kinx-project/kint/(threads)

Thread 1 (2020-07-09):

Teensy LC (kintlc) QMK support

stapelberg, 2020-07-09:

stapelberg, 2021-06-30:
I’ll close this as there hasn’t been any user interest in the `kintlc` variant. Please describe in this issue if/why you’re interested in that model, instead of e.g. the `kint40` or `kint41`.

aleb, 2022-07-11:
I did it

TODO: update the documentation.

stapelberg, 2022-07-12:
Hooray 🎉 I have updated the README to link to the now-merged PR until QMK does another release.

Closed 2021-06-30.

Thread 3 (2020-07-09):

Teensy 3.5 (kint35) QMK support

stapelberg, 2020-07-09:

stapelberg, 2021-06-30:
I’ll close this as there hasn’t been any user interest in the `kintlc` variant. Please describe in this issue if/why you’re interested in that model, instead of e.g. the `kint40` or `kint41`.

Closed 2021-06-30.

Thread 5 (2020-07-09):

Teensy 4.1 (kint41) QMK support

stapelberg, 2020-07-09:
## Status

* [x] milestone: light up LED
* [x] milestone: print debug messages on the serial port
* [x] milestone: light up a LED from ChibiOS
* [x] milestone: print debug messages on the serial port from ChibiOS
* [x] ChibiOS tests are passing successfully!
* [x] milestone: USB stack used successfully from ChibiOS

## USB

* the Teensy 4.1 has two USB 2.0 OTG controllers
* I’m trying to make controller `USB1` (base address `0x402E0000`) work (eval board: the USB port right next to the ethernet port, called “USB OTG” in the documentation, teensy 4.1: the main and only USB port)
* There are 5 different USB implementations I know of:
  1. [NXP SDK (usb_device_dci.c)](https://github.com/Masmiseim36/nxpSDK/blob/391fa6796a57efe0c95b506be6644021b6364f75/middleware/usb/device/usb_device_dci.c)
      * supports KHCI (USB Full Speed)
      * supports EHCI (USB High speed, what the Teensy 4.1 uses)
      * supports LPC USB IP3511 FS
      * supports LPC USB IP3511 HS
  1. [Paul Stoffregen’s official Arduino Teensy 4 core (usb.c)](https://github.com/PaulStoffregen/cores/blob/master/teensy4/usb.c)
      * Uses the EHCI interface, but also uses the teensy register macros, not NXP’s CMSIS.
  1. [ChibiOS-Contrib Kinetis (hal_usb_lld.c)](https://github.com/ChibiOS/ChibiOS-Contrib/blob/chibios-20.3.x/os/hal/ports/KINETIS/LLD/USBHSv1/hal_usb_lld.c)
      * The KINETIS hal_usb_lld.c uses the KHCI interface, which is not available on the Teensy 4.1 anymore.
      * Maybe we need to create a hal_usb_lld.c that uses the EHCI interface.
  1. The [stack in libgreat](https://github.com/greatscottgadgets/libgreat/blob/master/firmware/platform/lpc43xx/drivers/usb/usb_queue.c) is more readable/descriptive, but not 100% sure about correctness—might be better to prefer the NXP stack for now.
  1. Tamago’s USB stack: https://github.com/f-secure-foundry/tamago/tree/master/soc/imx6/usb

## Building

* You need https://github.com/ChibiOS/ChibiOS/commit/3249070d416831189da73676219723c24de04934 or newer ([fixes the interrupt vector table alignment for teensy 4.1](http://www.chibios.com/forum/viewtopic.php?f=35&t=5554))
* My ChibiOS-Contrib WIP branch can be found at https://github.com/stapelberg/ChibiOS-Contrib/commits/teensy41

## Wiring/testing

1. Connect a USB-to-serial adapter to teensy 4.1 pins G (GND), 16 (RX) and 17 (TX).
1. Build and flash the ChibiOS-Contrib teensy 4.1 demo:
    ```
    cd ChibiOS-Contrib/demos/MIMXRT1062/RT-TEENSY4_1
    make
    teensy-loader-cli -w -v --mcu=TEENSY40 build/ch.hex
    ```
1. After turning on the teensy 4.1, you should see debug messages on the serial console, followed by the ChibiOS test suites.

stapelberg, 2020-09-19:
Status update: as of commit https://github.com/stapelberg/ChibiOS-Contrib/commit/c6d4537b6afbdb407f88526c0d5bdc72e7449c3a, the ChibiOS serial usb device enumerates in my tests, and can be opened, but no data is sent/received over any endpoint but 0.

This line is where the device hangs: https://github.com/stapelberg/ChibiOS-Contrib/blob/c6d4537b6afbdb407f88526c0d5bdc72e7449c3a/os/hal/ports/MIMXRT1062/LLD/USBHSv1/hal_usb_lld.c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

Full log:
```
ISR
  setup ep=0
clear_out_queue
clear_out_queue, endpoint = 20002000, t = 00000000
_usb_ep0setup()
usb_lld_read_setup
bmRequestType = 00000000, bRequest = 00000009, wValue = 00000001, wIndex = 00000000, wLength = 00000000
usbcfg.c:usb_event(event=2)
usb_lld_init_endpoint(ep=1)
  OUT endpoint (RX enable), mode=2, maxsize=64
  IN endpoint (TX enable), mode=2, maxsize=64
usb_lld_init_endpoint(ep=2)
  IN endpoint (TX enable), mode=3, maxsize=16
usb_lld_start_out(ep=1)
usb_packet_receive(n=256)
usb_transfer_schedule(endpoint=20002080, transfer=2000327C, n=256, primebit=2, notify=1)

  ERROR: too many prime attempts, aborting
[…]
```

stapelberg, 2020-12-29:
Status update: I managed to build a working firmware!

I pushed the various changes to GitHub for now, and will clean them up and send them upstream later as time permits.

You can try the current state using:

```
qmk clone -b kint41 kinx-project/qmk_firmware
qmk compile -kb kinesis/kint41 -km default
teensy-loader-cli -w -v --mcu=TEENSY40 .build/kinesis_kint41_default.hex
```

stapelberg, 2021-03-27:
Status update: https://github.com/ChibiOS/ChibiOS-Contrib/pull/246 is now ready for review, and all repositories have been updated based on the current QMK develop branch.

The instructions in https://github.com/kinx-project/kint/issues/5#issuecomment-751999435 remain valid for trying out the firmware.

mdempsky, 2021-05-02:
With ChibiOS/ChibiOS-Contrib#246 merged, what's the status of this issue? Is there still more to do for the 4.1 to be fully supported? Thanks.

stapelberg, 2021-05-03:
> With [ChibiOS/ChibiOS-Contrib#246](https://github.com/ChibiOS/ChibiOS-Contrib/pull/246) merged, what's the status of this issue? Is there still more to do for the 4.1 to be fully supported? Thanks.

If you’re okay with building from my repository instead of QMK’s, then I consider the kint41 fully supported. I have been using a kint41 as my daily driver for weeks now, and have not noticed any issues. I know there is at least one other user without any issues.

QMK itself tracks their own branch of ChibiOS-Contrib which lags behind upstream, so for proper upstream support, my changes first need to make it into that branch. I want to ask QMK to cherry-pick, but wanted to finish some related work on keyboard latency to make sure I don’t ask prematurely (in case my work identifies other changes needed). Will probably ask next week or so.

mdempsky, 2021-05-03:
SGTM, Teensy 4.1 ordered. Thanks!

tsharky, 2021-05-30:
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

Hey,
I can't compile kinesis boards from your fork on my windows machine.
Both 'kint41' and 'kint2pp' give me an unicode error.

````
Ψ Compiling keymap with make -j 1 kinesis/kint41:default

QMK Firmware 0.9.32
Making kinesis/kint41 with keymap default

ERROR 'charmap' codec can't decode byte 0x90 in position 1558: character maps to <undefined>
Traceback (most recent call last):
  File "C:/tools/qmk_msys/mingw64/lib/python3.8/site-packages/milc/milc.py", line 476, in __call__
    return self.__call__()
  File "C:/tools/qmk_msys/mingw64/lib/python3.8/site-packages/milc/milc.py", line 479, in __call__
    return self._subcommand(self)
  File "C:/Projects/qmk_firmware_kinx-project/lib/python/qmk/decorators.py", line 42, in wrapper
    return func(*args, **kwargs)
  File "C:/Projects/qmk_firmware_kinx-project/lib/python/qmk/decorators.py", line 85, in wrapper
    return func(*args, **kwargs)
  File "C:/Projects/qmk_firmware_kinx-project/lib/python/qmk/cli/generate/rules_mk.py", line 58, in generate_rules_mk
    kb_info_json = dotty(info_json(cli.config.generate_rules_mk.keyboard))
  File "C:/Projects/qmk_firmware_kinx-project/lib/python/qmk/info.py", line 57, in info_json
    info_data = merge_info_jsons(keyboard, info_data)
  File "C:/Projects/qmk_firmware_kinx-project/lib/python/qmk/info.py", line 476, in merge_info_jsons
    new_info_data = json_load(info_file)
  File "C:/Projects/qmk_firmware_kinx-project/lib/python/qmk/json_schema.py", line 18, in json_load
    return hjson.load(json_file.open())
  File "C:/tools/qmk_msys/mingw64/lib/python3.8/site-packages/hjson/__init__.py", line 117, in load
    return loads(fp.read(),
  File "c:/tools/qmk_msys/mingw64/lib/python3.8/encodings/cp1252.py", line 23, in decode
    return codecs.charmap_decode(input,self.errors,decoding_table)[0]
UnicodeDecodeError: 'charmap' codec can't decode byte 0x90 in position 1558: character maps to <undefined>
build_keyboard.mk:104: 'UnicodeDecodeError'>: No such file or directory
make[1]: *** No rule to make target ''UnicodeDecodeError'>'.  Stop.
Make finished with errors
make: *** [Makefile:530: kinesis/kint41:default] Error 1
````

I can compile 'kint2pp' from the official qmk project without issues.
Any chance you know how to fix it?

I'm new to Kinesis and QMK, so I have no clue where to look for differences between your fork and qmk.

Greetings!

stapelberg, 2021-05-30:
> I can compile 'kint2pp' from the official qmk project without issues.
> Any chance you know how to fix it?

I rebased the kint41 branch on top of the current QMK development branch.

Possibly that fixes your problem (given that you say compiling QMK itself works).

Can you try cloning again and see if compilation now works?

If no, does compilation of kint36 work from the QMK upstream `develop` branch for you?

cadusk, 2021-05-31:
My issue is related to pin names.
Before fetching latest, builds were working.

Now looks like pin names that don't match this criteria will fail:
`pin[0] in 'ABCDEFGHIJK' and pin[1].isdigit()`

Here's the output of the error message
```
Ψ Compiling keymap with make -j 1 kinesis/kint41:default

QMK Firmware 0.9.32
Making kinesis/kint41 with keymap default

⚠ Nonstandard pin format: LINE_PIN20
⚠ Nonstandard pin format: LINE_PIN21
☒ Invalid API data: kinesis/kint41: matrix_pins.cols.0: 'LINE_PIN20' is not valid under any of the given schemas
arm-none-eabi-gcc (Arch Repository) 11.1.0
Copyright (C) 2021 Free Software Foundation, Inc.
This is free software; see the source for copying conditions.  There is NO
warranty; not even for MERCHANTABILITY or FITNESS FOR A PARTICULAR PURPOSE.

⚠ Nonstandard pin format: LINE_PIN20
⚠ Nonstandard pin format: LINE_PIN21
☒ Invalid API data: kinesis/kint41: matrix_pins.cols.0: 'LINE_PIN20' is not valid under any of the given schemas
⚠ Nonstandard pin format: LINE_PIN20
⚠ Nonstandard pin format: LINE_PIN21
☒ Invalid API data: kinesis/kint41: matrix_pins.cols.0: 'LINE_PIN20' is not valid under any of the given schemas
⚠ Nonstandard pin format: LINE_PIN20
⚠ Nonstandard pin format: LINE_PIN21
☒ Invalid API data: kinesis/kint41: matrix_pins.cols.0: 'LINE_PIN20' is not valid under any of the given schemas
Compiling: keyboards/kinesis/kinesis.c                                                             <command-line>: fatal error: .build/obj_kinesis_kint41/src/info_config.h: No such file or directory
compilation terminated.
 [ERRORS]
 |
 |
 |
make[1]: *** [tmk_core/rules.mk:436: .build/obj_kinesis_kint41_default/keyboards/kinesis/kinesis.o] Error 1
Make finished with errors
make: *** [Makefile:530: kinesis/kint41:default] Error 1

```

Also, builds of `kint2pp` and `kint36` build just fine.

stapelberg, 2021-05-31:
Sorry about that. Turns out clean builds were broken, but my working copy still had the required files lying around so I didn’t notice.

I pushed the old version for now, until I can properly fix the pin issue.

stapelberg, 2021-05-31:
Posted https://github.com/qmk/qmk_firmware/issues/13052 upstream to ask about how to approach the pin naming issue.

cadusk, 2021-05-31:
Thanks, Michael. It builds fine now.

stapelberg, 2021-06-02:
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

You can now find these changes in the `kint41-upstream` branch: https://github.com/kinx-project/qmk_firmware/commits/kint41-upstream

stapelberg, 2021-06-02:
Upstreaming status: the required core QMK pull requests have been sent:

* https://github.com/qmk/qmk_firmware/pull/13076
* https://github.com/qmk/qmk_firmware/pull/13077
* https://github.com/qmk/qmk_firmware/pull/13078

Once we figure out in https://github.com/qmk/qmk_firmware/issues/13052 what the pin defines should be called for the Teensy 4.x, I can update and send the kint41 keyboard addition itself upstream :)

tsharky, 2021-06-25:
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

For me it still did not build on a windows machine (upstream branch as well). In the meanwhile I worked with kint41 branch on a fedora vm and arch linux. That worked fine.

stapelberg, 2021-06-25:
> For me it still did not build on a windows machine (upstream branch as well)

You might want to file an issue at https://github.com/qmk/qmk_firmware/issues about that, then

stapelberg, 2021-06-30:
Support for the Teensy 4.0 and Teensy 4.1 (both via the `kint41` target) has been added to QMK in commit https://github.com/qmk/qmk_firmware/commit/f533d9e033e59d1eb98cc61fdb5f01eeccb827de (`develop` branch)! 🎉

gr4yscale, 2021-07-06:
@stapelberg Thanks for your work on this, and the previous iterations of the kinT board. I successfully compiled QMK for a Teensy 2.0++ with the `kint2pp` from master branch of `qmk/qmk_firmware`, and just love it! I got a Teensy 4.1 + kinT for my 2nd Kinesis, not having as much luck...

I compiled your fork [with the previous instructions](https://github.com/kinx-project/kint/issues/5#issuecomment-751999435), but I had an issue with bottom row keys not working - could be hw, but I wanted to first compile from the `develop` branch of `qmk/qmk_firmware`.

*develop branch of qmk_firmware seems very tricky to work with* It seems that the supported sub-commands such as `qmk compile` do not exist for develop branch. Using `qmk clone -b develop` to try to get the official branch doesn't help things, either. So it seems that `make` is the only supported way to build firmware on develop branch, which would be fine, except it seems broken? I've followed their [docs for the Makefile](https://beta.docs.qmk.fm/developing-qmk/qmk-reference/getting_started_make_guide).

This is more of a QMK question, but maybe you've encountered this. I've looked around a bit, no one seems to have problems using the develop branch. Furthermore, official tooling (qmk cli tool) seems to not approve of the `develop` branch:

```Path '/home/gr4yscale/qmk_firmware' exists but is not a qmk_firmware clone!```

It seems that the [version check line](https://github.com/qmk/qmk_firmware/blob/develop/Makefile#L559) in Makefile is causing a problem. I tried using `SKIP_VERSION=true`. Actually I see that the problem is with the `qmk_cli` tool which they call into using the `Makefile` to call into some python code. Mine is from the AUR (source repository for arch linux package) but maybe the problem is that it's out of sync with dev branch of qmk_firmware, but I don't see a dev branch, or any new commits on [qmk_cli master](https://github.com/qmk/qmk_cli/commits/master).

Actually, in writing this up, I discovered that [they very recently changed something about how they're parsing args](https://github.com/qmk/qmk_firmware/pull/13151). Probably something broke there. I tried reverting, since your changes came in after this:

```
❯ git revert bbe43a91ebf193bbc8c09ba59209b0524367e68c
Removing lib/python/qmk/cli/generate/version_h.py
[develop c709b4ee0] Revert "CLI: Add subcommand to generate version.h (#13151)"
 5 files changed, 45 insertions(+), 79 deletions(-)
 delete mode 100644 lib/python/qmk/cli/generate/version_h.py
```

Before reverting this, I got the following output:

```
❯ make kinesis/kint41:default:flash
QMK Firmware 0.13.5
usage: qmk [-h] [-V] [-v] [--datetime-fmt DATETIME_FMT] [--log-fmt LOG_FMT]
           [--log-file-fmt LOG_FILE_FMT]
           [--log-file-level {debug,info,warning,error,critical}]
           [--log-file LOG_FILE] [--color] [--no-color] [--unicode]
           [--no-unicode] [--interactive] [--config-file CONFIG_FILE]
           {config,clone,env,setup} ...
**qmk: error: argument {config,clone,env,setup}: invalid choice: 'generate-version-h' (choose from 'config', 'clone', 'env', 'setup')**
```

**Can you please tell me what version of `qmk_cli` you have?**

```
❯qmk -V
0.0.51

~/qmk_firmware develop ⇡
❯ make kinesis/kint41:default
QMK Firmware 0.13.19
ERROR: Cannot run "qmk hello"!

 Please run qmk setup to install all the dependencies QMK requires.

make: *** [Makefile:512: kinesis/kint41:default] Error 1

~/qmk_firmware develop ⇡
❯ qmk setup
☒ Path '/home/gr4yscale/qmk_firmware' exists but is not a qmk_firmware clone!
```
Note that I'm also always getting complaints about "qmk hello", and searching the qmk_cli repo on GH does not show anything about "hello"...

This is a nightmare! I have an injured hand, this is not helping, since my backup kinesis is at the office. Getting the other keyboard going was much much smoother. I am considering driving 30 minutes away to buy a teensy 2.0++ tomorrow and to desolder the Teensy 4.1. :(

Thanks in advance for any help.

stapelberg, 2021-07-06:
> compiled your fork [with the previous instructions](https://github.com/kinx-project/kint/issues/5#issuecomment-751999435), but I had an issue with bottom row keys not working - could be hw

Most likely. All keys should be working in all of the published firmware revisions.

> It seems that the supported sub-commands such as `qmk compile` do not exist for develop branch

This is not what I’m seeing:

```
~/kinx/workspace/qmk_firmware develop % qmk compile -km stapelberg -kb kinesis/kint41    
Ψ Compiling keymap with make -j 1 kinesis/kint41:stapelberg

QMK Firmware 0.13.19
Making kinesis/kint41 with keymap stapelberg

arm-none-eabi-gcc (Arch Repository) 11.1.0
Copyright (C) 2021 Free Software Foundation, Inc.
This is free software; see the source for copying conditions.  There is NO
warranty; not even for MERCHANTABILITY or FITNESS FOR A PARTICULAR PURPOSE.

Size before:
   text	   data	    bss	    dec	    hex	filename
      0	  36446	      0	  36446	   8e5e	.build/kinesis_kint41_stapelberg.hex

Compiling: quantum/command.c                                                                        [OK]
Linking: .build/kinesis_kint41_stapelberg.elf                                                       [OK]
Creating binary load file for flashing: .build/kinesis_kint41_stapelberg.bin                        [OK]
Creating load file for flashing: .build/kinesis_kint41_stapelberg.hex                               [OK]

Size after:
   text	   data	    bss	    dec	    hex	filename
      0	  36446	      0	  36446	   8e5e	.build/kinesis_kint41_stapelberg.hex

Copying kinesis_kint41_stapelberg.bin to qmk_firmware folder                                        [OK]
(Firmware size check does not yet support cortex-m4 microprocessors; skipping.)
```

Try uninstalling all QMK packages from the AUR, then install the QMK CLI from your repo as per the QMK instructions (using pip).

You can always consider starting a different Linux distribution using docker, too, and building there.

gr4yscale, 2021-07-06:
@stapelberg Some good news (and apologies for the longreads + frustration!) Compiling from `develop`

Apparently `pip` version of `qmk_cli` is out of date. The version that I get from [Arch User Repository](https://aur.archlinux.org/packages/qmk-git/) is correct. Still surprised why I didn't see anything searching with GH search tool for "hello" ...perhaps case sensitivity, I didn't clone and `ack` or `grep` it.

Apparently `qmk setup` or something else installed the `pip` version behind my back... After removing that, and hacking the `Makefile` temporarily to reference `/usr/bin/qmk` things are moving...

```
make -d kinesis/kint41:default
...
Successfully remade target file 'kinesis/kint41:default'.
```

**I also needed to not invoke make with sudo, to get the qmk bin to be found. Will check into that.**

```
❯ qmk hello
Ψ Hello, World!
```

I see your message came through after I wrote this. Thank you for the quick response! Actually, I had tried removing the QMK packages from AUR first, and went with straight `pip` packages, but was having troubles. Still, that is the most logical to me as well. I'll build up a clean dev environment using docker as you suggest.

Thanks again for the quick help! You're amazing. I'll now move on to testing those bottom row keys...it's likely just the jumper cable not tucked in tightly, I believe the solder joints are good.

One more quick question: ** I noticed that we can't enable console with `CONSOLE_ENABLE = yes`, which means no using `hid_listen` for debugging - at least that was the case in your previous fork. Is that now resolved? **

gr4yscale, 2021-07-06:
@stapelberg Just to say thanks again, and that I noticed that you (or someone) managed to get console debugging working with `CONSOLE_ENABLE = yes`, which means it's now possible to use `hid_listen` for debugging - in the previous fork, it was causing the kb to be unresponsive.

Great work! :) Let me know if I can test anything or help in any way with any remaining tasks.

gr4yscale, 2021-07-06:
@stapelberg Indeed the column 4 missing was a bad solder joint, probably broke after I cut pin headers down.

Thanks to your diligent work on the silk screens and schematic, it was a breeze to identify the offending connection.

Very inspiring stuff; I am ready to try designing a board with KiCad. Learned a lot of theory and some basics of eagle, but KiCad is much more appealing given that it's FOSS and thus easier to learn in together with a group.

Thanks again!

stapelberg, 2021-07-07:
Glad to hear you could get it to work 👍

tamsky, 2021-07-24:
> @stapelberg Just to say thanks again, and that I noticed that you (or someone) managed to get console debugging working with CONSOLE_ENABLE = yes, which means it's now possible to use hid_listen for debugging - in the previous fork, it was causing the kb to be unresponsive.

I'm currently unable to get CONSOLE_ENABLE working on a teensy 4.0.

Compiling your qmk kinesis/kint41 with `CONSOLE_ENABLE = yes` set in the `rules.mk` file,
neither `qmk console` nor `hid_listen` are able to connect to the kint41 firmware after it boots.

Only when I press the teensy's reset button while running `qmk console`, it does print anything other than "Looking for devices..."
```
Looking for devices...                                                                       
<hit reset button on teensy here>
Ψ Bootloader Connected: halfkay: Teensy Halfkay
```

Questions:

- Are there a set of steps that can help confirm that `CONSOLE_ENABLE = yes` is having the intended effect on the resulting qmk Teensy 4.0 firmware ?
- Perhaps there's an additional USB device that should show up when it's working as expected?  How to identify it?
- What's the correct tool to use to listen to the enabled console's debug messages?
   `hid_listen` apparently does not directly support anything other than teensy 2.x boards (and earlier).

stapelberg, 2021-07-24:
> Compiling your qmk kinesis/kint41 with `CONSOLE_ENABLE = yes` set in the `rules.mk` file,

In which rules.mk file specifically are you putting this line?

For me, it did not work in `keyboards/kinesis/kint41/rules.mk`, but it worked in my custom keymap `keyboards/kinesis/keymaps/stapelberg/rules.mk`

tamsky, 2021-07-24:
Amazing and helpful news.  Thank you.

Yes, I was adding `CONSOLE_ENABLE = yes` to `keyboards/kinesis/kint41/rules.mk`, because none of the docs specify to add it to the `.../keymaps/*/rules.mk`.   Both `qmk console` and `hid_listen` now work as expected.

Would you consider this a makefile or QMK bug -- should I report it upstream?

----
Now I can proceed to debug my Row/Col issues using your code from
https://michael.stapelberg.ch/posts/2021-05-08-keyboard-input-latency-qmk-kinesis/
```c
void keyboard_post_init_user() {
  debug_config.enable = true;
  debug_config.matrix = true;
}
```

tamsky, 2021-07-24:
> > hid_listen apparently does not directly support anything other than teensy 2.x boards (and earlier).
>
> AFAIR, `hid_listen` works just as well with the newer Teensy models.

I agree it's now working for me, but I'm definitely also curious what you think of Paul's reply here on this topic:
- https://forum.pjrc.com/threads/67784-Is-Teensy-4-0-compatible-with-hid_listen?p=284301&viewfull=1#post284301

stapelberg, 2021-07-25:
> Would you consider this a makefile or QMK bug -- should I report it upstream?

Yes, please report this upstream. I don’t know why it only works in one place, and ran into this issue myself :)

> I agree it's now working for me, but I'm definitely also curious what you think of Paul's reply here on this topic:

I think Paul’s talking about out hid_listen working *of the box* with the Teensy software stack. QMK already provides a bunch of different USB devices regardless of the underlying stack, and can easily keep doing that regardless of what the Teensy stack does. On the USB protocol level, the hid_listen approach works fine even for non-Teensy microcontrollers.

gregschlom, 2021-08-06:
I'm getting the following error when I try to compile :

/lib/chibios-contrib/os/common/startup/ARMCMx/devices/MIMXRT1062/cmparams.h:70:24: fatal error: MIMXRT1062.h: No such file or directory

This is on branch `develop` of QMK, compiling with `qmk compile -km stapelberg -kb kinesis/kint41`

Any help would be appreciated!

stapelberg, 2021-08-06:
> EDIT: Nevermind, the issue was that I was building from QMK's repo. Switching to kinx-project/qmk_firmware fixed the issue.

No, you should be able to build from QMK’s repo. The kinx-project/qmk_firmware repo is not maintained (it’s old).

Your build issue sounds like you didn’t have all the submodules set up correctly. `make git-submodule` should probably fix this.

brandondees, 2021-10-30:
From the above it seemed as if just running this from the normal QMK repo should be expected to work now, but it seems like something's missing here.

```
$ qmk flash -kb kinesis/kint41 -km default
Ψ Compiling keymap with make --jobs=1 kinesis/kint41:default:flash

QMK Firmware 0.14.29
Making kinesis/kint41 with keymap default and target flash

arm-none-eabi-gcc.exe (GCC) 10.1.0
Copyright (C) 2020 Free Software Foundation, Inc.
This is free software; see the source for copying conditions.  There is NO
warranty; not even for MERCHANTABILITY or FITNESS FOR A PARTICULAR PURPOSE.

Size before:
   text    data     bss     dec     hex filename
      0   39542       0   39542    9a76 .build/kinesis_kint41_default.hex

Compiling: quantum/command.c                                                                        [OK]
Linking: .build/kinesis_kint41_default.elf                                                          [OK]
Creating binary load file for flashing: .build/kinesis_kint41_default.bin                           [OK]
Creating load file for flashing: .build/kinesis_kint41_default.hex                                  [OK]
Copying kinesis_kint41_default.hex to qmk_firmware folder                                           [OK]

Size after:
   text    data     bss     dec     hex filename
      0   39542       0   39542    9a76 .build/kinesis_kint41_default.hex

Unknown MCU type "imxrt1062"
Supported MCUs are:
 - at90usb162
 - atmega32u4
 - at90usb646
 - at90usb1286
 - mkl26z64
 - mk20dx128
 - mk20dx256
 - mk66fx1m0
 - mk64fx512
make[1]: *** [platforms/chibios/flash.mk:82: flash] Error 1
Make finished with errors
make: *** [Makefile:510: kinesis/kint41:default:flash] Error 1
[Brandon@DESKTOP-JDED116 qmk_firmware]$
```

I'll probably go ahead and try the kinx-project fork next since that sounds like it should more definitely be able to work but I'd appreciate any help troubleshooting for this or else guidance on how to get whatever's the current best-available level of feature support.

BTW thanks @stapelberg for the excellent kit.

stapelberg, 2021-10-31:
> From the above it seemed as if just running this from the normal QMK repo should be expected to work now, but it seems like something's missing here.

Yeah, it should definitely be expected to work.

If building from the official QMK doesn’t work for anyone, it’s often best to check there for issues, or just try building an older version of QMK :)

For your specific case, this error message:

> Unknown MCU type "imxrt1062"
> Supported MCUs are:

…sounds like it comes from the teensy-loader-cli program: https://www.pjrc.com/teensy/loader.html

Are you sure you have a recent-enough version installed? Sounds like the one you have doesn’t know about the Teensy 4 yet.

brandondees, 2021-10-31:
Ah thanks for that clue, I would never have made the connection. Looking into how to get latest teensy loader within QMK MSYS now...

Closed 2021-06-30.

Thread 6 (2020-08-01):

Bluetooth

SleepyBrett, 2020-08-01:
Whats the possibility of a slightly more complicated board (may require a multiplexer) with bluetooth support and lipo charging through the usb port? The adafruit feather has a nice through port lipo charging feature (though I think I did a pincount on the feather w/ bluetooth and found that a multiplexer would be required.

Other features that would be awesome, support of the built in LED windows, maybe with rgb leds.

As an aside, I'm super happy to see this rev to the old stapleberg board, I've got two modded advantage 1s and they make me very happy.

stapelberg, 2020-08-01:
> Whats the possibility of a slightly more complicated board (may require a multiplexer) with bluetooth support and lipo charging through the usb port? The adafruit feather has a nice through port lipo charging feature (though I think I did a pincount on the feather w/ bluetooth and found that a multiplexer would be required.

You’re welcome to build such a board based on this one, but I personally have neither time nor motivation to do bluetooth for my keyboards :)

> Other features that would be awesome, support of the built in LED windows, maybe with rgb leds.

What do you mean? The caps lock/numlock/keypad/scroll lock LEDs already are supported

> As an aside, I'm super happy to see this rev to the old stapleberg board, I've got two modded advantage 1s and they make me very happy.

Very glad to hear! Enjoy :)

SleepyBrett, 2020-08-01:
gotcha on the LEDs I saw the pads on the old stapleberg board but could never quite got around to making them work.

I'll let you know if I make any progress on the bluetooth!

stapelberg, 2020-08-02:
> gotcha on the LEDs I saw the pads on the old stapleberg board but could never quite got around to making them work.

Ah, alright! With the new revision, I know that they are working for sure, so let me know if you run into any trouble and we should be able to figure it out :)

Closed 2020-08-01.

Thread 7 (2020-08-08):

RESET quantum keycode does not work with Teensy 3.6

ameyp, 2020-08-08:
I've modded my Advantage 1 with a Teensy 3.6 and the RESET [quantum keycode](https://beta.docs.qmk.fm/using-qmk/simple-keycodes/quantum_keycodes) doesn't seem to work. When I run `qmk flash` and qmk is at `Waiting for Teensy device... (hint: press the reset button)`, sending the RESET keycode with a keypress doesn't put the board in bootloader mode and I have to press the physical button to allow flashing to proceed.

stapelberg, 2020-08-09:
Thanks for the report. I indeed never tested this, because I had just assumed that reset is only for restarting the keyboard, not for reprogramming it :)

https://www.pjrc.com/teensy/jump_to_bootloader.html is relevant, but doesn’t contain an address for the Teensy 3.6.

Let me see if this might be an easy fix.

stapelberg, 2020-08-09:
Looks like on the Teensy 3.x, we need to call the BKPT instruction: https://forum.pjrc.com/threads/30521-Rebooting-Teensy-(LC-3-0)-to-bootloader-without-Teensyduino

stapelberg, 2020-08-09:
I think commit https://github.com/kinx-project/qmk_firmware/commit/bb8ab07b477b8de7175db24a04e1a3569028da98 might help, but can’t test it right now. Can you `git pull` in your branch, recompile, reflash, and try again?

stapelberg, 2020-08-09:
Just had a chance to test, and with the commit, the QK_RESET keycode jumps to the bootloader for me :)

ameyp, 2020-08-09:
Works for me too, thanks!

lread, 2023-08-05:
Oh, this is cool, I can flash via my Teensy without having to press the button on the Teensy?

I think `RESET` might have since been renamed to `QK_BOOTLOADER` in [commit](https://github.com/qmk/qmk_firmware/commit/b45a037c7edcd9c1cfadceb69ed51e7d42aa58c1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).

lread, 2023-08-05:
Oh. Interesting, I see `QK_BOOT` is now mapped to the `prgm` key in the default `keymap.c`.

lread, 2023-08-05:
And it actually works! Noice!

@stapelberg This is very handy, especially for folks who put the screws back in their keyboards! I'm happy to add a note to the README, if you agree that makes sense.

stapelberg, 2023-08-06:
> @stapelberg This is very handy, especially for folks who put the screws back in their keyboards! I'm happy to add a note to the README, if you agree that makes sense.

Sure, I guess? This is a standard QMK feature, so a quick note with a link to their documentation should be sufficient.

lread, 2023-08-06:
Thanks for the reply! Because my motivation was to get my failing Advantage2 working again, I came to your project first first and then learned a bit about QMK. Maybe other folks come in knowing about QMK first. Anyway, your video really helped me with understanding how to solder things up and then flash. But, after watching it, maybe I missed it, but I naively never realized I could press a keyboard key to flash. I'll add a wee tip for other poor sods like me.

Closed 2020-08-09.

Thread 8 (2020-08-18):

Settings not persisted to EEPROM for Teensy 3.6

ameyp, 2020-08-18:
I've been using the `set_single_persistent_default_layer` function to switch base layers but the changes aren't persisted to EEPROM. I've also wired up a small LED strip and my understanding is that changes to RGB lights are persisted to EEPROM by QMK, but that's not working either. I believe QMK doesn't understand how to use the Teensy 3.6's EEPROM.

stapelberg, 2020-08-18:
Thanks for filing this.

Your guess that QMK doesn’t understand how to use the Teensy 3.6 EEPROM sounds the most likely to me, too.

I’ll try and take a look at what would need to be changed in the next few days as time permits.

stapelberg, 2020-08-24:
Can you update your branch so that commit https://github.com/kinx-project/qmk_firmware/commit/1f84198750751dded9e12626b725df94aa33c875 is included and try again?

For me, this looks like it might be enough to make the EEPROM work, but I have only done a very quick test.

ameyp, 2020-08-24:
For me it made the controller not boot up. None of the keys were responding, and even the ON led on the teensy was off.

stapelberg, 2020-08-24:
Can you try it with these changes please (changing CPU speed from 180MHz to 120MHz)?

```diff
modified   keyboards/kinesis/kint36/mcuconf.h
@@ -28,12 +28,12 @@

 /* PEE mode - 180 MHz system clock driving by 16 MHz xtal */
 #define KINETIS_MCG_MODE KINETIS_MCG_MODE_PEE
-#define KINETIS_PLLCLK_FREQUENCY 180000000UL  // 180 MHz (HSRUN)
-//#define KINETIS_PLLCLK_FREQUENCY 120000000UL  // 120 MHz (RUN)
+//#define KINETIS_PLLCLK_FREQUENCY 180000000UL  // 180 MHz (HSRUN)
+#define KINETIS_PLLCLK_FREQUENCY 120000000UL  // 120 MHz (RUN)
 #define KINETIS_SYSCLK_FREQUENCY KINETIS_PLLCLK_FREQUENCY
 #define KINETIS_BUSCLK_FREQUENCY 60000000UL
-#define KINETIS_FLASHCLK_FREQUENCY 28000000UL  // 28 MHz (HSRUN)
-//#define KINETIS_FLASHCLK_FREQUENCY 24000000UL  // 24 MHz (RUN)
+//#define KINETIS_FLASHCLK_FREQUENCY 28000000UL  // 28 MHz (HSRUN)
+#define KINETIS_FLASHCLK_FREQUENCY 24000000UL  // 24 MHz (RUN)

 #if KINETIS_PLLCLK_FREQUENCY == 180000000UL
 #    define KINETIS_CLKDIV1_OUTDIV1 1  // -> 0
```

ameyp, 2020-08-24:
Tried with those changes, same behavior. Are there any debug prints I can provide that might help you see what the MCU is doing?

stapelberg, 2020-08-24:
Not that I know of :-/

One thing you can try is whether the example EEPROM programs that come with https://www.pjrc.com/teensy/td_download.html work on your device. Specifically `eeprom_put` and `eeprom_get`.

Maybe one needs to run these first before the EEPROM starts working? Worth a try.

ameyp, 2020-08-25:
Tried running both examples, both passed and I saw success prints in the serial monitor after the _get sample. Also it seems to have changed something in my teensy: now when I flash a firmware built with this commit, the keyboard boots up and keys work. However, EEPROM still doesn't seem to be working at either frequency (layout isn't persisted across reboots) and some other funkiness happens, e.g. my `backspace` keycode is sent as a `\` instead.

stapelberg, 2020-08-25:
> Also it seems to have changed something in my teensy

Thanks for confirming. I have read that EEPROM partitioning might be a step that leaves behind a persistent change, but will need to read up on what exactly that means for us here.

> However, EEPROM still doesn't seem to be working at either frequency (layout isn't persisted across reboots

I wonder if this means that writing to the EEPROM doesn’t work yet, or if it’s something else entirely.

> some other funkiness happens, e.g. my `backspace` keycode is sent as a `\` instead.

Weird! Not sure why that is yet.

waitnextevent, 2020-10-09:
After reading the docs for the MK66FX1M0VMD18 and FlexMemory application notes, I've been wondering if it may make more sense in the context of the keyboard controller to use the FlexNVM module in the default D-Flash mode instead of partitioning it into EEE ("enhanced EEPROM") when servicing the QMK EEPROM r/w routines.

It's all the same flash memory; from what I gather applications in E-Flash mode are for very frequently changing data where the EEE state machine will spread out the memory's finite number of read/write cycles over a larger area (such as using 256k of of flash as a smaller 4k EEPROM block). When instead used in D-Flash mode, one can leverage the entire capacity of the chip and not have to partition it beyond the default (unless somebody has already partitioned their Teensy, at least). I doubt keyboard users will need the up to 100 million write cycles spec'd for the EEE config..

I'm looking to see if I can bring up the Via feature for QMK on the Teensy 3.6, which lets you update the keymap without having to recompile all the time (as the stock Kinesis fw nicely allows). Via also uses the QMK EEPROM abstractions and could benefit from having more memory available.

Seems to me the routines to write to EEPROM in QMK really mean "write to some sort of persistence on the chip" rather than "write to something the chip calls EEPROM literally",  meaning the EEPROM r/w calls could equally be implemented againt D-Flash for the board.

Thoughts?

stapelberg, 2020-10-09:
Thanks very much for investigating and weighing in!

What you write makes sense to me—any persistence should do, yes.

Please give your approach a try and share what you learn :)

stapelberg, 2021-05-18:
I have pushed branch https://github.com/stapelberg/qmk_firmware/commits/kint36-eeprom which makes the EEPROM work.

In case anyone wants to try it out and confirm that it works for them, that’d be much appreciated!

Thread 10 (2020-08-23):

Teensy 3.6 (kint36) advanced QMK features umbrella bug

stapelberg, 2020-08-23:
The following features are either known to not work, or have not yet been successfully tested yet:

* [x] EEPROM, for persistent settings
* [ ] [Audio](https://beta.docs.qmk.fm/using-qmk/hardware-features/feature_audio)
* [x] [RGB LED lighting](https://beta.docs.qmk.fm/using-qmk/hardware-features/lighting/feature_rgblight)

ameyp, 2020-08-25:
I've got RGB LED lighting working with this:

```
#define STM32_SYSCLK KINETIS_SYSCLK_FREQUENCY
#define NOP_FUDGE 0.4
#define RGB_DI_PIN LINE_PIN28
```

stapelberg, 2021-05-20:
> I've got RGB LED lighting working with this:

Thank you, @ameyp, I can confirm that RGB LED works for me, too!

I have filed https://github.com/kinx-project/kint/issues/36 for the audio support and will close this umbrella bug.

Closed 2021-05-20.

Thread 11 (2020-08-24):

Best way to connect thumb keys on k500

ecraven, 2020-08-24:
I've had a close look at the k500, I think I can probably unsolder the directly soldered connections for the thumb keys. You've kindly provided pin headers on your board, but is there some nice way to have a connector, not directly solder things together?
Thanks for any help with these questions ;)

stapelberg, 2020-08-24:
On the KB500, your best bet is to cut the cable (don’t bother unsoldering) and solder each pin to a pin header, like so:

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

ecraven, 2020-08-31:
great, that's what I've done, it works very well. Thanks!

jcbird, 2021-06-13:
Sorry to comment on a closed issue. But could you send a link to the exact part you used? Is this just a female header with the pins soldered to the pcb? Thank you so much!

stapelberg, 2021-06-13:
Yep, that’s all there is to it.

https://www.digikey.ch/product-detail/en/PPTC241LFBN-RC/S7022-ND/810162 is the part I used last time.

jcbird, 2021-06-13:
Thank you!

MrDeerly, 2023-03-07:
Sorry to dig out this old thread again, but there is still some unclarity for me.

Are the female connectors mentioned above plugged into the [Würth 61301011121](https://octopart.com/61301011121-w%C3%BCrth+elektronik-18818159?r=sp) and soldered to the cable, or are the connectors soldered to the board and the cable just plugged in?

In addition to that, would it be an option to solder the cable directly to the pin headers (i guess that's not what they're here for), or the board?

Last but not least, do you have any tips on how to strip the cable for the thumb keys? :)

Thanks in advance!

thatdutchguy, 2023-03-26:
In case someone else is wondering, I just went through this (kb500 usb) and I'll share my experiences:

> Sorry to dig out this old thread again, but there is still some unclarity for me.
>
> Are the female connectors mentioned above plugged into the [Würth 61301011121](https://octopart.com/61301011121-w%C3%BCrth+elektronik-18818159?r=sp) and soldered to the cable, or are the connectors soldered to the board and the cable just plugged in?

They are soldered to the cable, then plug into the pin headers on the KinT PCB.

> > `[kinT] --soldered-- [male headers] --plugged-- [female headers] --soldered-- [stock cable] --soldered-- [PCB]`

Yes, I think that's the way it is intended to be used.

> > `[kinT] --soldered-- [female headers] --plugged-- [stock cable] --soldered-- [PCB]`

The wires are pretty thin, so I don't think this would work well.

> In addition to that, would it be an option to solder the cable directly to the pin headers (i guess that's not what they're here for), or the board?

> > `[kinT] --soldered-- [male headers] --soldered-- [stock cable] --soldered-- [PCB]`
> > OR
> > `[kinT] --soldered-- [stock cable] --soldered-- [PCB]`

I suppose this would work but it would be kind of cumbersome/harder than using the female headers.

> Last but not least, do you have any tips on how to strip the cable for the thumb keys? :)

I cut into the strip lengthwise next to each wire a bit, then used a simple wire stripper (see images below). It's not elegant but it works 🙂.

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

Hope this helps

Closed 2020-08-31.

Thread 12 (2020-08-31):

Debugging problems with device showing up, but no keypresses registering.

ecraven, 2020-08-31:
Hello ;)
Just finished building one (kb500 with kint36). I left the thumb pads disconnected, but connected everything else, cloned your firmware branch, flashed it. The keyboard shows up, however pressing any button does nothing at all. Is there some way to debug this?
[working on arch linux, everything current. avr-gcc is 10 (which qmk warns about), but I don't think I have an older one to install :-/]
The device itself shows up fine in xinput and dmesg.
Thanks for any help!

stapelberg, 2020-08-31:
You’re referencing a branch, so I assume you’re talking about the Teensy 3.6 variant.

Can you try flashing the firmware files referenced in https://github.com/kinx-project/kint#installing-the-firmware using https://aur.archlinux.org/packages/teensy-loader/?

Also, what is the dmesg output when you connect the keyboard?

stapelberg, 2020-08-31:
Did you solder in LEDs? If yes, try enabling Caps Lock using your currently working keyboard while the kint36 is connected, too: you should see both the LEDs on your current keyboard *and* the LEDs on the kint36 light up as well.

ecraven, 2020-08-31:
Just tried flashing the hex files, and those seem to work ;) great!

So the problem seems to be my compiling / flashing, not the hardware.

Caps-Lock light up the led on my current keyboard, but not the one on the new board. The LEDs have a bar on the underside, I put that bar in the same direction as the bar in the LED symbol on the silkscreen, is that correct?

ecraven, 2020-08-31:
dmesg -T output:
```[Mon Aug 31 22:25:48 2020] usb 2-3: new full-speed USB device number 31 using xhci_hcd
[Mon Aug 31 22:25:48 2020] usb 2-3: New USB device found, idVendor=1209, idProduct=345c, bcdDevice= 0.01
[Mon Aug 31 22:25:48 2020] usb 2-3: New USB device strings: Mfr=1, Product=2, SerialNumber=3
[Mon Aug 31 22:25:48 2020] usb 2-3: Product: "https://github.com/kinx-project/kint"
[Mon Aug 31 22:25:48 2020] usb 2-3: Manufacturer: "https://github.com/stapelberg"
[Mon Aug 31 22:25:48 2020] usb 2-3: SerialNumber: 0
[Mon Aug 31 22:25:48 2020] input: "https://github.com/stapelberg" "https://github.com/kinx-project/kint" as /devices/pci0000:00/0000:00:14.0/usb2/2-3/2-3:1.0/0003:1209:345C.0024/input/input43
[Mon Aug 31 22:25:48 2020] hid-generic 0003:1209:345C.0024: input,hidraw4: USB HID v1.11 Keyboard ["https://github.com/stapelberg" "https://github.com/kinx-project/kint"] on usb-0000:00:14.0-3/input0
[Mon Aug 31 22:25:48 2020] input: "https://github.com/stapelberg" "https://github.com/kinx-project/kint" Mouse as /devices/pci0000:00/0000:00:14.0/usb2/2-3/2-3:1.1/0003:1209:345C.0025/input/input44
[Mon Aug 31 22:25:48 2020] input: "https://github.com/stapelberg" "https://github.com/kinx-project/kint" System Control as /devices/pci0000:00/0000:00:14.0/usb2/2-3/2-3:1.1/0003:1209:345C.0025/input/input45
[Mon Aug 31 22:25:48 2020] input: "https://github.com/stapelberg" "https://github.com/kinx-project/kint" Consumer Control as /devices/pci0000:00/0000:00:14.0/usb2/2-3/2-3:1.1/0003:1209:345C.0025/input/input46
[Mon Aug 31 22:25:48 2020] input: "https://github.com/stapelberg" "https://github.com/kinx-project/kint" Keyboard as /devices/pci0000:00/0000:00:14.0/usb2/2-3/2-3:1.1/0003:1209:345C.0025/input/input47
[Mon Aug 31 22:25:48 2020] hid-generic 0003:1209:345C.0025: input,hidraw5: USB HID v1.11 Mouse ["https://github.com/stapelberg" "https://github.com/kinx-project/kint"] on usb-0000:00:14.0-3/input1
```

ecraven, 2020-08-31:
Flashing my own compiled version:
```> QMK_HOME=/home/.../qmk_firmware qmk flash -kb kinesis/kint36 -km default
Ψ Compiling keymap with make kinesis/kint36:default:flash

QMK Firmware 0.9.32
Making kinesis/kint36 with keymap default and target flash

arm-none-eabi-gcc (Arch Repository) 10.2.0
Copyright (C) 2020 Free Software Foundation, Inc.
This is free software; see the source for copying conditions.  There is NO
warranty; not even for MERCHANTABILITY or FITNESS FOR A PARTICULAR PURPOSE.

Size before:
   text	   data	    bss	    dec	    hex	filename
      0	  22792	      0	  22792	   5908	.build/kinesis_kint36_default.hex

Compiling: tmk_core/common/command.c                                                                [OK]
Linking: .build/kinesis_kint36_default.elf                                                          [WARNINGS]
 |
 | /usr/lib/gcc/arm-none-eabi/10.2.0/../../../../arm-none-eabi/bin/ld:rules_memory.ld:285: warning: memory region `flash4' not declared
 | /usr/lib/gcc/arm-none-eabi/10.2.0/../../../../arm-none-eabi/bin/ld:rules_memory.ld:293: warning: memory region `flash5' not declared
 | /usr/lib/gcc/arm-none-eabi/10.2.0/../../../../arm-none-eabi/bin/ld:rules_memory.ld:301: warning: memory region `flash6' not declared
 | /usr/lib/gcc/arm-none-eabi/10.2.0/../../../../arm-none-eabi/bin/ld:rules_memory.ld:310: warning: memory region `flash7' not declared
 |
Creating binary load file for flashing: .build/kinesis_kint36_default.bin                           [OK]
Creating load file for flashing: .build/kinesis_kint36_default.hex                                  [OK]

Size after:
   text	   data	    bss	    dec	    hex	filename
      0	  22792	      0	  22792	   5908	.build/kinesis_kint36_default.hex

Copying kinesis_kint36_default.bin to qmk_firmware folder                                           [OK]
Teensy Loader, Command Line, Version 2.1
Read ".build/kinesis_kint36_default.hex": 22792 bytes, 2.2% usage
Found HalfKay Bootloader
Programming.......................
Booting
```
dmesg -T output (I've changed the names to Nex:Kint36, to see them):
```
[Mon Aug 31 22:26:27 2020] usb 2-3: new full-speed USB device number 32 using xhci_hcd
[Mon Aug 31 22:26:28 2020] usb 2-3: New USB device found, idVendor=16c0, idProduct=0478, bcdDevice= 1.03
[Mon Aug 31 22:26:28 2020] usb 2-3: New USB device strings: Mfr=0, Product=0, SerialNumber=1
[Mon Aug 31 22:26:28 2020] usb 2-3: SerialNumber: 000B38F0
[Mon Aug 31 22:26:28 2020] hid-generic 0003:16C0:0478.0026: hidraw4: USB HID v1.11 Device [HID 16c0:0478] on usb-0000:00:14.0-3/input0
[Mon Aug 31 22:26:31 2020] usb 2-3: USB disconnect, device number 32
[Mon Aug 31 22:26:33 2020] usb 2-3: new full-speed USB device number 33 using xhci_hcd
[Mon Aug 31 22:26:33 2020] usb 2-3: New USB device found, idVendor=1209, idProduct=345c, bcdDevice= 0.01
[Mon Aug 31 22:26:33 2020] usb 2-3: New USB device strings: Mfr=1, Product=2, SerialNumber=3
[Mon Aug 31 22:26:33 2020] usb 2-3: Product: "Kint36"
[Mon Aug 31 22:26:33 2020] usb 2-3: Manufacturer: "Nex"
[Mon Aug 31 22:26:33 2020] usb 2-3: SerialNumber: 0
[Mon Aug 31 22:26:33 2020] input: "Nex" "Kint36" as /devices/pci0000:00/0000:00:14.0/usb2/2-3/2-3:1.0/0003:1209:345C.0027/input/input48
[Mon Aug 31 22:26:33 2020] hid-generic 0003:1209:345C.0027: input,hidraw4: USB HID v1.11 Keyboard ["Nex" "Kint36"] on usb-0000:00:14.0-3/input0
[Mon Aug 31 22:26:33 2020] input: "Nex" "Kint36" Mouse as /devices/pci0000:00/0000:00:14.0/usb2/2-3/2-3:1.1/0003:1209:345C.0028/input/input49
[Mon Aug 31 22:26:33 2020] input: "Nex" "Kint36" System Control as /devices/pci0000:00/0000:00:14.0/usb2/2-3/2-3:1.1/0003:1209:345C.0028/input/input50
[Mon Aug 31 22:26:33 2020] input: "Nex" "Kint36" Consumer Control as /devices/pci0000:00/0000:00:14.0/usb2/2-3/2-3:1.1/0003:1209:345C.0028/input/input51
[Mon Aug 31 22:26:33 2020] input: "Nex" "Kint36" Keyboard as /devices/pci0000:00/0000:00:14.0/usb2/2-3/2-3:1.1/0003:1209:345C.0028/input/input52
[Mon Aug 31 22:26:33 2020] hid-generic 0003:1209:345C.0028: input,hidraw5: USB HID v1.11 Mouse ["Nex" "Kint36"] on usb-0000:00:14.0-3/input1
```

stapelberg, 2020-08-31:
Can you try reverting the latest commit https://github.com/kinx-project/qmk_firmware/commit/1f84198750751dded9e12626b725df94aa33c875 in your local branch, and see if that fixes things?

stapelberg, 2020-08-31:
> Caps-Lock light up the led on my current keyboard, but not the one on the new board. The LEDs have a bar on the underside, I put that bar in the same direction as the bar in the LED symbol on the silkscreen, is that correct?

Yes, the LED marker marks the cathode, which is labeled as C on the kinT. It sounds like you did it correctly.

ecraven, 2020-08-31:
Reverting the last commit seems to work. I still have to try a custom layout, but I now get all kinds of keys ;)
Thanks for helping, if there's anything I can do to help debug this problem, please just ask!

ecraven, 2020-08-31:
Are those warnings about "region flash{4,5,6,7} not declared" relevant?

stapelberg, 2020-08-31:
> Reverting the last commit seems to work. I still have to try a custom layout, but I now get all kinds of keys ;)
> Thanks for helping, if there's anything I can do to help debug this problem, please just ask!

Great! Clearly, there is still some work to be done on proper EEPROM support. I have reverted the commit for now: https://github.com/kinx-project/qmk_firmware/commit/9206570c5cb681f18300a30933262f7658ec5ba2

I might get back to your offer when I next touch the EEPROM code :)

> Are those warnings about "region flash{4,5,6,7} not declared" relevant?

No, these regions aren’t required. Ideally we should fix those warnings eventually.

stapelberg, 2020-08-31:
I’ll close this for now as the board seems to be working now. If there are other problems, let’s track them in individual GitHub issues.

Closed 2020-08-31.

Thread 13 (2020-08-31):

LEDs not working

ecraven, 2020-08-31:
I've soldered the resistors and LEDs in as follows, caps-lock does light the led in a second attached keyboard, but not in the one I built:
The SMD LEDs have a small bar on the back, I oriented that in the same direction as the bar of the diode symbol is on the silkscreen.
Is there a way to light up all the LEDs, for testing? How would I best debug this?

ecraven, 2020-08-31:
The LED tester on my multimeter lights them all up, with the Black probe connected to A and the Red to C. Is that the correct direction?

ecraven, 2020-08-31:
I tried changing direction of the caps-lock led (wow, smd *unsoldering* is much less fun than soldering), no luck :-/ any way to just toggle the leds with keys?

stapelberg, 2020-08-31:
I can expand on this tomorrow (it’s getting late), but https://github.com/kinx-project/qmk_firmware/blob/kint36/keyboards/kinesis/kint36/kint36.c is the file that handles the LEDs.

Maybe you can play around with that to learn something new. E.g., comment out led_set_kb() and set individual LEDs in led_init_ports().

Does the Teensy 3.6 power LED light up?

ecraven, 2020-08-31:
Yes, the power led lights up fine. I'll try tomorrow to just turn all leds on on startup. Thanks for the hint!

stapelberg, 2020-09-01:
Just tested it on my kint36: the LEDs work fine here.

When flashing the Teensy (i.e. after pressing the button), all LEDs turn on briefly for me.

Can you share whether you ordered the components (specifically LEDs and resistors) exactly as referenced on the kint page, or whether you made any adjustments?

---

> The LED tester on my multimeter lights them all up, with the Black probe connected to A and the Red to C. Is that the correct direction?

The black probe (COM) should be connected to the C (cathode) end.
For me, the LED doesn’t light up if I swap the probes around.
This doesn’t sound right to me, so maybe the mark is the wrong way around after all? Or your probes are swapped around?

---

Regarding expected multimeter measurements:

On the LED Anode (A), you should be measuring 3.3V always.

On the `LED_*` pins (12, 24, 25, 26, see https://github.com/kinx-project/kint/blob/master/schematic-v2020-06-30.pdf), you should be measuring 3.3V when the LED is turned off, and 0V when the LED is turned on.

---

> wow, smd _unsoldering_ is much less fun than soldering

My technique is to hold the SMD part with a tweezer, then heat up one end, heat up the other, heat up the first one again, and so on, in decreasing time intervals, until both ends stay hot enough that you can just pull the part from the board with the tweezer.

Counter-intuitively, adding a little solder (or flux directly) can help here.

ecraven, 2020-09-01:
i bought exactly the components on your list, via the link.
I think I soldered in all four in the wrong direction, now I moved caps-lock, which should be correct.
The LED lights up if I connect black -> C and red -> A (the connectors on the multimeter are color-coded, so the leads are plugged in correctly).
The LED also lights up if I put the red on A and the black on pin 12.
The LED does *not* light up if I put the red on the 3.3V pin (the one besides pin 23 on the teensy) and the black on pin 12 (which it should, if I read the schematic correctly).

ecraven, 2020-09-01:
I've tried to turn all the leds on all the time in code (which doesn't work), I measure the following:
3.3V on GND vs. the Cathode.
1.23V on GND vs. the Anode.
This seems incorrect..

stapelberg, 2020-09-01:
> This seems incorrect..

I will read your results more closely later, but try cleaning up all solder joints (and/or re-doing unclean-looking ones) and see if you have an accidental short somewhere. The continuity tester in your multimeter might be helpful.

ecraven, 2020-09-01:
I've done that, but I'll re-check with better lighting.
Could you tell me *where* the Cathodes go exactly? I've been trying to follow the traces, but they all go to pins which are not connected at all.

stapelberg, 2020-09-02:
Replying in order:

> The LED also lights up if I put the red on A and the black on pin 12.

Great! That is expected, and also what I’m seeing:

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

> The LED does _not_ light up if I put the red on the 3.3V pin (the one besides pin 23 on the teensy) and the black on pin 12 (which it should, if I read the schematic correctly).

The 3.3V pin besides pin 23 is not connected to anything, so that is expected, too, but doesn’t tell us anything.

---

> Could you tell me _where_ the Anodes go exactly? I've been trying to follow the traces, but they all go to through-holes with no pins in them :-/

All the anodes are connected to 3.3V, as per the schematic:

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

For looking at traces in kicad’s pcbnew, select “Do not show filled areas in zones” on the left-hand icon bar.

To highlight an individual pin and its connections, select the second tool from the top in the right-hand icon bar (“Highlight net”).

Highlighting one of the anodes results in:

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

> Edit: According to the kicad files, pins 27 (SCK0) and 28 (MOSI0) are connected to the 3.3V trace.

What makes you say that? As per the schematic:

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

…pin 27 is not connected (unless you close the Teensy++ compatibility solder jumper, which you must not do when using the Teensy 3.6), and pin 28 is never connected.

> The LED tester does not light up the LED when trying it with pin 27/28 and pin 12 (for caps-lock)

It’s not expected to. Try the actual 3.3V pins (two above pin 27, for example).

> Later edit: Is it possible, that those connections don't actually work on the PCB? If I try to measure resistance between the two pins, I _should_ be getting 0 Ohm, but I don't...

That sounds wrong. When I measure resistance between pin 27 and pin 28, I get 0 Ohm.

---

At this point, I think the next steps to verify are:

1. Disconnect the Teensy 3.6 from the kint board, give it power via USB, measure that pin 12 behaves as you expect (you should be measuring 3.3V when the LED is turned off, and 0V when the LED is turned on)
2. With the Teensy 3.6 disconnected, use your multimeter to measure continuity between pin 12 and all other pins. You should not find any connections. Pin 12 should go to the resistor connected to the caps lock LED cathode, and nowhere else.

ecraven, 2020-09-02:
Sorry, but I still don't understand, those 3.3V pins are not connected to anything? They are underneath the Teensy. Are they connected internally in some layer of the PCB?

stapelberg, 2020-09-02:
Did you maybe not put in the pin header for the 3.3V pins?

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

If no, I don’t understand what you mean with “underneath”?

ecraven, 2020-09-02:
Yes, i never did that :) sorry for the misunderstanding!

stapelberg, 2020-09-02:
Aha! No worries, glad we could figure it out :)

I’ll try to make this a little clearer on the page later.

> Is the 3.3v pin the only relevant one

Yep, see the schematic: only the 3.3V pin of these is connected.

I would have preferred to get 3.3V from a normal pin (top/bottom rows of pins), but unfortunately the power output pins vary between Teensy++ and the newer ones, hence the need to use the horizontal pin row.

ecraven, 2020-09-02:
So it would be sufficient to connect the 3.3 output of *my* teensy to one of the horizontal holes with a short lead? Then I don't have to unsolder the entire teensy :)

stapelberg, 2020-09-02:
Yes, that should be sufficient.

ecraven, 2020-09-02:
Great. Thank you very much again for your patience. I'll do that tonight, then report back. I'll try to get a good picture of the LEDs, so that maybe other people can see which way they should be oriented :)

stapelberg, 2020-09-02:
Ah, speaking of: the marker should be at the cathode (and the white line on the silk screen is supposed to be the marker).
Is this what you’re seeing now that you fixed orientation?
If no, a good picture of your LEDs would be good to get some clarity on the marker situation :)

ecraven, 2020-09-02:
Thanks again for all the help, things work perfectly now.
The LEDs need to be oriented so that the two very small green stripes (that come around them from the underside) are oriented towards the side that has the | of the diode symbol. I think the |-- on the underside needs to point towards the |, I oriented it so that the | of the underside is on the same side as the | on the diode symbol initially, which was incorrect.
Thank you very much for your help, now I "just" need to come up with a decent keymap, but liberal use of the Compose key and macros seems to work fine ;) One more kb500 and then a kb600 to go, thanks for making this possible! [Sorry for the ugly soldering, just an image to see the LEDs close up]
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

stapelberg, 2020-09-02:
> The LEDs need to be oriented so that the two very small green stripes (that come around them from the underside) are oriented towards the side that has the | of the diode symbol. I think the |-- on the underside needs to point towards the |, I oriented it so that the | of the underside is on the same side as the | on the diode symbol initially, which was incorrect.

Yes, that all sounds right, and matches what the data sheet at https://www.kingbrightusa.com/images/catalog/SPEC/APT3216QBC-D.pdf describes. Maybe you haven’t seen that? I have included it directly in the soldering instructions now.

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

ecraven, 2020-09-02:
Yea, I didn't see that. Sorry, could have avoided all my problems by looking at the instructions more :/ but I think I have everything figured out now, thanks again!

justrajdeep, 2024-07-15:
Hi
for Teensy 4.1 do we need to program the vertical header?

Closed 2020-09-02.

Thread 14 (2020-08-31):

rules.mk: AUTO_SHIFT_ENABLE = yes does not compile.

ecraven, 2020-08-31:
If I enable auto shift keys in rules.mk, I get compilation errors:
```Linking: .build/kinesis_kint36_default.elf                                                          [ERRORS]
 |
 | /usr/lib/gcc/arm-none-eabi/10.2.0/../../../../arm-none-eabi/bin/ld:rules_memory.ld:285: warning: memory region `flash4' not declared
 | /usr/lib/gcc/arm-none-eabi/10.2.0/../../../../arm-none-eabi/bin/ld:rules_memory.ld:293: warning: memory region `flash5' not declared
 | /usr/lib/gcc/arm-none-eabi/10.2.0/../../../../arm-none-eabi/bin/ld:rules_memory.ld:301: warning: memory region `flash6' not declared
 | /usr/lib/gcc/arm-none-eabi/10.2.0/../../../../arm-none-eabi/bin/ld:rules_memory.ld:310: warning: memory region `flash7' not declared
 | /usr/lib/gcc/arm-none-eabi/10.2.0/../../../../arm-none-eabi/bin/ld: /usr/lib/gcc/arm-none-eabi/10.2.0/../../../../arm-none-eabi/lib/thumb/v7e-m/nofp/libg.a(lib_a-abort.o): in function `abort':
 | abort.c:(.text.abort+0xa): undefined reference to `_exit'
 | /usr/lib/gcc/arm-none-eabi/10.2.0/../../../../arm-none-eabi/bin/ld: /usr/lib/gcc/arm-none-eabi/10.2.0/../../../../arm-none-eabi/lib/thumb/v7e-m/nofp/libg.a(lib_a-signalr.o): in function `_kill_r':
 | signalr.c:(.text._kill_r+0x12): undefined reference to `_kill'
 | /usr/lib/gcc/arm-none-eabi/10.2.0/../../../../arm-none-eabi/bin/ld: /usr/lib/gcc/arm-none-eabi/10.2.0/../../../../arm-none-eabi/lib/thumb/v7e-m/nofp/libg.a(lib_a-signalr.o): in function `_getpid_r':
 | signalr.c:(.text._getpid_r+0x0): undefined reference to `_getpid'
 | collect2: error: ld returned 1 exit status
 |
make[1]: *** [tmk_core/rules.mk:306: .build/kinesis_kint36_default.elf] Error 1
```
It seems that auto_shift_keys link in something that might be in error?

stapelberg, 2020-09-01:
I cannot reproduce this:
```
% qmk clone -b kint36 kinx-project/qmk_firmware
Cloning into '/tmp/autoshift/qmk_firmware'...
Submodule 'lib/chibios' (https://github.com/qmk/ChibiOS) registered for path 'lib/chibios'
Submodule 'lib/chibios-contrib' (https://github.com/ChibiOS/ChibiOS-Contrib) registered for path 'lib/chibios-contrib'
Submodule 'lib/googletest' (https://github.com/qmk/googletest) registered for path 'lib/googletest'
Submodule 'lib/lufa' (https://github.com/qmk/lufa) registered for path 'lib/lufa'
Submodule 'lib/printf' (https://github.com/qmk/printf) registered for path 'lib/printf'
Submodule 'lib/ugfx' (https://github.com/qmk/uGFX) registered for path 'lib/ugfx'
Submodule 'lib/vusb' (https://github.com/qmk/v-usb) registered for path 'lib/vusb'
Cloning into '/tmp/autoshift/qmk_firmware/lib/chibios'...
Cloning into '/tmp/autoshift/qmk_firmware/lib/chibios-contrib'...
Cloning into '/tmp/autoshift/qmk_firmware/lib/googletest'...
Cloning into '/tmp/autoshift/qmk_firmware/lib/lufa'...
Cloning into '/tmp/autoshift/qmk_firmware/lib/printf'...
Cloning into '/tmp/autoshift/qmk_firmware/lib/ugfx'...
Cloning into '/tmp/autoshift/qmk_firmware/lib/vusb'...
Submodule path 'lib/chibios': checked out '313416b8fda90d9973a749a0a35970956852c286'
Submodule path 'lib/chibios-contrib': checked out 'cdb7fe0bf476fc044aee68d86f8b88faa10668d3'
Submodule path 'lib/googletest': checked out 'ec44c6c1675c25b9827aacd08c02433cccde7780'
Submodule path 'lib/lufa': checked out 'ce10f7642b0459e409839b23cc91498945119b4d'
Submodule path 'lib/printf': checked out 'd3b984684bb8a8bdc48cc7a1abecb93ce59bbe3e'
Submodule path 'lib/ugfx': checked out '40b48f470addad6a4fb1177de1a69a181158739b'
Submodule path 'lib/vusb': checked out '9a42d205eb60faca494ff4eabce8d59f0ec0fc7f'
Ψ Successfully cloned https://github.com/kinx-project/qmk_firmware to /tmp/autoshift/qmk_firmware!
qmk clone -b kint36 kinx-project/qmk_firmware  19,90s user 3,21s system 66% cpu 34,775 total

% cd qmk_firmware

% echo AUTO_SHIFT_ENABLE = yes >> keyboards/kinesis/kint36/rules.mk

% qmk compile -kb kinesis/kint36 -km stapelberg
Ψ Compiling keymap with make kinesis/kint36:stapelberg

QMK Firmware 0.9.32
Making kinesis/kint36 with keymap stapelberg

arm-none-eabi-gcc (Arch Repository) 10.1.0
Copyright (C) 2020 Free Software Foundation, Inc.
This is free software; see the source for copying conditions.  There is NO
warranty; not even for MERCHANTABILITY or FITNESS FOR A PARTICULAR PURPOSE.

Compiling: keyboards/kinesis/kinesis.c                                                              [OK]
Compiling: keyboards/kinesis/kint36/kint36.c                                                        [OK]
Compiling: keyboards/kinesis/keymaps/stapelberg/keymap.c                                            [OK]
Compiling: quantum/quantum.c                                                                        [OK]
Compiling: quantum/keymap_common.c                                                                  [OK]
Compiling: quantum/keycode_config.c                                                                 [OK]
Compiling: quantum/matrix_common.c                                                                  [OK]
Compiling: quantum/matrix.c                                                                         [OK]
Compiling: quantum/debounce/sym_g.c                                                                 [OK]
Compiling: tmk_core/common/chibios/eeprom_teensy.c                                                  [OK]
Compiling: quantum/process_keycode/process_space_cadet.c                                            [OK]
Compiling: quantum/process_keycode/process_magic.c                                                  [OK]
Compiling: quantum/process_keycode/process_grave_esc.c                                              [OK]
Compiling: quantum/process_keycode/process_auto_shift.c                                             [OK]
Assembling: lib/chibios/os/common/startup/ARMCMx/compilers/GCC/crt0_v7m.S                           [OK]
Assembling: lib/chibios/os/common/startup/ARMCMx/compilers/GCC/vectors.S                            [OK]
Assembling: lib/chibios/os/common/ports/ARMCMx/compilers/GCC/chcoreasm_v7m.S                        [OK]
Compiling: tmk_core/common/host.c                                                                   [OK]
Compiling: tmk_core/common/keyboard.c                                                               [OK]
Compiling: tmk_core/common/action.c                                                                 [OK]
Compiling: tmk_core/common/action_tapping.c                                                         [OK]
Compiling: tmk_core/common/action_macro.c                                                           [OK]
Compiling: tmk_core/common/action_layer.c                                                           [OK]
Compiling: tmk_core/common/action_util.c                                                            [OK]
Compiling: tmk_core/common/print.c                                                                  [OK]
Compiling: tmk_core/common/debug.c                                                                  [OK]
Compiling: tmk_core/common/sendchar_null.c                                                          [OK]
Compiling: tmk_core/common/util.c                                                                   [OK]
Compiling: tmk_core/common/eeconfig.c                                                               [OK]
Compiling: tmk_core/common/report.c                                                                 [OK]
Compiling: tmk_core/common/chibios/suspend.c                                                        [OK]
Compiling: tmk_core/common/chibios/timer.c                                                          [OK]
Compiling: tmk_core/common/chibios/bootloader.c                                                     [OK]
Compiling: lib/printf/printf.c                                                                      [OK]
Compiling: tmk_core/common/magic.c                                                                  [OK]
Compiling: tmk_core/common/mousekey.c                                                               [OK]
Compiling: tmk_core/common/command.c                                                                [OK]
Compiling: tmk_core/protocol/chibios/usb_main.c                                                     [OK]
Compiling: tmk_core/protocol/chibios/main.c                                                         [OK]
Compiling: tmk_core/protocol/usb_descriptor.c                                                       [OK]
Compiling: tmk_core/protocol/chibios/usb_driver.c                                                   [OK]
Compiling: lib/chibios/os/oslib/src/chmboxes.c                                                      [OK]
Compiling: lib/chibios/os/oslib/src/chmemcore.c                                                     [OK]
Compiling: lib/chibios/os/oslib/src/chmemheaps.c                                                    [OK]
Compiling: lib/chibios/os/oslib/src/chmempools.c                                                    [OK]
Compiling: lib/chibios/os/oslib/src/chpipes.c                                                       [OK]
Compiling: lib/chibios/os/oslib/src/chfactory.c                                                     [OK]
Compiling: lib/chibios/os/common/startup/ARMCMx/compilers/GCC/crt1.c                                [OK]
Compiling: lib/chibios/os/rt/src/chsys.c                                                            [OK]
Compiling: lib/chibios/os/rt/src/chdebug.c                                                          [OK]
Compiling: lib/chibios/os/rt/src/chtrace.c                                                          [OK]
Compiling: lib/chibios/os/rt/src/chvt.c                                                             [OK]
Compiling: lib/chibios/os/rt/src/chschd.c                                                           [OK]
Compiling: lib/chibios/os/rt/src/chthreads.c                                                        [OK]
Compiling: lib/chibios/os/rt/src/chtm.c                                                             [OK]
Compiling: lib/chibios/os/rt/src/chstats.c                                                          [OK]
Compiling: lib/chibios/os/rt/src/chregistry.c                                                       [OK]
Compiling: lib/chibios/os/rt/src/chsem.c                                                            [OK]
Compiling: lib/chibios/os/rt/src/chmtx.c                                                            [OK]
Compiling: lib/chibios/os/rt/src/chcond.c                                                           [OK]
Compiling: lib/chibios/os/rt/src/chevents.c                                                         [OK]
Compiling: lib/chibios/os/rt/src/chmsg.c                                                            [OK]
Compiling: lib/chibios/os/rt/src/chdynamic.c                                                        [OK]
Compiling: lib/chibios/os/common/ports/ARMCMx/chcore.c                                              [OK]
Compiling: lib/chibios/os/common/ports/ARMCMx/chcore_v7m.c                                          [OK]
Compiling: lib/chibios/os/hal/osal/rt/osal.c                                                        [OK]
Compiling: lib/chibios/os/hal/src/hal.c                                                             [OK]
Compiling: lib/chibios/os/hal/src/hal_buffers.c                                                     [OK]
Compiling: lib/chibios/os/hal/src/hal_queues.c                                                      [OK]
Compiling: lib/chibios/os/hal/src/hal_mmcsd.c                                                       [OK]
Compiling: lib/chibios/os/hal/src/hal_adc.c                                                         [OK]
Compiling: lib/chibios/os/hal/src/hal_can.c                                                         [OK]
Compiling: lib/chibios/os/hal/src/hal_crypto.c                                                      [OK]
Compiling: lib/chibios/os/hal/src/hal_dac.c                                                         [OK]
Compiling: lib/chibios/os/hal/src/hal_gpt.c                                                         [OK]
Compiling: lib/chibios/os/hal/src/hal_i2c.c                                                         [OK]
Compiling: lib/chibios/os/hal/src/hal_i2s.c                                                         [OK]
Compiling: lib/chibios/os/hal/src/hal_icu.c                                                         [OK]
Compiling: lib/chibios/os/hal/src/hal_mac.c                                                         [OK]
Compiling: lib/chibios/os/hal/src/hal_mmc_spi.c                                                     [OK]
Compiling: lib/chibios/os/hal/src/hal_pal.c                                                         [OK]
Compiling: lib/chibios/os/hal/src/hal_pwm.c                                                         [OK]
Compiling: lib/chibios/os/hal/src/hal_rtc.c                                                         [OK]
Compiling: lib/chibios/os/hal/src/hal_sdc.c                                                         [OK]
Compiling: lib/chibios/os/hal/src/hal_serial.c                                                      [OK]
Compiling: lib/chibios/os/hal/src/hal_serial_usb.c                                                  [OK]
Compiling: lib/chibios/os/hal/src/hal_sio.c                                                         [OK]
Compiling: lib/chibios/os/hal/src/hal_spi.c                                                         [OK]
Compiling: lib/chibios/os/hal/src/hal_st.c                                                          [OK]
Compiling: lib/chibios/os/hal/src/hal_trng.c                                                        [OK]
Compiling: lib/chibios/os/hal/src/hal_uart.c                                                        [OK]
Compiling: lib/chibios/os/hal/src/hal_usb.c                                                         [OK]
Compiling: lib/chibios/os/hal/src/hal_wdg.c                                                         [OK]
Compiling: lib/chibios/os/hal/src/hal_wspi.c                                                        [OK]
Compiling: lib/chibios-contrib/os/hal/boards/PJRC_TEENSY_3_6/board.c                                [OK]
Compiling: lib/chibios/os/hal/lib/streams/chprintf.c                                                [OK]
Compiling: lib/chibios/os/hal/lib/streams/memstreams.c                                              [OK]
Compiling: lib/chibios/os/hal/lib/streams/nullstreams.c                                             [OK]
Compiling: lib/chibios/os/various/syscalls.c                                                        [OK]
Compiling: lib/chibios/os/hal/ports/common/ARMCMx/nvic.c                                            [OK]
Compiling: lib/chibios-contrib/os/hal/ports/KINETIS/MK66F18/hal_lld.c                               [OK]
Compiling: lib/chibios-contrib/os/hal/ports/KINETIS/LLD/PITv1/hal_st_lld.c                          [OK]
Compiling: lib/chibios-contrib/os/hal/ports/KINETIS/LLD/GPIOv1/hal_pal_lld.c                        [OK]
Compiling: lib/chibios-contrib/os/hal/ports/KINETIS/LLD/UARTv1/hal_serial_lld.c                     [OK]
Compiling: lib/chibios-contrib/os/hal/ports/KINETIS/LLD/SPIv1/hal_spi_lld.c                         [OK]
Compiling: lib/chibios-contrib/os/hal/ports/KINETIS/LLD/I2Cv1/hal_i2c_lld.c                         [OK]
Compiling: lib/chibios-contrib/os/hal/ports/KINETIS/LLD/PORTv1/hal_ext_lld.c                        [OK]
Compiling: lib/chibios-contrib/os/hal/ports/KINETIS/LLD/ADCv1/hal_adc_lld.c                         [OK]
Compiling: lib/chibios-contrib/os/hal/ports/KINETIS/LLD/PITv1/hal_gpt_lld.c                         [OK]
Compiling: lib/chibios-contrib/os/hal/ports/KINETIS/LLD/SDHCv1/hal_sdc_lld.c                        [OK]
Compiling: lib/chibios-contrib/os/hal/ports/KINETIS/LLD/FTMv1/hal_pwm_lld.c                         [OK]
Compiling: lib/chibios-contrib/os/hal/ports/KINETIS/LLD/USBHSv1/hal_usb_lld.c                       [OK]
Compiling: lib/chibios-contrib/os/hal/src/hal_community.c                                           [OK]
Compiling: lib/chibios-contrib/os/hal/src/hal_fsmc.c                                                [OK]
Compiling: lib/chibios-contrib/os/hal/src/hal_nand.c                                                [OK]
Compiling: lib/chibios-contrib/os/hal/src/hal_sram.c                                                [OK]
Compiling: lib/chibios-contrib/os/hal/src/hal_sdram.c                                               [OK]
Compiling: lib/chibios-contrib/os/hal/src/hal_onewire.c                                             [OK]
Compiling: lib/chibios-contrib/os/hal/src/hal_eicu.c                                                [OK]
Compiling: lib/chibios-contrib/os/hal/src/hal_crc.c                                                 [OK]
Compiling: lib/chibios-contrib/os/hal/src/hal_rng.c                                                 [OK]
Compiling: lib/chibios-contrib/os/hal/src/hal_usbh.c                                                [OK]
Compiling: lib/chibios-contrib/os/hal/src/usbh/hal_usbh_debug.c                                     [OK]
Compiling: lib/chibios-contrib/os/hal/src/usbh/hal_usbh_desciter.c                                  [OK]
Compiling: lib/chibios-contrib/os/hal/src/usbh/hal_usbh_hub.c                                       [OK]
Compiling: lib/chibios-contrib/os/hal/src/usbh/hal_usbh_msd.c                                       [OK]
Compiling: lib/chibios-contrib/os/hal/src/usbh/hal_usbh_ftdi.c                                      [OK]
Compiling: lib/chibios-contrib/os/hal/src/usbh/hal_usbh_aoa.c                                       [OK]
Compiling: lib/chibios-contrib/os/hal/src/usbh/hal_usbh_hid.c                                       [OK]
Compiling: lib/chibios-contrib/os/hal/src/usbh/hal_usbh_uvc.c                                       [OK]
Compiling: lib/chibios-contrib/os/hal/src/hal_ee24xx.c                                              [OK]
Compiling: lib/chibios-contrib/os/hal/src/hal_ee25xx.c                                              [OK]
Compiling: lib/chibios-contrib/os/hal/src/hal_eeprom.c                                              [OK]
Compiling: lib/chibios-contrib/os/hal/src/hal_timcap.c                                              [OK]
Compiling: lib/chibios-contrib/os/hal/src/hal_qei.c                                                 [OK]
Compiling: lib/chibios-contrib/os/hal/src/hal_usb_hid.c                                             [OK]
Compiling: lib/chibios-contrib/os/hal/src/hal_usb_msd.c                                             [OK]
Compiling: lib/chibios-contrib/os/hal/src/hal_comp.c                                                [OK]
Compiling: lib/chibios-contrib/os/hal/src/hal_opamp.c                                               [OK]
Linking: .build/kinesis_kint36_stapelberg.elf                                                       [WARNINGS]
 |
 | /usr/lib/gcc/arm-none-eabi/10.1.0/../../../../arm-none-eabi/bin/ld:rules_memory.ld:285: warning: memory region `flash4' not declared
 | /usr/lib/gcc/arm-none-eabi/10.1.0/../../../../arm-none-eabi/bin/ld:rules_memory.ld:293: warning: memory region `flash5' not declared
 | /usr/lib/gcc/arm-none-eabi/10.1.0/../../../../arm-none-eabi/bin/ld:rules_memory.ld:301: warning: memory region `flash6' not declared
 | /usr/lib/gcc/arm-none-eabi/10.1.0/../../../../arm-none-eabi/bin/ld:rules_memory.ld:310: warning: memory region `flash7' not declared
 |
Creating binary load file for flashing: .build/kinesis_kint36_stapelberg.bin                        [OK]
Creating load file for flashing: .build/kinesis_kint36_stapelberg.hex                               [OK]

Size after:
   text	   data	    bss	    dec	    hex	filename
      0	  32792	      0	  32792	   8018	.build/kinesis_kint36_stapelberg.hex

Copying kinesis_kint36_stapelberg.bin to qmk_firmware folder                                        [OK]
(Firmware size check does not yet support cortex-m4 microprocessors; skipping.)

```

ecraven, 2020-09-01:
Can you try `-km default`? That fails for me :-/

stapelberg, 2020-09-02:
Thanks for the details.

I can reproduce this with a clean upstream checkout on another ChibiOS-based board:

```
% make matrix/noah:default                  
QMK Firmware 0.10.2
Making matrix/noah with keymap default

arm-none-eabi-gcc (Arch Repository) 10.1.0
Copyright (C) 2020 Free Software Foundation, Inc.
This is free software; see the source for copying conditions.  There is NO
warranty; not even for MERCHANTABILITY or FITNESS FOR A PARTICULAR PURPOSE.

Compiling: drivers/chibios/ws2812.c                                                                 [OK]
Compiling: keyboards/matrix/noah/matrix.c                                                           [OK]
Compiling: keyboards/matrix/noah/noah.c                                                             [OK]
Compiling: keyboards/matrix/noah/keymaps/default/keymap.c                                           [OK]
Compiling: quantum/quantum.c                                                                        [OK]
Compiling: quantum/keymap_common.c                                                                  [OK]
Compiling: quantum/keycode_config.c                                                                 [OK]
Compiling: quantum/debounce/sym_g.c                                                                 [OK]
Compiling: tmk_core/common/chibios/eeprom_teensy.c                                                  [OK]
Compiling: quantum/color.c                                                                          [OK]
Compiling: quantum/rgblight.c                                                                       [OK]
Compiling: quantum/rgb_matrix.c                                                                     [OK]
Compiling: quantum/rgb_matrix_drivers.c                                                             [OK]
Compiling: drivers/issi/is31fl3731.c                                                                [OK]
Compiling: quantum/process_keycode/process_rgb.c                                                    [OK]
Compiling: quantum/led_tables.c                                                                     [OK]
Compiling: quantum/process_keycode/process_space_cadet.c                                            [OK]
Compiling: quantum/process_keycode/process_magic.c                                                  [OK]
Compiling: quantum/process_keycode/process_grave_esc.c                                              [OK]
Compiling: drivers/chibios/i2c_master.c                                                             [OK]
Archiving: .build/obj_matrix_noah_default/i2c_master.o                                              [OK]
Assembling: lib/chibios/os/common/startup/ARMCMx/compilers/GCC/crt0_v7m.S                           [OK]
Assembling: lib/chibios/os/common/startup/ARMCMx/compilers/GCC/vectors.S                            [OK]
Assembling: lib/chibios/os/common/ports/ARMCMx/compilers/GCC/chcoreasm_v7m.S                        [OK]
Compiling: tmk_core/common/host.c                                                                   [OK]
Compiling: tmk_core/common/keyboard.c                                                               [OK]
Compiling: tmk_core/common/action.c                                                                 [OK]
Compiling: tmk_core/common/action_tapping.c                                                         [OK]
Compiling: tmk_core/common/action_macro.c                                                           [OK]
Compiling: tmk_core/common/action_layer.c                                                           [OK]
Compiling: tmk_core/common/action_util.c                                                            [OK]
Compiling: tmk_core/common/print.c                                                                  [OK]
Compiling: tmk_core/common/debug.c                                                                  [OK]
Compiling: tmk_core/common/sendchar_null.c                                                          [OK]
Compiling: tmk_core/common/util.c                                                                   [OK]
Compiling: tmk_core/common/eeconfig.c                                                               [OK]
Compiling: tmk_core/common/report.c                                                                 [OK]
Compiling: tmk_core/common/chibios/suspend.c                                                        [OK]
Compiling: tmk_core/common/chibios/timer.c                                                          [OK]
Compiling: tmk_core/common/chibios/bootloader.c                                                     [OK]
Compiling: lib/printf/printf.c                                                                      [OK]
Compiling: tmk_core/common/bootmagic.c                                                              [OK]
Compiling: tmk_core/common/mousekey.c                                                               [OK]
Compiling: tmk_core/protocol/chibios/usb_main.c                                                     [OK]
Compiling: tmk_core/protocol/chibios/main.c                                                         [OK]
Compiling: tmk_core/protocol/usb_descriptor.c                                                       [OK]
Compiling: tmk_core/protocol/chibios/usb_driver.c                                                   [OK]
Compiling: lib/chibios/os/oslib/src/chmboxes.c                                                      [OK]
Compiling: lib/chibios/os/oslib/src/chmemcore.c                                                     [OK]
Compiling: lib/chibios/os/oslib/src/chmemheaps.c                                                    [OK]
Compiling: lib/chibios/os/oslib/src/chmempools.c                                                    [OK]
Compiling: lib/chibios/os/oslib/src/chpipes.c                                                       [OK]
Compiling: lib/chibios/os/oslib/src/chfactory.c                                                     [OK]
Compiling: lib/chibios/os/common/startup/ARMCMx/compilers/GCC/crt1.c                                [OK]
Compiling: lib/chibios/os/rt/src/chsys.c                                                            [OK]
Compiling: lib/chibios/os/rt/src/chdebug.c                                                          [OK]
Compiling: lib/chibios/os/rt/src/chtrace.c                                                          [OK]
Compiling: lib/chibios/os/rt/src/chvt.c                                                             [OK]
Compiling: lib/chibios/os/rt/src/chschd.c                                                           [OK]
Compiling: lib/chibios/os/rt/src/chthreads.c                                                        [OK]
Compiling: lib/chibios/os/rt/src/chtm.c                                                             [OK]
Compiling: lib/chibios/os/rt/src/chstats.c                                                          [OK]
Compiling: lib/chibios/os/rt/src/chregistry.c                                                       [OK]
Compiling: lib/chibios/os/rt/src/chsem.c                                                            [OK]
Compiling: lib/chibios/os/rt/src/chmtx.c                                                            [OK]
Compiling: lib/chibios/os/rt/src/chcond.c                                                           [OK]
Compiling: lib/chibios/os/rt/src/chevents.c                                                         [OK]
Compiling: lib/chibios/os/rt/src/chmsg.c                                                            [OK]
Compiling: lib/chibios/os/rt/src/chdynamic.c                                                        [OK]
Compiling: lib/chibios/os/common/ports/ARMCMx/chcore.c                                              [OK]
Compiling: lib/chibios/os/common/ports/ARMCMx/chcore_v7m.c                                          [OK]
Compiling: lib/chibios/os/hal/osal/rt/osal.c                                                        [OK]
Compiling: lib/chibios/os/hal/src/hal.c                                                             [OK]
Compiling: lib/chibios/os/hal/src/hal_buffers.c                                                     [OK]
Compiling: lib/chibios/os/hal/src/hal_queues.c                                                      [OK]
Compiling: lib/chibios/os/hal/src/hal_mmcsd.c                                                       [OK]
Compiling: lib/chibios/os/hal/src/hal_adc.c                                                         [OK]
Compiling: lib/chibios/os/hal/src/hal_can.c                                                         [OK]
Compiling: lib/chibios/os/hal/src/hal_crypto.c                                                      [OK]
Compiling: lib/chibios/os/hal/src/hal_dac.c                                                         [OK]
Compiling: lib/chibios/os/hal/src/hal_gpt.c                                                         [OK]
Compiling: lib/chibios/os/hal/src/hal_i2c.c                                                         [OK]
Compiling: lib/chibios/os/hal/src/hal_i2s.c                                                         [OK]
Compiling: lib/chibios/os/hal/src/hal_icu.c                                                         [OK]
Compiling: lib/chibios/os/hal/src/hal_mac.c                                                         [OK]
Compiling: lib/chibios/os/hal/src/hal_mmc_spi.c                                
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

Thread 15 (2020-09-09):

Missing drill hole in Gerber files?

stapelberg, 2020-09-09:
Not entirely investigated yet, but filing for tracking.

stapelberg, 2020-09-11:
The current suspicion is that the user made a mistake when exporting the drill files, and only had the PTH (plated through-hole) drill file, not also the NPTH (non-plated through-hole) drill file.

I have asked pcbway to review the gerber files I created as per their instructions, and will keep this issue open until reviewed gerbers are available for pcbway.

Thread 16 (2020-10-13):

Debugging incorrect / malfunctioning keys (LEDs work)

landakram, 2020-10-13:
I'm setting up KinT with a Kinesis Advantage 2 and a Teensy 3.6. I soldered everything and flashed the Teensy with [this hex file](https://github.com/kinx-project/kint/blob/master/default-firmware/kinesis_kint36_default.hex).

When I plug everything in, the LEDs go on as expected, but keys are clearly malfunctioning: some keys aren't registering at all and some are registering as other keys or groups of keys (I'm using [qmk configurator](https://config.qmk.fm/#/test/) to test keypresses).

Any ideas on how to best to debug? I didn't do the best job soldering, but I'm not sure how to determine whether it's something there or software issue.

stapelberg, 2020-10-13:
Hey, thanks for reaching out!

My first guess would be that some connection indeed isn’t soldered correctly.

Is there any rhyme or reason as to which keys in particular work / do not work?

That would help narrow it down.

landakram, 2020-10-13:
OK, after getting `hid_listen` to compile on OSX and recompiling qmk with logging, it appears that column 3 (Shift, Z, X, C, V, B, etc. on qwerty) is the problem — every other column / row combination produces output except column 3 (3 function keys wired to TOP_RIGHT also have no output, presumably they are COL_3 as well).

I re-soldered all of the connections and then double-checked COL_3 connections, which as far as I understand the [schematic](https://github.com/kinx-project/kint/blob/master/schematic-v2020-06-30.pdf) are:

* LEFT_13_LT pin 12
* RIGHT_13_DOWN pin 7
* TOP_RIGHT pin 8
* Teensy pin 20

But even after re-soldering these connections, COL_3 still doesn't produce any output 😭

I'm new to reading schematics; the FPC connector pins are staggered in 2 columns on the board but in the schematic they are vertical with 1 column. I want to make sure I'm looking at the right pins. Should I be reading them from the "1" on the silk screen such that pin 1 might be on the left column and then pin 2 might be up and to the right (and pin 3 up and to the left)? Or do I go up one column first?

Either way, I re-soldered the connections that result from both interpretations. But COL_3 still doesn't register... I am yet again at a loss and really appreciate any insights you might have!

stapelberg, 2020-10-15:
> I'm new to reading schematics; the FPC connector pins are staggered in 2 columns on the board but in the schematic they are vertical with 1 column. I want to make sure I'm looking at the right pins. Should I be reading them from the "1" on the silk screen such that pin 1 might be on the left column and then pin 2 might be up and to the right (and pin 3 up and to the left)? Or do I go up one column first?

Here’s how to get a better understanding of the connections:

1. Install kicad (free and open source)
2. Clone https://github.com/kinx-project/kint/ and open kicad/kint.pro in kicad
3. Select Tools → Edit PCB
4. Select View → Flip Board View, because the front side of kinT contains the LEDs, the back side contains the connectors.
4. Select Highlight Net, the second icon from the top in the right icon bar
5. Click on the pin of interest. In the bottom left, you’ll see the Net Name (e.g. `COL_3`), and kicad will highlight all connected traces.

For your specific case, this is the expected result:
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

Do you have a multimeter? You can use its connectivity test (beeps when there is a connection between both probe heads).

Do you have any left-over PCBs? Where did you make the PCBs?

Could you send photos of the soldering points for all the `COL_3` connections as seen in the picture above?

The most common mistake really is a soldering mistake. Sometimes, residue can lead to unwanted connection. You could use a PCB cleaner if you haven’t already.

Sanic, 2020-12-20:
Hi @landakram
Did you solve your problem in the meantime?
Can you please share what changes you had to made to hid_listen and how you debugged your problem further?
Since a lot of my keys also don't work on my board (even though they seem to be connected when checking with a multimeter) i have to dive into the debug options in QMK...

stapelberg, 2020-12-20:
I don’t think you need any changes to hid-listen, you just need to start it and wait for debug messages to come in.

Which keys specifically don’t work for you? Compiling a list would be a good first step to narrow it down to specific rows or columns in the matrix, or to confirm that all rows/columns work fine per se and individual keys should be checked.

landakram, 2020-12-20:
@Sanic, unfortunately I narrowed down my problem to a defective teensy pin (as far as I could tell) and then didn't go further.

I used the multimeter to test continuinity between every joint connecting `COL_3` and the teensy pin. Every point was connected to the teensy pin.

I then used the multimeter to test voltage from the gpio pins. I found that every column pin had some non-zero voltage except for the affected pin, 23, which had a flat 0 volts. I concluded that pin 23 was defective, given that, from my understanding of the firmware, every column should be reading high when no keys are pressed. I neglected to test the pins before soldering everything, so perhaps the teensy was defective from the get-go or I fried it during my soldering troubles.

> Can you please share what changes you had to made to hid_listen

I made some small changes to get it to compile for macOS-x86_64 using clang. The binary on the website is only compiled for powerpc. Please see the `hid_listen.mac` binary here, which should work for you on macOS: https://github.com/landakram/hid_listen/releases/tag/v1.0.0

@stapelberg, thank you for all your help. It was really helpful for a newbie like me. I hope to pick this project back up soon when I order another teensy 😄

Sanic, 2020-12-20:
> I don’t think you need any changes to hid-listen, you just need to start it and wait for debug messages to come in.
>
> Which keys specifically don’t work for you? Compiling a list would be a good first step to narrow it down to specific rows or columns in the matrix, or to confirm that all rows/columns work fine per se and individual keys should be checked.

I did quick collection of the keys that don't work with the QMK Configurator:https://config.qmk.fm/#/test/
The result is in the following image. Everything that is marked with a red line is not working:
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

While testing the keys, i also found a weird behavior:
Pressing ',' or '.' doesn't work works when you hit them alone.
However, if you hold ',' or '.' and THEN hit 'm', it also registered the ',' or '.'
Any ideas on how to debug this further is highly appreciated 😃
I've built two redox keyboards before but haven't encountered such a behavior.

Sanic, 2020-12-23:
As a follow up: I just tested the keyboard on a windows machine.
On that machine, it works flawlessly.

So i wonder what might cause these weird issues when using a Macbook.
I tried going through the Keyboard identification process and set the keyboard layout to ANSI and ISO, but that didn't change anything.
My redox keyboard also works without any problems on MacOS, so i wonder what might be different on the (ARM-based) firmware/hardware combination that could explain these problems.

stapelberg, 2020-12-23:
This is really strange, but a good find!

I don’t have much time to look at this problem in detail right now, but here’s one thing to try: connect the keyboard via a USB hub. That way, subtle differences between USB implementations across devices/operating systems might be less of a problem.

Sanic, 2020-12-25:
@stapelberg I also tried out to connect the keyboard via a Hub, but unfortunately that didn't change anything.

Today, i found the time to solder another board for the same keyboard, but with a teensy 2.0.
This board works perfectly on the same Mac.
So this issue might indeed be related to Teensy3.6 <-> MacOS.
I'll open another issue for that.

Thanks for your hints @stapelberg @landakram

stapelberg, 2021-06-30:
I’ll close this issue as it seems there’s nothing else we need to diagnose/can do here. Please reopen if that’s incorrect.

jsravn, 2021-09-20:
@landakram not sure you got back to this, but I went through the same fun exercise. The information here was helpful. In my case pin 14/15 were shorted, and pin 14 was shorted to GND.  I'm unsure how this happened - there were no solder bridges at all, so I suspect my PCB was defective (next time, I'll check my PCB first).

I highly doubt the teensy pin itself is busted. I didn't want to junk my board and parts, so I hacked around it, maybe you can do something similar:

1. I pulled out the header pins from 14/15. Used solder wick to get as much as possible, then pliers to wiggle/pull them out.
2. After this, I verified there was no continuity between 14/15 and gnd directly on the teensy board.
3. I used a small knife to scratch out traces for pin 14 / 15 on the back.
4. Wired 14 and 15 each directly to the first FPC pin (see kicad for where they should connect - you can also see by following the traces) with some wire wrap wire.

Fortunately that was enough to get my board fully working. Hopefully you can get it working w/o ordering all new parts!

Closed 2021-06-30.

Thread 17 (2020-10-30):

toggle led's

geekhunger, 2020-10-30:
Hey Michael,
first of all let me thank you for this project. It's amazing! I ordered all parts and the boards and have already build one. What a pleasurable and fun experience - it just works!

However I'd like to set my LEDs manually to create a Knight Rider effect (light scrolls left to right).
Ideally I'd like to have a function that I can all anywhere to turn on (or off) the light of a certain led.
I've found your initialization code inside kint36.c and played around with it, but I just can't turn on manually any of the led lights. Could you guide me a little into the right direction?

stapelberg, 2020-10-31:
> first of all let me thank you for this project. It's amazing! I ordered all parts and the boards and have already build one. What a pleasurable and fun experience - it just works!

Glad to hear everything works well for you!

> However I'd like to set my LEDs manually to create a Knight Rider effect (light scrolls left to right).
> Ideally I'd like to have a function that I can all anywhere to turn on (or off) the light of a certain led.
> I've found your initialization code inside kint36.c and played around with it, but I just can't turn on manually any of the led lights. Could you guide me a little into the right direction?

My guess would be that the LEDs are overridden after you change them. Try commenting out the code which sets the LEDs based on the keyboard state: https://github.com/kinx-project/qmk_firmware/blob/kint36/keyboards/kinesis/kint36/kint36.c#L54-L91

But: maybe instead of implementing your own animation on just 4 LEDs, why not go one step further and control an LED strip?

QMK has support for that built-in: https://beta.docs.qmk.fm/using-qmk/hardware-features/lighting/feature_rgblight, and there already is a knight rider mode animation: https://github.com/qmk/qmk_firmware/issues/1672

We have at least one person who got that feature to work on the kinT controller: https://github.com/kinx-project/kint/issues/10#issuecomment-679465162

afonsoguerra, 2021-06-11:
Can I ask for an update on the status of this?

At the moment I am still waiting for my boards to arrive, but I'm planning the code. I would instead like to use the LEDs as a layer indicator, so I could have up to 16 layers indicated using the 4 LEDs. The code referenced on kint36.c seems to have gone. So far I'm trying to make the keyboard look 'normal' so I ain't keen on the RGB mod, but looks easy enough.

stapelberg, 2021-06-11:
What update are you waiting for? AFAIK, the kinT controller LEDs work fine, and you can use the various QMK features that work with LEDs.

I updated the link in the comment above to point to https://github.com/qmk/qmk_firmware/blob/2e90ef05363893f3aa49c99af408e774609aa97a/keyboards/kinesis/kint36/config.h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, where QMK configures which pins to use for the status LEDs.

afonsoguerra, 2021-06-11:
ah, awesome. I was just thrown off by the link above. no updates needed, seems this will work out of the box.

stapelberg, 2021-06-30:
Looks like this is resolved, closing the issue.

Closed 2021-06-30.

Thread 18 (2020-12-25):

[Teensy3.6] Some keys are not recognized on MacOS

Sanic, 2020-12-25:
See also https://github.com/kinx-project/kint/issues/16#issuecomment-748665978

It seems that the Teensy 3.6 version of this controller might behave weirdly on MacOS:
  - Some keys are not detected properly (For example the thumb keys for delete, enter, etc.)
  - Keys are only activated if another key close to it is pressed (same column?)

Is there somebody who uses the teensy 3.6 variant of this controller with a mac successfully?

stapelberg, 2020-12-29:
I just tested my Teensy 3.6 Kinesis on a MacBook Air M1 running macOS Big Sur 11.0.1, and all keys seem to work perfectly fine.

You mentioned that you did a separate build with a teensy++ that worked. I assume you have been using both controllers in the same keyboard, so we can likely exclude keyboard issues.

Can you double-check all soldering joints on the affected board? Applying some extra flux in liquid form, if you have it, or just a little fresh solder and re-heating each solder joint will usually help.

stapelberg, 2021-06-30:
I’ll close this as there were no other reports of this issue, and I couldn’t reproduce it.

Closed 2021-06-30.

Thread 19 (2020-12-31):

USB hub possible?

impaktor, 2020-12-31:
## Intro
Thanks for your amazing work on this project!

My background: I'm using a kinesis Advantage 2 (KB600-SE), and I have previously built a [Dactyl-ManuForm](https://github.com/tshort/dactyl-keyboard) with arduino + QMK, but beyond that I don't have any electrical engineering experience and thus zero kicad/pcb work, thus my following questions below.

## 1. USB hub?
The only function I miss in my Kinesis 2, is a USB-hub (ports both for internal and external use), so I'd be very interested in how/if there is any possibility to add that to the kinT?

I know you [experimented](https://michael.stapelberg.ch/posts/2018-04-17-kinx-usb-hub/) with this a few years ago, for the older board (kinx) you were working on then. I think you came to the conclusion that the sum of connected USB-devices must be below 500 mA. Would that still be a limiting factor if it were to be re-implemented on this board? Is there space on the board for it?

## 2. Speaker?

The factory board comes with a piezo buzzer, to give audio feedback, possibly to make up for the switches not being clicky, I guess. I find I actually use it now that we're all working from home (thus not disturbing my colleagues), I also used it when learning to touch type when I was new to the kinesis. Are there any free pins on the teensy for adding this, and could the traces be added for this on the board?

## 3. Github discussion?

I saw github recently launched a [discussion page](https://docs.github.com/en/free-pro-team@latest/discussions), which can be enabled, if you prefer to keep issue tracker devoted to only bugs/issues, and discussions/forum type posts elsewhere

## Conclusion

I'm half itching to make this board (for QMK and green LEDs > blue LEDs!), but I want to hear your thoughts on my questions above, if you have time to answer them.

Cheers!

stapelberg, 2020-12-31:
> Would that still be a limiting factor if it were to be re-implemented on this board?

Yes: the limit is how much power computers are willing to deliver via USB, so unless you add a separate, external power supply (like an active USB hub does), 500mA is all we got.

> Is there space on the board for it?

Yes in theory, but no in practice: keeping the USB hub on a separate board is the better choice. That way, you can reason more easily about interference, which becomes an issue with USB 2.0 (minimum one would expect in a hub these days), and even more so with USB 3.

My recommendation is to just build the existing kinX USB hub board, which is known to work. Designing your own will be very time-intensive. The KB600 requires modifications to the case to expose the ports, so that’ll be enough work :)

> Are there any free pins on the teensy for adding this, and could the traces be added for this on the board?

This depends on the teensy model you’re using: all teensys that have enough pins for the LEDs (Teensy++, Teensy 3.5, Teensy 3.6, Teensy 4.1) have enough pins for additional peripherals. Check out the schematic for more details: https://github.com/kinx-project/kint/blob/master/schematic-v2020-06-30.pdf

As for adding the trace/peripheral itself, I think that would best be done in a separate modification for now. It’s not clear to me which peripherals are the most popular/useful, and every change to the board requires careful testing etc., so I’d like to keep the board as minimal as it is for now. The design of the project should make it easy for you to add your desired peripherals, be it speakers or LED strips, or… :)

> I saw github recently launched a [discussion page](https://docs.github.com/en/free-pro-team@latest/discussions), which can be enabled, if you prefer to keep issue tracker devoted to only bugs/issues, and discussions/forum type posts elsewhere

I haven’t used GitHub discussions yet. Have you used them and found the experience good? We can experiment with turning them on, I suppose.

impaktor, 2021-01-01:
Thanks for swift answer, that straightened out some question marks I had.

> I haven’t used GitHub discussions yet. Have you used them and found the experience good?

I have not used them either, as in other projects I'm involved in we already have forums going hosted elsewhere. Perhaps my suggestion was a justification to myself for opening an issue that is not a bug report, something I'm in general against doing.

Closed 2021-01-07.

Thread 22 (2021-01-09):

Teensy++ 2.0 positioning on  kinT question + JP1 + JP2 + JP3 bridge question

dky, 2021-01-09:
Hello @stapelberg,

Thank you publishing this, this actually is such an improvement because the board is actually positioned properly. I've been using a variant of your board and it needs to get soldered in backwards which is so weird (Also wondering if this is why my boards have been dying so frequently. I've lost about 3 of them - they just randomly stop working).

Question: I have an older teensy++ 2.0 and wanted to clarify with you the positioning before I started soldering:

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

I wanted to know if this was where the teensy++ should sit. I'll also follow your directions below once done.

```
Soldering instructions for the Teensy++ 2.0
Follow the instructions for the Teensy 3.x or 4.x above, but:

Do not connect pin 7, pin 15 and pin 16. These are marked with an x on the kinT.

An easy way to do this is to remove the corresponding pins from your pin header with pliers.
Close the solder jumpers JP1, JP2, JP3. These will remap pin 7, pin 15 and pin 16 onto pins that can be used with the Teensy++ 2.0.
```

Afterwards once this is confirmed.

Thank you!

dky, 2021-01-09:
Another question is when you say "Close the solder jumpers JP1, JP2, JP3" does that mean create a bridge between the following on the back of the unit?

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

I'm planning to put a two wires to bridge JP1 + JP2 + JP3 will that work?

dky, 2021-01-09:
Here's a visual diagram of what I plan to do for the bridge:

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

Please let me know if this will work!

stapelberg, 2021-01-09:
> (Also wondering if this is why my boards have been dying so frequently. I've lost about 3 of them - they just randomly stop working).

One theory might be ESD (electro-static discharge). A friend of mine told me that directly accessible switches (like key switches) should ideally be ESD-protected, but I haven’t seen this much on other keyboard projects.

> I wanted to know if this was where the teensy++ should sit.

Yep, that looks correctly positioned to me.

> Another question is when you say "Close the solder jumpers JP1, JP2, JP3" does that mean create a bridge between the following on the back of the unit?

No: these are 3 separate solder jumpers. To close each one, just apply solder within each of the white squares, creating a connection between the two golden pads within the square.

Here’s an example (apologies for the dusty PCB):

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

dky, 2021-01-09:
@stapelberg Thanks for the quick response! I got it. I'll poke at this shortly. Thank you for clarifying what that bridge meant I was a bit confused since I'm still pretty much a novice with hardware.

dky, 2021-01-09:
I'll also keep in mind the ESD thing. I was thinking it was the quality of the Teensy controllers but will be mindful of ESD as well.

Closed 2021-01-09.

Thread 24 (2021-02-03):

layer_state_set_user not being called?

deBaer, 2021-02-03:
Hi, I want to emulate the original firmware's keypad behaviour and light the keypad LED when the NUMPAD layer is active.

Sadly, the code below in keymap.c doesn't work:

```
layer_state_t layer_state_set_user(layer_state_t state) {
  printf("layer_state_set_user running\n");
  switch (get_highest_layer(state)) {
    case NUMPAD:
      writePin(C3, 0);
      break;
    default:
      writePin(C3, 1);
      break;
  }
  return state;
}
```

The LED doesn't change on layer change, nor is there output in the console.

I even tried putting this into kint2pp.c, as it seems to be missing, but it also changes nothing:

```
layer_state_t layer_state_set_kb(layer_state_t state) {
    layer_state_set_user(state);
    return state;
}
```

Any idea what might be wrong here?

deBaer, 2021-02-04:
Oh, right, I also deactivated the LED being overwritten:

```
bool led_update_user(led_t led_state) {
  writePin(C4, !led_state.scroll_lock);
  writePin(C5, !led_state.num_lock);
  writePin(C1, !led_state.caps_lock);
  return false;
}
```

stapelberg, 2021-02-05:
This might be better answered in the QMK repository.

I agree that it seems like something is missing, but I don’t have the time right now to dig through how this is supposed to work in QMK.

davmarksman, 2021-03-25:
Hey, struggled on it too but got it working.

This is what I did to get the leds working based on which layer I was on:

```c

layer_state_t layer_state_set_user(layer_state_t state) {
    // interestingly had to set the one I wanted on to 0 and the rest to 1 (for off)
    switch (get_highest_layer(state)) {
      case SYM:
          // For symbol layer set compose led on
          writePin(LED_COMPOSE_PIN, 0);
          writePin(LED_NUM_LOCK_PIN, 1);
          writePin(LED_SCROLL_LOCK_PIN, 1);
          break;
      case L1:
          // For Layer 1 set numlock led on
          writePin(LED_COMPOSE_PIN, 1);
          writePin(LED_NUM_LOCK_PIN, 0);
          writePin(LED_SCROLL_LOCK_PIN, 1);
          break;
      case NAV:
          // For Layer Nav set scroll lock led on
          writePin(LED_COMPOSE_PIN, 1);
          writePin(LED_NUM_LOCK_PIN, 1);
          writePin(LED_SCROLL_LOCK_PIN, 0);
          break;
      default:
          // set off
          writePin(LED_COMPOSE_PIN, 1);
          writePin(LED_SCROLL_LOCK_PIN, 1);
          writePin(LED_NUM_LOCK_PIN, 1);
    }
  return state;
}

bool led_update_user(led_t led_state) {
    // you need to implement this method and return false otherwise it will overwrite what happened in layer_state_set_user

    // we want caps lock to keep working as is:
    writePin(LED_CAPS_LOCK_PIN, !led_state.caps_lock);

    return false;
}

```

stapelberg, 2021-04-01:
https://github.com/qmk/qmk_firmware/blob/ac0ba832c73dd2130f66ba1f3781ccb16c150a89/tmk_core/common/action_layer.c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 is the dispatch logic using weak symbols:

* if `layer_state_set_kb` is not overriden, it calls `layer_state_set_user`.

LEDs seem to be updated after processing all actions in the keyboard task: https://github.com/qmk/qmk_firmware/blob/ac0ba832c73dd2130f66ba1f3781ccb16c150a89/tmk_core/common/keyboard.c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

So it should be possible to introduce a state variable that you modify from your `layer_state_set_user` and then handle LEDs accordingly in your `led_update_user`. This seems a little cleaner to me than modifying LEDs from multiple places :)

davmarksman, 2021-04-01:
Thanks for the feedback. Tried that and it worked better.

But then I stumbled on `layer_state_is` in the doc's over here:
https://beta.docs.qmk.fm/using-qmk/software-features/feature_layers#functions-id-functions

This is the final solution I came up with. You only need to handle `led_update_user`

```
bool led_update_user(led_t led_state) {
    // Can use layer number instead e.g layer_state_is(0)
    writePin(LED_COMPOSE_PIN, !layer_state_is(GAME)); // set compose led when on game layer
    writePin(LED_SCROLL_LOCK_PIN, !layer_state_is(NAV)); // set scroll lock led when on nav layer
    writePin(LED_NUM_LOCK_PIN, !layer_state_is(L1));    //...

    // we want caps lock to keep working as is:
    writePin(LED_CAPS_LOCK_PIN, !led_state.caps_lock);

    return false;
}
```

Great work on the controller btw. Loving using it 👍

davmarksman, 2021-04-01:
Thanks for the feedback.

Tried that and it doesn't work for one shot modifiers  (I don't think it gets called in that situation).

Also tried `layer_state_is` from the doc's over here but same issue. Docs: https://beta.docs.qmk.fm/using-qmk/software-features/feature_layers#functions-id-functions

```c
// works with TO(kc) and LT(layer,kc) but not OSL(kc)
bool led_update_user(led_t led_state) {
    writePin(LED_COMPOSE_PIN, !layer_state_is(GAME)); // set compose led when on game layer
    writePin(LED_SCROLL_LOCK_PIN, !layer_state_is(NAV)); // set scroll lock led when on nav layer
    writePin(LED_NUM_LOCK_PIN, !layer_state_is(L1));

    // we want caps lock to keep working as is:
    writePin(LED_CAPS_LOCK_PIN, !led_state.caps_lock);

    return false;
}
```

Great work on the controller btw. Loving using it 👍

Thread 25 (2021-03-13):

LED issue with Teensy 4.1

gottwald, 2021-03-13:
I've built the board with a Teensy 4.1 and used the firmware form your qmk_firmware fork (https://github.com/kinx-project/qmk_firmware) and kint41 branch (e2f82ab2dac).
I've used the exact components from the guide.

Mostly stuff seems to work but none of the LEDs do.

I've done some measurements and I'm a bit confused by the results:
- I've got 3.3V on the `3V3_2` pin of the cross row. I also didn't forget to solder it.
- I've got 3.3V on all anodes
- I checked that I have no shorts between the LED Pins `12`, `24`, `25`, `26`
- All measurements were done with several ground pins (`GND`, `GND mounting pad`, `GND 3`)
- Can't make the LEDs light up with my multimeter (weirdly shows `.0L` in forward and reverse bias. I use a Brymen BM257s which IIRC has a 1V range for diode testing which might be the reason). But I can make them all light up with some help from a 3V battery
- Checked the resistors, all measure 10k.

Here's where it becomes strange:
- As said above I can always measure 3.3V on the anode
- But I also can always measure 0.9V on the cathode. Regardless of CAPS_LOCK being on or off for example.
- I can also measure the 0.9V before and after the resistor.
- I also got the 0.9V on the LED Pins `12`, `24`, `25`, `26`.
- During those measurements the LED lights up a tiny bit (barely visible)

The rest of the keyboard seems to work fine as I'm typing this issue on it.
The only thing that doesn't work is waking up my mac from sleep with this keyboard, but I'm guessing this is more of a firmware thing.

Any idea what could be wrong?

stapelberg, 2021-03-15:
Give https://github.com/kinx-project/qmk_firmware/commit/c61d90b80415343d86b9c0c1b659823aaaee47c9 a try — I think the LEDs just weren’t wired up before.

But, the GPIO functionality is working now, so I think the wiring should be okay. In a quick test, this made the Caps Lock LED work for me on my Teensy 4.1 board.

gottwald, 2021-03-15:
Thank you! Works like a charm.
I was only able to verify CAPS_LOCK due to my layout but re-measured the pins and now the measurements on all LED pins make sense so I'm pretty sure the others are also OK.

Closed 2021-03-15.

Thread 27 (2021-04-01):

enhancement: make design classify as simple at aisler?

stapelberg, 2021-04-01:
Aisler recently introduced a new, cheaper tier: https://aisler.net/blog/introducing-budget-manufacturing-the-most-economic-choice-on-the-planet

Our current artifacts (v2020-06-30) show up on the aisler web interface as “complex”, which makes it not qualify for this new, cheap tier:

Dimension / Size | 107.95mm x 86mm
-- | --
Design Rule Rating | Complex
Surface finish | ENIG
Layer Count | 2
Minimal drill diameter | 0.4mm
Elongated holes count | 0

See https://aisler.net/help/design-rules-and-specifications/design-rules for aisler’s design rules.

AFAICT, we fulfill 2 of 4 criterions: our minimal drill diameter is 0.4mm, and we have 2 layers.

Is the problem plated slots? The milling tool size? Something else entirely?

If we can, it would be nice to make our design qualify as a simple design.

stapelberg, 2021-04-13:
The problem seem to be the cut-outs:
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

As soon as I remove them, Aisler classifies the design as simple instead of complex.

Now the question is whether there is an alternative way to design the cut-out that qualifies as simple.

cincodenada, 2021-04-25:
So I started to look into this, wondering if connecting the holes to the board outline would help, but then upon looking at the guidelines, I think this is what we're getting nicked for:

> smallest necessary milling tool for cutouts | 2.4 mm

The cutouts are, frustratingly, 2.1mm and change wide in the short dimension. I widened those slots just a tad so they were over 2.4mm, and AISLER did indeed judge it to be Simple:

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

I thought I'd have to make them drill slots, but apparently they're happy with the squares as long as they're at least 2.4mm wide. Obviously this makes it more able to jostle around, but that seems acceptable, although it's a bummer to have weird cutouts just for Aisler.

To that end, I made even weirder cutouts that pass as Simple, that are little zigzags so that the width is always 2.4mm, but half of each side of the slot will still be even with the posts. That's in the latest revision on my Aisler test project: https://aisler.net/p/ZLFAZHWW

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

I have no clue what those slots will come out like in actual production, but they at least pass whatever check they have, and I imagine if anything they'll end up being wider than designed, which is probably fine?

stapelberg, 2021-04-25:
Thanks for figuring this out!

> I have no clue what those slots will come out like in actual production, but they at least pass whatever check they have, and I imagine if anything they'll end up being wider than designed, which is probably fine?

Yes, that’s fine.

> To that end, I made even weirder cutouts that pass as Simple, that are little zigzags so that the width is always 2.4mm, but half of each side of the slot will still be even with the posts. That's in the latest revision on my Aisler test project: https://aisler.net/p/ZLFAZHWW

Cool! I like that idea :)

As mentioned in your pull request #30, if you could split out this fix into a separate pull request, that’d be great. I will order a test run at Aisler today if you can send the changes :)

stapelberg, 2021-04-25:
> but they at least pass whatever check they have

By the way, my current theory is that they cut the board outline with a 2.4mm drill bit, so unless the slots are at least 2.4mm high, they need to switch to a different drill (or perhaps even different machine).

cincodenada, 2021-04-25:
Yeah, that's my assumption as well, which is why I'm curious about what it will look like - if they're cutting with a 2.4mm drill bit, the corners of the zigzag might not be very rectangular!

stapelberg, 2021-04-25:
> if they're cutting with a 2.4mm drill bit, the corners of the zigzag might not be very rectangular!

Looking at their previews, I’m convinced they cut with a drill, and the corners will not come out rectangular. In fact, looking at the boards I ordered from OSH Park, they also clearly use a drill and non-rectangular holes are the result. Doesn’t seem to be a problem for fitting the board in the Kinesis :)

I have tagged revision v2021-04-25 and uploaded it to aisler: https://aisler.net/p/NLNHRLZN

I also ordered 3 PCBs, let’s see how they come out :)

stapelberg, 2021-04-29:
> I have tagged revision v2021-04-25 and uploaded it to aisler: https://aisler.net/p/NLNHRLZN
>
> I also ordered 3 PCBs, let’s see how they come out :)

Just received the boards this morning, and I am happy to report that the cut-out fits perfectly fine! :)

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

Closed 2021-04-25.

Thread 28 (2021-04-19):

status prints dvorak even when qwerty and initial keymap doesn't persist after unplug

cartazio, 2021-04-19:
i'm using

```
commit 0a9e18fae13654ab6d8d85a9867fc10a4261103f (HEAD, origin-primary/develop)
Merge: 924b9fcf0 eb7e668eb
Author: QMK Bot <hello@qmk.fm>
Date:   Sun Apr 18 22:40:16 2021 +0000
```

and heres what status prints:
```Firmware> QMK 0.12.35-312-g0a9e18, 2021-04-18-20:15:11
Keyboard> kinesis/kint36
Keymap> kzar
Layout> DVORAK
Thumb keys mode> MAC
NKRO> Enabled
Debug> Disabled
```

some questions:
1) why cant i persist the mapping /layer state?  2) failing that, how do i patch the code from that commit to start with the mac layer being the intitial one?

thankx :)

stapelberg, 2021-04-19:
The settings not being persisted likely is a duplicate of https://github.com/kinx-project/kint/issues/8

I’m not sure about the wrong status, though, that might be a QMK issue.

Perhaps someone else reading this issue has any ideas?

cartazio, 2021-04-19:
So a simple fix for me would be just to change the layers order somehow so mac comes first. How would I change the code at that point for that?

stapelberg, 2021-04-19:
I don’t use QMK layers, I use the [NEO layout](https://neo-layout.org/) which comes with its own layers.

Your question might be better asked in the QMK project itself, not in this specific controller project :)

stapelberg, 2021-05-14:
https://beta.docs.qmk.fm/using-qmk/software-features/feature_layers seems to be the documentation from QMK regarding the layers feature.

The layers you’re using are specific to the kzar QMK keymap, so perhaps @kzar can shed some light on this?

kzar, 2021-05-14:
> The settings not being persisted likely is a duplicate of #8

Yea, I think that's right. I could never get the layers to persist at all. If you ever get it working with the Teensy 3.6 @stapelberg let me know and I'll test that the various layers in my keymap persist correctly. It's possible I'll need to make changes too.

> So a simple fix for me would be just to change the layers order somehow so mac comes first. How would I change the code at that point for that?

You would edit the file `keyboards/kinesis/kint36/keymaps/kzar/keymap.c`. The different thumb modes are set up as different layers, with the exception of the default WIN mode which is built into the default QWERTY layer. The simplest way to bodge it, would probably be to see where [the thumb keys for the QWERTY layer are set](https://github.com/qmk/qmk_firmware/blob/develop/keyboards/kinesis/kint36/keymaps/kzar/keymap.c#L197-L200), and adjust them [to match the MAC layer](https://github.com/qmk/qmk_firmware/blob/develop/keyboards/kinesis/kint36/keymaps/kzar/keymap.c#L249-L252).

> status prints dvorak even when qwerty

Huh, I just tested it and you're right. That's weird since I obviously had this working correctly previously. I will investigate and attempt to fix that when I get a chance. Thanks for letting me know!

stapelberg, 2021-06-30:
Looks like the wrong status was fixed with https://github.com/qmk/qmk_firmware/pull/12895

The persistence issue will be fixed once QMK merges the EEPROM support PR: https://github.com/qmk/qmk_firmware/pull/12947

I’ll close this issue, please follow the PR if you’re interested.

Closed 2021-06-30.

Thread 29 (2021-04-21):

Documentation clarification re: Teensy++ 2.0 @ 5V

cincodenada, 2021-04-21:
Hello! Thanks for putting this together, I'm building my first kit now. I decided it would be a good resting place for my old Teensy++ 2.0, and thus have a question about docs - is the Kinesis 5V tolerant (or perhaps 5V originally?) I just want to make sure I don't break anything by plugging in an unmodified 5V Teensy++ 2.0, because the only mention of voltage in the README was the LED voltage at 3.3V.

Thanks!

stapelberg, 2021-04-21:
Yep, the key switches and diodes in the Kinesis (the only electronics components aside from the controller board) are 5V tolerant.

I think the older KB500 controller might even have been running at 5V, but I can’t find a high-enough resolution picture to confirm which microcontroller it used…

cincodenada, 2021-04-21:
Rad, thanks! And actually, now that I think of it I'll be cracking my KB500 open soon, so I'll make sure to take some good photos and confirm :)

stapelberg, 2021-04-21:
Great! Good luck with the modification, and I’m always happy to see a picture of a successful modification :)

Thread 32 (2021-04-29):

Use Neopixel LEDs (1 pin) like the SK6812mini-E?

stapelberg, 2021-04-29:
As suggested in https://twitter.com/deBaer/status/1387823539273801729

Looks like https://octopart.com/2686-adafruit+industries-68087195?r=sp is the corresponding part.

Changing the layout would make the kint36 and kint41 builds 4.5 USD more expensive, but add LED capability to the kint40.

I wonder if a hybrid layout is possible…

stapelberg, 2021-04-29:
Clarified on twitter: it’s a different SKU: https://twitter.com/deBaer/status/1387827578753490952

But that one unfortunately is not available on Digikey/Mouser, so we’ll need to wait with this change until they are.

tamsky, 2021-07-05:
Showing as "in stock" at Digikey [1], but not on "manufacturer" site [2].

[1]: https://www.digikey.com/en/products/detail/adafruit-industries-llc/4960/14302512  (reverse mount style)
[2]: https://www.adafruit.com/product/4960

stapelberg, 2021-07-05:
With the current supply chain situation, I don’t think we can switch to neopixel LEDs.

We should keep an eye on the distributor / market situation once things are more normal (in a few years, I suppose).

(If people want to experiment until then, feel free, just trying to set expectations for the time frame until I’ll feel confident to accept such a change into the project.)

Thread 33 (2021-05-14):

Error while compiling

ecraven, 2021-05-14:
I've recently run into the following problem:
```
Error: %s: %s ('ImportError', ImportError("cannot import name 'format_ansi' from 'milc' (/usr/lib/python3.9/site-packages/milc/__init__.py)"))
Traceback (most recent call last):
  File "/usr/lib/python3.9/site-packages/qmk_cli/script_qmk.py", line 74, in main
    import qmk.cli  # noqa
  File "/home/nex/qmk_firmware/lib/python/qmk/cli/__init__.py", line 13, in <module>
    from . import doctor
  File "/home/nex/qmk_firmware/lib/python/qmk/cli/doctor.py", line 13, in <module>
    from qmk.questions import yesno
  File "/home/nex/qmk_firmware/lib/python/qmk/questions.py", line 4, in <module>
    from milc import cli, format_ansi
ImportError: cannot import name 'format_ansi' from 'milc' (/usr/lib/python3.9/site-packages/milc/__init__.py)
```
This seems to be a problem with recent versions of milc, which upstream has fixed. I've not been successful in trying to get the kint36 working by copying things into upstream QMK.

Is there any chance of either updating this fork to current upstream, or even better, getting kint36 merged into QMK proper?

Thanks for any help with this!

stapelberg, 2021-05-14:
> Is there any chance of either updating this fork to current upstream, or even better, getting kint36 merged into QMK proper?

kint36 has already been merged into QMK proper. You need to use QMK’s `develop` branch, though.

ecraven, 2021-05-15:
perfect, thank you!

Closed 2021-05-15.

Thread 34 (2021-05-16):

Fix for soldering every pin of teensy++ ?

mgsloan, 2021-05-16:
I purchased a v2020-06-30 kinT on ebay, and unfortunately it does not have the annotations specifying to see soldering instructions, or that the jumpers are for teensy++ compat.  I have already soldered every pin of a teensy 2.0++.

I'm not confident in my ability to desolder the teensy in order to remove the pins and resolder.  What will go wrong if I try to use it with these pins also soldered?  Simply not working at all?  Can I just cut the traces to these pins instead?

Thanks!

mgsloan, 2021-05-16:
Oof, I see that cutting traces would only work for pin 16..

stapelberg, 2021-05-16:
> I purchased a v2020-06-30 kinT on ebay, and unfortunately it does not have the annotations specifying to see soldering instructions, or that the jumpers are for teensy++ compat.

Why is it lacking these annotations? Might be worth filing a complaint with the seller.

> Oof, I see that cutting traces would only work for pin 16..

Why would it not work for the other pins? Cutting traces and adding jumper wires should work for all the pins, I think.

mgsloan, 2021-05-16:
Ahh, I had not thought of adding jumper wires (my earlier reference to
jumpers was about the jumper pads).  Thanks!!!  Will try that soon.

I'm not sure why the annotations aren't there, I assume it's due to the PCB
layout being nearly a year older than the repo version.  I've sent the
seller a message about it.  For reference, it's this ebay posting -
https://www.ebay.com/itm/274653421480 - very convenient to be able to order
a board with almost all of the components soldered!

On Sun, May 16, 2021 at 2:37 AM Michael Stapelberg ***@***.***>
wrote:

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

mgsloan, 2021-05-16:
Ah, I've heard back from the seller and the PCB vendor just didn't do the
silk screening on that side of the board.  The seller very helpfully
offered to fix the issue for me, but I think I will probably just implement
the hack myself, since I have some background in electronics tinkering.

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

stapelberg, 2021-05-16:
Alright! Good luck with the fix :)

mgsloan, 2022-03-08:
I finally got around to trying to get this working, since I now have need for multiple keyboards (now have an office setup again).  My desoldering skills just are not up to removing the teensy and starting again (I just tried heat gun and iron though).  So, I tried the trace cutting + jumpers approach and it worked!

Perhaps this gorey image of my hackery will help someone.

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

Note that sometimes my trace cutting scraping went a bit off track and over other traces (but just surface scratch, so they still work), so don't follow this as a direct guide for what traces to cut.  The jumpers should be clear, though.  Naturally, a multimeter is handy to ensure the trace is actually cut.  Can also check if the cutting process accidentally grounded the pins - looks like I accidentally grounded pin 16, but it doesn't seem to matter.

Closed 2021-05-16.

Thread 36 (2021-05-20):

Teensy 3.6 (kint36): implement audio support in QMK/ChibiOS

stapelberg, 2021-05-20:
QMK’s quantum/audio/driver_chibios_dac_basic.c is tied to the STM32 DAC implementation.

To make audio work on the Teensy 3.6, we’d need to update that file to work with whichever ADC/DAC hardware is available on the MK66F18, which likely also requires a ChibiOS-Contrib contribution.

I have no use for audio so I don’t plan to work on this myself. Contributions welcome!

Timost, 2021-10-05:
Hi @stapelberg .

First of all, I would like to say  a huge thank you for your work :pray: :pray: :pray:.

Thanks to you, I've been able to hack my current keyboard using a Teensy 4.0. [repo not up to date](https://gitlab.com/Timost/thinkpad-kbd-qmk)

Lately I've been trying to get QMK audio working on the Teensy 4.0 without success.
I found this issue and my guess is that it also applies to teensy 4.x, could you confirm ?

I'm not really familiar with Chibios so, sorry for Stapelbergasking you directly instead.

stapelberg, 2021-10-06:
Yeah, I think QMK’s implementation only works with the STM32, and all other micro controllers are unsupported.

Thread 37 (2021-05-26):

Support for the (upcoming) Kinesis Advantage360

stapelberg, 2021-05-26:
See e.g. https://twitter.com/kinesisergo/status/1397335511694381058?s=21

That keyboard is not yet released, but I’m filing this issue anyway so that people can contribute details or subscribe for status updates

aaronjensen, 2022-08-24:
@stapelberg are you still thinking about working on this? I'd be interested in a fully-wired 360 w/ QMK personally, but no idea how feasible that is or if you're going to be looking at ZMK now 😄

stapelberg, 2022-08-24:
I received my 360 (non-pro) recently, but haven’t had a chance to open it up yet. I’m not quite decided as to what I’ll do, or even what is possible :)

aaronjensen, 2022-08-24:
Ah, good stuff. I'd be curious to see a teardown from you some day :)

aaronjensen, 2022-08-29:
@stapelberg is it possible and have you thought at all about flashing the Pro version with QMK and figuring out a way to connect them?

stapelberg, 2022-08-29:
Kinesis says the linking between the modules is always wireless on the Pro: https://twitter.com/zekjur/status/1470864813387616258

I can’t say yet what’s possible, as I don’t have a Pro version yet — they haven’t shipped yet.

stapelberg, 2022-08-30:
Here’s a video of my first look at the Kinesis Advantage 360: https://www.youtube.com/watch?v=jHXmW87_WpY

brandondees, 2022-09-15:
got mine in tonight. let me know if there are specific questions i can help answer.

not sure what the benefit of converting this to QMK would be, but i'm not too familiar yet with ZMK or how it differs from QMK.

jfrankl, 2022-10-04:
@stapelberg what is your evaluation of the 360 Pro in terms of latency? I am considering buying a 360 Pro because QMK/ZMK firmware is needed for my layout, but wireless isn't important, and my one concern is lag.

stapelberg, 2022-10-04:
I haven’t done an end-to-end latency measurement yet, but what I can say is that it ships with 10ms USB polling interval, which you can reduce to 1ms: https://twitter.com/zekjur/status/1572327757849174023

stapelberg, 2022-10-04:
Oh, thanks for letting me know and for getting this merged! :)

aaronjensen, 2022-10-04:
Ah, I didn't get it merged, it was already upstream. And no problem.

AI-Guru, 2023-06-11:
Interesting! Just dropping by to say that I would love to see the possibility of QMK on Kinesis 360 Advantage (non-pro).

stapelberg, 2023-06-12:
Someone would need to do the reverse-engineering for it.

With the 360 hardware, you can’t just swap in a new controller — the PCB has a much more complicated form factor, and a lot more intricate components on it. The only possible solution I see is to keep the PCB as-is and flash a new firmware. But I don’t know which micro controller they used and how open it is.

We’re talking about a lot of development work, with the additional “problem” that most people who care about free firmware just buy the 360 pro instead… Personally, I have no plans to do anything about the 360 non-pro.

pepsiplease69, 2023-10-15:
I personally am looking for the possibility of using qmk on the non-pro version because of the auto-shift feature in qmk.

The stock firmware has some tap&hold functionality but it’s not recommended for the alphanumeric keys.

I’ve opened a ticket with kinesis support to ask for the auto-shift feature in the form of a firmware update. Let’s see what they say.

I’ll send updates as anything develops.

I’ve easily been able to desolder the switches and install my favorite boba u4 so, at least that was good about the design.

Thread 38 (2021-06-25):

Unexpected Open: GND3 on Teensy vertical pin header

stapelberg, 2021-06-25:
This is a cosmetic issue only, but we should fix it nevertheless, just to make the PCB check pass and not raise unnecessary doubts.

Closed 2021-06-26.

Thread 39 (2021-06-25):

Teensy 4.1 (kint41) - Two key inputs with single key press

tsharky, 2021-06-25:
Hi,

first of all thank you very much for your great work and support on the kint project.

I have two kinesis advantages 2 and have built three kint pcbs in total. Two of them with Teensy 4.1.
My advantage with the cherry mx quiet red switches works totally fine and I could develop a bone like layout (close to neo) for it.

But when I use the same firmware build on my second advantage with cherry browns, I get a weird behavior when typing mostly on my pinkies and ring fingers.

1 out of 10 I see two key inputs with a single key press. Seems to be related to the 'bump' of the tactile switches.

Is there a way to increase the debounce time? Or is there another way to fix this?
This behavior is really disturbing, but I cannot use the native kinesis controller with the bone layout.

greetings
Tim

stapelberg, 2021-06-25:
Which version of the firmware are you using?

https://github.com/kinx-project/qmk_firmware/commits/kint41-upstream-ref already contains a debounce time of 20ms, which should work well. Likely you’re on an older version?

tsharky, 2021-06-25:
I forked your kint41 branch ~2 weeks ago.
But it is set to 5 ms. I will change it to 20 and test it.
I will comment or close this issue!

stapelberg, 2021-06-25:
I take it bumping the debounce time to 20ms fixed the issue for you, yes?

tsharky, 2021-06-25:
yes, 20 ms debounce time fixed it.

Closed 2021-06-25.

Thread 40 (2021-06-25):

Teensy 3.6 - Keyboard freeze when interacting with LEDs?!

tsharky, 2021-06-25:
I use the default keymap and kinesis/kint36 keyboard of the upstream qmk firmware.

The keyboard works fine until I press caps lock, scroll lock or num lock.
The LEDs light up, but there are no more key inputs possible. The keyboard is unresponsive.

I need to deactivate all locks with a 2nd keyboard and need unplug + reconnect the keyboard, to make it work again.

If I replug with an active lock state, it will not work.

stapelberg, 2021-06-25:
Can you add which branch and git revision of the upstream qmk firmware you’re using please?

tsharky, 2021-06-25:
https://github.com/qmk/qmk_firmware/tree/224dcac08fe65cd4b4ab275cac4aea1379c3528c

Is that what you need? Its sha 224dcac08 'from' the master branch.

stapelberg, 2021-06-25:
Yep. Can you try if this issue is reproducible with the `develop` branch, too? Please let me know the precise revision of the `develop` branch you’re testing with, too.

tsharky, 2021-06-25:
How do I build from develop? oO

I checked out develop (https://github.com/qmk/qmk_firmware/tree/0ef0c03a4649a3b66c68587f1e25333d06887a82) and did

`git submodule update --init --recursive`

to update git submodules. Is that correct? Never worked with submodules before.

Branch is up to date with remote and working tree is clean.

If I try to compile
`qmk compile -kb kinesis/kint36 -km default`

compile is not an argument anymore..

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

Did a clean clone
`qmk clone -b develop`

same result.

If I checkout master again, it works as usual.

stapelberg, 2021-06-25:
> to update git submodules. Is that correct? Never worked with submodules before.

I use `make git-submodule`

> If I try to compile
> `qmk compile -kb kinesis/kint36 -km default`

Try `make kinesis/kint36:default`

tsharky, 2021-06-25:
I don't get it...

`make kinesis/kint36:default`

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

`which qmk`

> /home/tschaake/.local/bin/qmk

Mentioned install script change nothing.

Switching back to master works.

stapelberg, 2021-06-25:
Yeah, I had to manually delete qmk from my system and re-install it, too.

tsharky, 2021-06-25:
Qmk reinstall helped. Thanks.

I did some further testing and it seems to be an issue on my side.
It happens when I plug in the qmk advantage as a 2nd keyboard (no difference between kint36 and kint41).

Tested it on my laptop too. There is no keyboard freeze.

stapelberg, 2021-06-25:
> It happens when I plug in the qmk advantage as a 2nd keyboard (no difference between kint36 and kint41).

Does adjusting https://github.com/qmk/qmk_firmware/blob/master/keyboards/kinesis/kint36/config.h#L60 to 2 or 3 help by chance?

Closed 2021-06-25.

Thread 41 (2021-08-03):

Teensy 4.1: Faulty behavior with recent windows 10 update

tsharky, 2021-08-03:
Hey!

Both my kint41 and my kint36 do not work properly with the recent windows 10 update (weather thingy in the task bar).
I noticed following issues:
- keyboard detection failed from time to time
- input is delayed/laggy
- 'fast' typing results in spamming the same key endlessly. Keyboard is freezed and needs to be re-plugged.

I built them from upstream https://github.com/qmk/qmk_firmware/tree/34de7ca224d613e1ae19a45860e27c15d40254dd.

Current state is unusable in windows. I checked it on two machines. The kints worked fine until the recent windows update.
I have no issues on my linux machine.

Would be nice if you could take a look or check it on a windows machine.
Which information can I  provide to help solving this issue?

Greetings!

stapelberg, 2021-08-03:
Can you report this issue at the QMK repository please? It does not sound hardware-specific, but rather like a firmware issue.

tsharky, 2021-12-22:
I guess the problem was a cheap USB cable.
Don't understand why it worked properly on Linux but not on Windows.

Closed 2021-12-22.

Thread 42 (2021-10-07):

older Kinesis classic (KB333) compatibility?

stapelberg, 2021-10-07:
I have gotten two questions regarding compatibility with the older kinesis advantage classic (KB333), which predates the KB500 and KB600 models.

The brief answer is that the kinT is currently not compatible with the older classic version.

The long answer is:

Electrically it is compatible, mechanically it is not compatible. The biggest difference are the connectors to the left and right key wells. Newer kinesis revisions use FFC connectors (FFC = flat form factor cables), but in the older revisions, the key well PCBs are directly connected into the controller (no cable).

Unfortunately I don’t know the part number for the required connector. In the humblehacker blog article, the author says they de-soldered the original connector from the original controller. (So if the keyboard is broken and you’re feeling adventurous, that might be an option.)

If you can figure out which part number one needs, you only need to replace it in the kinT controller design. The footprint should be identical or similar.

The only bit that’s worrying me is the physical position on the controller. With the FFC connectors you have a little wiggle room, but I think when connecting the PCBs directly, everything needs to fit much more precisely. Possibly you need to move the connector to the left or right in the kinT controller design, but that might require moving traces as well…

I hope this gives an impression of the kind and amount of work required to make it work

Sunspark-007, 2021-10-07:
The connector has been located and confirmed working on a 1995 Kinesis Essential with the new controller. https://www.molex.com/molex/products/part-detail/ffc_fpc_connectors/0520441345

https://www.molex.com/pdm_docs/sd/520441345_sd.pdf

It's listed as obsolete, but there is still inventory left.

aleb, 2022-03-14:
Below are the pictures of a KB133 and some distances I measured. The board is symmetric from what I can tell.

The shape of the side-holes is different on this board (?), but hopefully it fits.

Looking at the side with four LEDs, the right-side connector has to be moved down (towards the LEDs) 4.5 mm and left (towards the center) 3.7 mm. Similarly for the left-side connector.

Would such a change work for KB500+?

I see it's easy to move the connector in the KiCad PCB editor, but the traces are not moved automatically. Any suggestions how to move them, also considering they are on both sides of the board?

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

stapelberg, 2022-03-15:
Thanks for sharing the details!

> Looking at the side with four LEDs, the right-side connector has to be moved down (towards the LEDs) 4.5 mm and left (towards the center) 3.7 mm. Similarly for the left-side connector.
>
> Would such a change work for KB500+?

While it is **possible**, I don’t think such a change would be ideal:

1. The location of the connectors has been chosen to match the original PCB’s location as close as possible. This ensures our board doesn’t do any worse in terms of putting strain on the flex cables.
2. The further down we move the connectors, the less space you will have between connectors, which makes them really inconvenient to open/close without resorting to tooling and/or damaging your board accidentally.

Given how rare the older Kinesis are, maybe we shouldn’t bother with changing the main kinT design to work for them, and instead just keep a variant around.

> I see it's easy to move the connector in the KiCad PCB editor, but the traces are not moved automatically. Any suggestions how to move them, also considering they are on both sides of the board?

If you select the traces and the connector with your mouse (drag open a rectangular selection) and then press `m` to move, kicad will move both. I think some cutting/re-connecting will be required, but ideally in the part where the traces are straight, so that it’s easy to do.

aleb, 2022-09-07:
https://aleb.ro/post/2022-06-01-refurbishing-kinesis-KB133/

stapelberg, 2022-09-08:
Thanks for sharing this!

pentuin, 2022-09-09:
I'm close to giving up. I have a KB500 but it has those rotten stinkin' PCB connectors instead of the flex cable. I installed Millmax sockets on the keywell pcbs but none of the keys in the left keywell work and only 17 keys in the right  keywell. I don't think the sockets are the problem, though.

BTW, all of the function keys and the thumb keys work fine (and there are sockets in the thumb keys too, of course. Also the same keys that don't work with the Stapleberg controller also don't work with the original controller.

I've been doing a lot of continuity testing and checking the diodes and most of the key switches work and the passthrough from the anode to the key switch works  on all but one of the keys. The continuity from the pcb connector to the keys and test connections are terrible. Almost none of them work. Frankly I'm not sure whether they're supposed to work, but the traces don't look damaged or anything.

It seems to me that except for about 5 keys the problem is entirely in the pcb connector, so I'm wondering if there is anything else I can try.

1. I could get some wrapping wire and bridge the dead pcb connector traces to a trace terminal that still works. (Pardon me, but I don't know the correct nomenclature.)
2. I could remove all of the MillMax sockets and permanently solder the switches, though as I said I doubt that's the problem.
3. I could try manually wiring the keywells, beyond just the bridging. in other words just throw away the pcb and start over.
4. Something else?

BTW, where do you get that pcb editory Aleb is using? What's that?

Here are a few pictures:

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

aleb, 2022-09-09:
You can install [KiCad](https://www.kicad.org/), `git clone https://github.com/kinx-project/kint.git` and then open `kint/kint.kicad_pro` in KiCad.

Read my blog post for how I checked the connectivity between the Teensy pins and the paths on the thin semi-rigid PCB.

I see you soldered straight pins into J7 and J2. Will it fit when closing the case?

pentuin, 2022-09-09:
> I see you soldered straight pins into J7 and J2. Will it fit when closing the case?

Yes. Same height as the pins holding the teensy. Will check out KiCad, thanks!

pentuin, 2022-09-10:
Where do you get the files for the Kint project, to open in KiCad? Note that my version is from June 2020. Do I need the specific PCB file for that version?

aleb, 2022-09-10:
You can install [KiCad](https://www.kicad.org/), `git clone https://github.com/kinx-project/kint.git` to get the project on your computer and then open the `kint/kint/kint.kicad_pro` file in KiCad.

This will get you the latest version, I think the paths on the board have not changed so you should be able to use it.

pentuin, 2022-09-11:
Thanks! Here's a pdf I just created if you want to use dye sublimation to create legends on a set of blank pbt keycaps. The primary legends are Dvorak, and the secondary QWERTY. I also used my own designs for a few of the keys, like the CNTRL and ALT keys and the Enter and Space keys, Caps Lock, and some others. (The ALT Key is the logo for the Thunderbolts Project, because it's Alternative Physics. :) The keys Kinesis uses are basically OEM profile keys, but you could use Cherry too, if you can find blanks in a light color. Most of the standard full keycap sets have enough 1.25U keys, but they're all probably row 4 so you might need to pick up individiual 1.25U keys for rows 1 thru 3 or just use some standard XDA or DSA.
[Kinesis Key Legends.pdf](https://github.com/kinx-project/kint/files/9542048/Kinesis.Key.Legends.pdf)

pentuin, 2022-09-14:
I clearly don't understand how these molex connectors are supposed to work. The connection to the traces on the pcb are made by *pressure*, but there's nothing to exert enough pressure on the pcb connectors for them to make a connection. I don't understand how this is supposed to happen, or why it worked in the past but doesn't work now. Very frustrating. The pressure on the connection that activates it is *mechanical*, but the little plastic "wedge" inside the molex are on the wrong side. But they are obviously making some connection, it's just not at all robust and very flakey. You put the pcb connector into the female receptacle in the molex and then place the probes at the contact points on the pcb and there's no connection to the molex leads until you push down on them. I've been figuring that the "shroud" or "jacket" with that flat piece that fits inside the receptacle was there to create the pressure, but if so, it doesn't work. And it doesn't work on any of the molex connectors I've tried. I got some brand new ones, and you still have to push on the pin from the outside to get a connection!

How strange! How in the world is this supposed to work?

At this point I've done so much plugging and unplugging that the PCB is pretty much wrecked, so I'm going to have to hand wire the thing... and I'm NOT going to use the "molex" connectors. It's almost as if they're designed NOT to work, or something. (I know it's called an FCC or something but I can never remember what it's called.)

aleb, 2022-09-14:
Do you have a photo of the wrecked part?

pentuin, 2022-09-15:
Aleb:
I'm not sure what is wrecked about it. Certainly some of the pin connections look distorted because of the number of times I've pulled the switches out and the difficulty of getting them back in. This is because I tried to use the Millmax sockets. At this point it was a bad idea, because it's almost more trouble than just soldering the switch pins, although it's a close call.

But the real problem is that nothing works. I've checked the continuity and done some repairs of damaged leads/traces so all of the switches and diodes check out. But nothing on the board works, so there's something going on with this flex pcb connector and I can't figure out what it is. If I press down on the place where the connector "fingers" touch the traces I can get continuity, but I can't figure out why this is. It seems like the fingers should not require that to achieve a connection. If there's some king of break or crack there, it's not visible. I've tried three different FFC/FBC connectors and none of them achieve continuity. There is clearly something exotic going on with the PCB "connector" (the 'ribbon' from the PCB), but I have no idea what it is. It doesn't seem logical that there should be discontinuity between the "fingers" and the traces when there is no visible damage whatsoever. Anyway, here's a couple of pictures of the left hand key well pcb. Don't hate me because I'm beautiful :)

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

pentuin, 2022-09-15:
I have ordered some new diodes and some single strand wrapping wire so I can just directly wire the switches. Anyway, here's a picture of a diagram I made after continuity testing of the two PCBs. I labeled the pins to conform to the way they're labeled on the KINT controller, where the top row for the left begins with '1' and the top row for the right begins with '13' for reasons that may make sense to someone. The notes in the lower left indicate where the discontinuities where, which I have repaired with patch wiring to no avail.
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

pentuin, 2022-09-18:
I was all set to hand wire my board and then stepped on and broke my soldering iron. Had to buy a new one so I'm waiting for it. I still don't understand how this PC connector works though. The whole this seems tres odd.

pentuin, 2022-09-20:
Well, I have concluded that the stress placed on the FPC strips because of the ways I had to modify the FFC molex connections broke or cracked the connection between the fingers and the traces on the PCBs. This explains why pressing on that joint re-establishes continuity as long as I continue the pressure. I don't think there is any way to come back from this, so I've given up on the keywell PCBs as unsalvageable. I plan to manually wire the the switches, and have worked out the routes for that. There are 5 diode routes and 6 key switch routes for each of the two keywells. It shouldn't be difficult to use single strand wire for the key switch connections.

aleb, 2022-09-20:
Maybe you can save the terminal paths on the FPC strips by adding some solder to each, to make them thicker.

pentuin, 2022-10-29:
I gave up on the flimsy PCB and have just hard wired. I'm getting some flakey results such as two characters getting output instead of one, but at least most of the keys get some result. I've tested continuity and because of the size of the wrapping wire I used (I think) there is one column that seems to have a dead connection. I'll post some pictures, but it's not pretty.

pentuin, 2022-10-30:
I finally have most of the keys working except for the ?/,Z key and the insert key. As far as I can tell the insert key doesn't do anything anyway, but I do occasionally need the Z key.

Also, can I still use QMK to program my keyboard with Teensy 4.1? I can't make heads or tails of the instructions, as they don't tell you what the program is actually doing, what files it's creating (for instance, where are all the default files)? Did I make a huge mistake getting the 4.1 chip? Is the configurator ever going to work with that chip?

stapelberg, 2022-10-30:
Yes, you can use QMK for the kint41 (since QMK 0.14.0, current version is 0.18). I’ve been using the kint41 (with Teensy 4.1) for years and it works fine.

Follow the tutorial at https://docs.qmk.fm/#/newbs

Once you have a working build environment, I use a command like `make kinesis/kint41:stapelberg:flash` to build and flash QMK. You might want to substitute `make kinesis/kint41:default:flash` until you define your own keyboard layout.

pentuin, 2022-10-30:
Thanks, they helps. BTW, the PRGM key seems to take the keyboard offline. Is that some kind of reset?

stapelberg, 2022-10-30:
Yes, it resets into the bootloader (for updating your firmware). See https://github.com/qmk/qmk_firmware/pull/18802/commits/57045a2ce929ea02cf4b2917ad8001816c41e41b if you want to move it out of the way.

pentuin, 2022-10-30:
Ah thanks. I thought it was something like that... so you don't have to open the keyboard to flash a new firmware. Great!

pentuin, 2022-10-31:
Still can't get the thsee key to work, and the shift keys seem to TURN ON CAPS LOCK until I turn it off. The delete key also doesn't work. The rest of the keys seem to work fine, although since I'm using the QWERTY default with the Windows Dvorak some of the side keys are jumbled up, like the [{, ]}, |\, -_, ?/, and =+. Those are understandable.

Now the shift keys work, again. Weird. SO NOW THEY DON'T. WEIRD. Using the shift keys with the character keys instead of alphabetic keys, seems to reset the shift keys back to normal. Double Weird.

I have checked the delete and thsee keys' electronics numerous times and they all seem OK so I'm thinking the problem is either with the board or the firmware. If I can figure out how to use the KiCad program to check the circuits that should advance things a bit. Anyway, it looks promising, and I'm using the Kinesis to type this, so it more or less works again.

pentuin, 2022-10-31:
Oh, one other thing. When I first plug in the board and hit the thsee key I get a string of repeating thsees until I press some other key which stops the repeat. From then ono the thsee key doesn't work.

pentuin, 2022-10-31:
OK, here are a couple of pictures from KiCad. The connection to pin 7 is for the diode row that connects to the tshee key (pronounced like the first letter is tshee-oo where they keep the animals). The connection for pin 13 is for the column connection. I don't have the experience to determine precisely what's wrong, so thought someone could give me a hint.
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

stapelberg, 2022-10-31:
You can also use `debug_config.matrix = true;` setting to easily find out which row/column a key belongs to when you press it: https://michael.stapelberg.ch/posts/2021-05-08-keyboard-input-latency-qmk-kinesis/#finding-the-pins

Your symptom sounds like a faulty soldering connection. Locate the affected row(s)/column(s) and double-check/re-do their soldering.

pentuin, 2022-10-31:
> Your symptom sounds like a faulty soldering connection. Locate the affected row(s)/column(s) and double-check/re-do their soldering.

I've done that three times now. I'm pretty sure the problem isn't with my soldering of the keyboard. Rather, it might be a short on the controller. I had to desolder the connections for the Molex connectors so will check that again. But it just seems weird that it's the "Dvorak Z" key that's the problem, which is the "?/" key in the QWERTY layout.

I also check to see that the signal was being sent to the right pin when the "Z" key is pressed, and it is. That suggests, again that the problem is on the controller board. The same is true with the Delete key. The correct signal is going to the pin.

pentuin, 2022-10-31:
OK, I finally tracked it down. The bad delete key was easy, because I was using hotswap sockets for the thumb switches, so just remelted and added a little solder. The clue to the problem with the "z" key was the fact that whenever I first plugged in the keyboard I'd get a series of z's (ZZZZZZZZZZZZZZZ). Apparently when I soldered the column the silicone insulation on the wire softened up enough that the diode lead melted through and shorted it. So I just put some shrink tubing over those sections and resoldered them, and I can now type the "z" as much as a like. The only problem left is that the keypad doesn't work. Since I never touched those it must be the molex connection on the controller that's poorly soldered and I'll check that later when I figure out which pin on the molex is the right one.

So now I'm ready to program this thing!

aleb, 2022-10-31:
The Keypad key is mapped to `KC_NO` which is to nothing: https://github.com/qmk/qmk_firmware/blob/master/keyboards/kinesis/keymaps/default/keymap.c

pentuin, 2022-11-01:
Success! It works! I even defined the numeric keypad layout and got the toggle to work. Back in business!!

Thanks a lot, guys. Took me a couple of months but it was worth it. I was never able to flash the firmware I created using the command lines or the toolbox so just used the Teensy Loader. The cherry mx blue switches are also a big improvement over the browns. I'll post a picture later of the rats nest I hard wired, later. It's pretty nasty looking, but for posterity...

stapelberg, 2022-11-01:
Glad to hear you could get it to work now! :)

masters3d, 2022-11-06:
As an alternative, if the keyboard still working fine and if you have the version that is PS/2, you may want to try a PS2 to USB with QMK. I just brought one but it will take a few weeks to get https://www.tinkerboy.xyz/product/tinkerboy-ps-2-keyboard-to-usb-with-soarers-converter/

mezzopian0, 2022-11-06:
Wow, thanks, this thread (and the kinT) might possibly save my keyboard.

I have a very old (25 years) KB133PC with AT connector that seems to be stuck in a strange mode (scrambled up). Essentially, the right key well works normally, while the left one sends key codes that do not make sense to me ("A" sends shift, most keys send numeric keypad codes, some click but do not send any code). The thumb clusters are also messed up (they send divide, decimal key, print screen, etc.) and some keys do not send any code. The NumLock LED is lit.

I cannot reprogram the keyboard because the top row of rubber keys (Esc, Fn, ... Keypad, Program) is no longer working (they do not send any key code and no click sound is played back when I press them).
All the hard plastic keys (the two key wells and thumb clusters) play click sound when I press them, so I suppose they are recognised by the controller.

I was planning to use the keyboard again. I don't need the row of FN keys, so that's not a big issue: I'd just need to remap Esc to some other key.
I had considering using a PS/2 to USB converter to fix the mapping, like tinkerBOY w/ QMK (I think I bought a converter with Soarer some years ago but never got to try it): the issue is that, since not all keys send a KeyCode (a click is played by the keyboard, but no key code sent to the PC), as far as I understand, I would not be able to use all keys.

Is there anything that can be done to "reset" the keyboard to factory settings or at least to a state where each key sends a code?
If that's not possible, I suppose I could de-solder the cables/connectors from the Kinesis board and replace it with a kinT controller. There is much valuable information in here, thanks stapelberg, aleb, and pentuin!

mezzopian0, 2022-11-06:
This is how my board looks like.
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

aleb, 2022-11-06:
Fixing the functions keys rows could be easy with a pencil (graphite) and glue. Check out https://aleb.ro/post/2022-09-14-fixing-kinesis-function-keys/

pentuin, 2022-11-11:
I'm getting a loot of letter bounces. Is there a way to adjust this in QMK?

stapelberg, 2022-11-11:
> I'm getting a loot of letter bounces. Is there a way to adjust this in QMK?

Yes, increase the `DEBOUNCE` definition in `keyboards/kinesis/kint41/config.h`. See also https://docs.qmk.fm/#/feature_debounce_type

dm17, 2024-10-24:
Curious if anyone has tested instructions for acheiving this on the ps/2 kinesis yet.

aleb, 2024-10-25:
Yes read the thread above. https://aleb.ro/post/2022-09-08-refurbishing-kinesis-KB133/

Thread 43 (2021-11-08):

Teensy 4.1 With or without headers

kieran-mace, 2021-11-08:
This is my first project. So apologies for the noob questions:

I picked up the Teeny 4.1 with headers: https://www.digikey.com/en/products/detail/sparkfun-electronics/DEV-16996/13158152

Is this going to be a problem? should I have ordered it without?

stapelberg, 2021-11-09:
You need the version without headers indeed. See the soldering instructions: https://github.com/kinx-project/kint#soldering-instructions-for-the-teensy-3x-or-4x, and/or the video: https://youtu.be/I0kwQbnhlfk?t=5880 (from 1:38:00 to 3:33:53)

Closed 2021-11-09.

Thread 45 (2021-12-11):

Firmware flashing issue with Kint36

iparnelly, 2021-12-11:
Hi Michael,

First off, thanks so much for this project - as a beginner it has been a lot of fun to experiment and mess around with.

I recently compiled some changes to my configuration using the QMK configurator, but when I attempt to flash the firmware onto my keyboard my keyboard becomes unresponsive. The orange LED on the teensy does not light up, and the 4 blue keyboard LEDs stay permanently lit. The teensy loader does not seem to indicate any issue (neither does the verbose logging).

I suspect that this is an issue with the QMK software and how it is compiling the firmware, but to be honest, I'm not sure where to begin in diagnosing this problem. It's worth mentioning that I have tested this using the web UI for QMK configurator, as well as the qmk cli tool on both Mac and Windows (same behavior across interface/platform).

For what it's worth, the pre-built tested firmware that you have linked on the readme [here](https://github.com/kinx-project/kint#installing-the-firmware) works fine, but the QMK Configurator [link](https://config.qmk.fm/#/kinesis/kint36/LAYOUT) you have listed in the same table does not work for me anymore (it did previously).

I'm happy to create an issue on the QMK repo, but I'd appreciate some insight or direction on how I can dive in to this more.

Thanks!

stapelberg, 2021-12-11:
Wild shot into the blue: the only major recent change was EEPROM-related. In your QMK build, is https://github.com/qmk/qmk_firmware/pull/12947/files included? If so, I wonder if reverting it helps.

If yes, you might need to clear the EEPROM on your Teensy.

iparnelly, 2021-12-12:
That commit was included in my QMK build. Once I reverted that commit out then I could successfully flash newly compiled firmware. I'll look into clearing the EEPROM tomorrow and testing that with the updated QMK build, thanks for the advice!

kpence, 2021-12-17:
> I have tested this using the web UI for QMK configurator, as well as the qmk cli tool on both Mac and Windows (same behavior across interface/platform).

> For what it's worth, the pre-built tested firmware that you have linked on the readme here works fine, but the QMK Configurator link you have listed in the same table does not work for me anymore (it did previously).

It's the same for me.

kpence, 2021-12-17:
Reverting that commit fixed the issue for me, thanks!

zemackdaddy, 2021-12-21:
@stapelberg I too am having this exact same issue.

I don't really know how to revert the commit as it compilation fails due to many errors and I'd rather have an official fix.

I did hold in the reset button for like 20 seconds because I read that it will reset the EPROM and that did not fix the issue.

I raised an issue here but any advice you might give would be great.

https://github.com/qmk/qmk_firmware/issues/15521

Thread 46 (2021-12-30):

Teensy 4.1 and USB

numerys, 2021-12-30:
I want to build a split keyboard which daisy-chains (eg. computer---kb_left---kb_right---mouse) and  I would like to use mainline-qmk (python3 -m pip install --user qmk).

For that I would like to use 2 x Teensy 4.1. For each side one Teensy. Is it possible to use the internal usb-port of T4.1 with kint? That would be my main-concern. I guess the compilation / installation will be ok, but what are your thoughts about the usb-port of the T4.1? Is there any chance to daisy-chain?

brandondees, 2021-12-31:
I'm also curious about this possibility (any controller, just being able to do USB-based chaining at all, as opposed to TRRS etc, or more preferably a way to act like a usb hub with one or more arbitrary devices plugged in). I don't mind doing a little programming but I'm a little out of my element here and want to avoid wasting time on unrealistic ideas.

stapelberg, 2021-12-31:
> For that I would like to use 2 x Teensy 4.1. For each side one Teensy. Is it possible to use the internal usb-port of T4.1 with kint? That would be my main-concern. I guess the compilation / installation will be ok, but what are your thoughts about the usb-port of the T4.1? Is there any chance to daisy-chain?

kint is just a hardware board, so I think your question should read “is it possible to use the second USB port on the Teensy 4.1 with QMK” (because you’ll likely use your own board).

QMK uses ChibiOS, which in turn uses [NXP‘s SDK](https://github.com/NXPmicro/mcux-sdk). While the NXP SDK supports both USB ports, ChibiOS doesn’t, and QMK doesn’t either.

Adding the required support requires decent familiarity with how USB stacks work (and how NXP’s works in particular), and even then will take weeks to months.

Hence, I don’t think it’s a good idea to use USB for connecting the two controllers.

My recommendation would be to use a different way of connecting the two controllers. What speaks against TRRS?

brandondees, 2021-12-31:
that's a helpful answer from my perspective, thanks!

the use i had in mind was to have things like a yubikey or fingerprint reader mounted on the keyboard.

stapelberg, 2021-12-31:
For that, I recommend using a USB hub.

As it happens, I have published a design that you can build: https://michael.stapelberg.ch/posts/2018-04-17-kinx-usb-hub/

brandondees, 2022-01-01:
ooh \_very\_ helpful!

\-------- Original Message --------
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

[view it on GitHub]: https://github.com/kinx-project/kint/issues/46#issuecomment-1003461522
[unsubscribe]: https://github.com/notifications/unsubscribe-auth/AABNLBEND7PWF5FQMAB5BTDUTYW7JANCNFSM5K7VA5AQ
[AABNLBF4GIBBBJTNPGSZZ7DUTYW7JA5CNFSM5K7VA5A2YY3PNVWWK3TUL52HS4DFVREXG43VMVBW63LNMVXHJKTDN5WW2ZLOORPWSZGOHPHZXEQ.gif]: https://github.com/notifications/beacon/AABNLBF4GIBBBJTNPGSZZ7DUTYW7JA5CNFSM5K7VA5A2YY3PNVWWK3TUL52HS4DFVREXG43VMVBW63LNMVXHJKTDN5WW2ZLOORPWSZGOHPHZXEQ.gif

Thread 48 (2022-02-08):

KB500, but different thumb connections

shigmas, 2022-02-08:
I have a KB500USB (I guess I have a non-USB one in storage).

The PCB's for the thumbs are connected directly to the board. Is it possible to cut them and connect to the molex connectors on the kinT board?

stapelberg, 2022-02-08:
Does https://github.com/kinx-project/kint/issues/11#issuecomment-679308539 answer your question?

shigmas, 2022-02-08:
Aha! Yes. Certainly not as pretty as the molex, but it might keep me using this 20 year old keyboard.
I should have looked through the closed issues. Thanks!

Closed 2022-02-08.

Thread 49 (2022-03-01):

Need some help debugging

fuleow, 2022-03-01:
I sourced some PCBs from JLC PCB using the zip file in this repository and built the kint today for my KB500 using the Teensy 4.1. I pretested and preflashed the Teensy before assembling the rest of the board. I soldered the LEDs first and pretested again and when I toggled capslock, numlock, scroll lock on my other keyboard the lights on the kint turned on and off so it appeared to be working.

Unfortunately after I had everything re-assembled it did not work. Pressing a key on the left keywell (e.g. Q) would cause random modifier keys to be pressed. I thought it might be an issue with the thumb cluster since I had to hand rewire those for the KB500, so I disconnected it but the issue still persisted. I tried only connecting the top row function keys and qmk tester register the key presses but also registers a bunch of LCTRL, LALT and LOS.

I visually inspected the board and didn't see any issues with soldering but probing with the multimeter I saw that pin 6 on the teensy was shorted with ground. I'm pretty sure this should not be the case, but I am not sure how this is possible. There doesn't appear to be any ground pins near any of the pin 6 connections.

Since col 6 is related to the left thumb cluster this makes me suspect it might be the issue. Do you have any suggestions or tips on how I should try to debug the issue further? Thanks.

stapelberg, 2022-03-01:
My first suggestion would be to disassemble everything again and then re-assemble it step by step: connect only one key block. Then connect the next, etc. That way, you should be able to figure out where the problem is located, and then go from there.

Do you get the connection to GND also when nothing is connected to the board?

fuleow, 2022-03-01:
Yeah I tried disconnecting everything and only connecting the right function row (F9 - Pause). The keys register, but I get random key presses after awhile. Yes, I do get connection between GND and Pin 6 with nothing connected. I tested the 4 other unpopulated boards from JLC and they don't have this issue so it doesn't appear to be a PCB problem

```
KEY-UP   - QMK: KC_PSCR Event key: PrintScreen Code: PrintScreen   KeyCode: 44 in NaNms
KEY-DOWN - QMK: KC_F12  Event key: F12         Code: F12           KeyCode: 123
KEY-UP   - QMK: KC_F12  Event key: F12         Code: F12           KeyCode: 123 in 165.000ms
KEY-DOWN - QMK: KC_F11  Event key: F11         Code: F11           KeyCode: 122
KEY-UP   - QMK: KC_F11  Event key: F11         Code: F11           KeyCode: 122 in 190.000ms
KEY-DOWN - QMK: KC_F10  Event key: F10         Code: F10           KeyCode: 121
KEY-UP   - QMK: KC_F10  Event key: F10         Code: F10           KeyCode: 121 in 183.000ms
KEY-DOWN - QMK: KC_F9   Event key: F9          Code: F9            KeyCode: 120
KEY-UP   - QMK: KC_F9   Event key: F9          Code: F9            KeyCode: 120 in 242.000ms
KEY-UP   - QMK: KC_LCTL Event key: Control     Code: ControlLeft   KeyCode: 17 in 7996.000ms
KEY-UP   - QMK: KC_RGUI Event key: OS          Code: OSRight       KeyCode: 91 in 7988.000ms
KEY-UP   - QMK: KC_BSPC Event key: Backspace   Code: Backspace     KeyCode: 8 in NaNms
KEY-UP   - QMK: KC_DEL  Event key: Delete      Code: Delete        KeyCode: 46 in 7983.000ms
KEY-UP   - QMK: KC_PGDN Event key: PageDown    Code: PageDown      KeyCode: 34 in NaNms
KEY-UP   - QMK: KC_PGUP Event key: PageUp      Code: PageUp        KeyCode: 33 in NaNms
```

fuleow, 2022-03-01:
I've taken some pictures if it helps: https://imgur.com/a/fW0qaJa

fuleow, 2022-03-02:
Decided to purchase a prebuilt instead so I’m closing this issue

fuleow, 2022-03-02:
> It’s not a PCB layout problem, but it might be that one of the PCBs you got from JLC has an issue.

Yes, sorry I did not mean to imply the gerber files on this repo were incorrect. I thought to check the others as a sanity test, thinking that if a manufacturing defect was the cause it would show up on the others since it's the same batch.

> One quick thing to try, if you have given up on this particular build anyway: cut the pin 6 trace with a scalpel close to the teensy, then connect it to the molex connector with a jumper wire. That should circumvent the PCB and any faulty traces entirely.

Great suggestion! I cut the trace near pin 6 on the teensy and pin 6 was no longer connected to GND. The COL_6 pins on J1 and J5 were still correctly connected to each other and they were still connected to GND. I also checked GND against every other pin on J1 and J5 and there was no connection.

At this point I'm inclined to think it's a PCB manufacturing issue. My prior experience with flux residue or inadvertent bridges is there's an undesirable connection with an adjacent pin. If my understanding of the kint layout is correct there shouldn't be any through holes on the keywell connectors that are directly connected to ground.

> You could try soldering one of the other ones.

This was my thought as well, but I was not able to desolder the teensy successfully. I think if I had to do it over I would opt for female headers on the board so the teensy could be salvaged in case I made a mistake. The cost of trying again would be much lower if I only needed to re-purchase the connectors.

Maybe I'll give it another go in the future if I acquire another kinesis. Perhaps a teensy 4.0 with headers and female headers on the kint board. That would reduce the number of soldering required and allow the teensy to be easily disconnected.

Assuming the capslock LED is optional I would omit that too and consequently the vertical header for the teensy.

stapelberg, 2022-03-02:
> This was my thought as well, but I was not able to desolder the teensy successfully

Oh, yeah, desoldering is essentially impossible.

I can recommend using these (or similar):

https://www.digikey.ch/short/377hm238

https://www.digikey.ch/short/5b0rpwnq

They are small enough that you can still close the keyboard, and you can swap out the teensy as you wish.

> Maybe I'll give it another go in the future if I acquire another kinesis. Perhaps a teensy 4.0 with headers and female headers on the kint board. That would reduce the number of soldering required and allow the teensy to be easily disconnected.

Using a traditional male/female pin header might result in a too bulky controller. There is not a lot of space in that part of the keyboard.

> Assuming the capslock LED is optional I would omit that too and consequently the vertical header for the teensy.

Yeah, for a minimal build you can go without LEDs.

fuleow, 2022-03-02:
Thanks for your time with the advice and help @stapelberg ! I also enjoyed reading your blog, and ordered a Logitech MX Ergo because of it.

Closed 2022-03-02.

Thread 50 (2022-04-14):

1. Built-in speaker sorely missed 2. Extra buttons

Megavvolt, 2022-04-14:
Not an issue as such! Just a couple of questions!
If they are inappropriate here please tell where else to look for answers.

1. Is there a way/are there plans to teach **kint** make "clicks" on key presses? I noticed when the sound was off I almost never bottomed out. I miss that.
2. One of my Kinesis Contoured keyboards had 5 extra buttons (I simply drilled holes and added buttons). Is it possible to pull the same trick here?

stapelberg, 2022-04-15:
> * Is there a way/are there plans to teach **kint** make "clicks" on key presses? I noticed when the sound was off I almost never bottomed out. I miss that.

The QMK firmware itself supports the “Audio Click” feature: https://docs.qmk.fm/#/feature_audio?id=audio-click

However, the required drivers for each hardware platform are not necessarily implemented, so whether you can use this feature depends on which Teensy microcontroller you use. For example, support for the Teensy 3.6 is tracked in  https://github.com/kinx-project/kint/issues/36. I think the only Teensy with which this feature currently works is the Teensy++ 2.0, but I haven’t checked if somebody might have contributed changes to QMK since I last looked, so best do your own research on this :)

It’s not a feature I use, so there are no plans from my end to implement this.

> 2\. One of my Kinesis Contoured keyboards had 5 extra buttons (I simply drilled holes and added buttons). Is it possible to pull the same trick here?

Sure, if you wire them up to the Teensy controller and fit them into the key matrix, that should work.

Megavvolt, 2022-06-13:
@aleb not sure if it's ok to spam here but here's a link to a great forum where you'll find almost everything you might want to know on adding buttons:
https://geekhack.org/index.php?topic=26579.msg2252512#msg2252512

Closed 2022-04-15.

Thread 51 (2022-04-23):

kinT (kint41) does not wake up Windows system

stapelberg, 2022-04-23:
Got a report about this issue, haven’t tried to reproduce yet.

Not sure if this is a QMK issue, or specific to the kinT.

stapelberg, 2022-04-24:
Reported this at https://github.com/qmk/qmk_firmware/issues/16934. It’s most likely not kinT specific, but an issue with QMK, ChibiOS, ChibiOS’s drivers, or the Teensy itself. Can’t really say yet.

Closed 2022-04-24.

Thread 52 (2022-04-25):

Teensy 4.1 has stopped working properly?

JamyGolden, 2022-04-25:
## Description

I put together a Teensy 4.1 kinT keyboard controller a few months ago and it has been working amazingly up until this morning. The keys don't all work correctly any more, some seem to work for a while and then just stop, sometimes random strings are outputted and sometimes space or a key is held so it outputs something like "tttttttttttt" continuously. It seems to have gotten worse over the course of the day in the sense that no key presses seem to work correctly any more.

I last flashed the firmware about 2 months ago and I don't move the keyboard around, so there hasn't been any physical knocks or anything.

## Debugging

1. I flashed the board hoping the qmk firmware somehow degraded over night, that didn't work.
2. I flashed with the standard stapelberg keymap, thinking maybe my map was somehow corrupt and qmk wasn't picking it up, that didn't work.
3. I made sure the physical connections on the board were all tight and nothing had somehow become a bit loose. Everything was fitted correctly and nothing changed when I tried to use the board again.

I'm not sure what else to try? Have you heard of an issue like this before? Do you have any suggestions?

stapelberg, 2022-04-25:
Is there any pattern to the keys that don’t work?

My wild guess would be that one the keyboard matrix column lines (`COL_*` in the schematic) has become defective (cold solder joint). My recommendation would be to re-heat all the solder joints on the PCB, possibly starting with the column ones and then checking if that fixed the issue.

I haven’t heard of such an issue before.

In the past, when a Teensy stopped working for me, it would typically stop working entirely. I.e., when turning on, the microcontroller would get hot, and never enumerate on USB. When only individual keys don’t work, my guess is a bad connection.

JamyGolden, 2022-04-25:
Yeah definitely a strange issue. The patterns tend to change a bit each time it's unplugged and re-plugged in, but it could be like all keys don't work except the windows key acts like alt, or all keys work except qwerty row.

Thanks for the suggestion, I'll make sure everything is soldered correctly and let you know how it went.

JamyGolden, 2022-05-25:
I re-soldered some connections. While I wasn't able to see any issues, it's working again :tada: :keyboard: . Hopefully permanently this time. Thanks for the suggestion.

Closed 2022-05-25.

Thread 55 (2022-06-01):

Teensy LC pins 24, 25 for controlling LEDs

aleb, 2022-06-01:
I see the Teensy-LC has pin 24 and 25 which seem unused. Can these be routed to control two more leds?

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

aleb, 2022-06-03:
I tried on a breadboard and pin 24 is usable, but I did not manage to make pin 25 working.

I see pin 24 is assigned to the "keypad" led according to the PCB:
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

But in [config.h](https://github.com/qmk/qmk_firmware/blob/83a32b257473c5dc9fbacd71a3c1470dde21ad84/keyboards/kinesis/kint41/config.h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) it's assigned to the "compose" led:
```
#define LED_PIN_ON_STATE 0
#define LED_NUM_LOCK_PIN LINE_PIN26
#define LED_CAPS_LOCK_PIN LINE_PIN12
#define LED_SCROLL_LOCK_PIN LINE_PIN25
#define LED_COMPOSE_PIN LINE_PIN24
```

I can't even make the scroll-lock led turn on on the keyboard I built with Teensy 2.0++ and I have absolutely no clue where the Num-pad key is. So given only the caps-lock LED is useful IMO, this effort would be pointless.

A new pin 24 could be easily added and routed to its doppleganger for a quick win, I guess, if anybody needs this "compose" led, whatever it might be. Pin 25 might require some debugging. I'll make a QMK PR to add support for Teensy LC once I integrate it in a KB500 and check it works.

aleb, 2022-06-03:
See https://github.com/qmk/qmk_firmware/pull/17301 for Teensy LC support. At the moment I only tested that the Caps-lock and Scroll-lock LEDs are updated. To be tested once I integrate it into a KB500.

stapelberg, 2022-06-04:
Thanks for taking a look at this and sending the QMK pull request!

I found some documentation about the different LEDs at https://github.com/qmk/qmk_firmware/blob/master/docs/feature_led_indicators.md

It seems like the compose LED is entirely unused within QMK by default. I only wired it up so that users have the option of using the LED for their own custom purpose, if they need it :)

sigprof, 2022-06-04:
The compose LED support in QMK works… if you actually find a way to control it from the host side. I'm not sure whether it is possible to control it from Windows at all (there might be a way to do something with the Kana LED though, but nothing that looks like Compose). And recent Linux distros use the `libinput` driver for HID keyboards, which does not have support for any indicators outside the standard Caps/Num/Scroll Lock set. The `evdev` driver can control the Compose and Kana indicators, but there is a mismatch in the indicator numbering between the driver and the corresponding description in the `xkeyboard-config` package; I'm not sure whether there is any point to open a bug report for that though, because the `evdev` driver is deprecated in favor of `libinput`.

aleb, 2022-06-08:
The Teensy (LC) LED light is quite visible when the room is dark, as the orange light reflects on keys `5` and `T`. Is this also an issue for Teensy 3.6 or 4.1? I see we do make an effort in [`kint41.c`](https://github.com/qmk/qmk_firmware/blob/816accd/keyboards/kinesis/kint41/kint41.c#L24) etc to turn it on.

stapelberg, 2022-06-08:
It’s not as pronounced in my teensy 4.1 build:

https://user-images.githubusercontent.com/55506/172718612-94445b54-6213-46b7-8d80-29be3550e178.MOV

Thread 56 (2022-07-07):

malfunctioning "b" COL_3

mbenecke, 2022-07-07:
Hi,

thanks for your work, i would love the Idea to have qmk running on my Kinesis ADV 500.

I was following your guides for set up the Teensy 4.1 as straight as possible.
Now I see me in a similar situation as [landakram in issue 16](https://github.com/kinx-project/kint/issues/16#issuecomment-708060221)
COL_3 troubles me, it is so hard that the Teensy is sometimes reset and I have to flash it again. It prints out 1000nds of characters.

I was thinking, "ok, lets check the connections", I used an USB Power Brick, so no OS driver in charge and hooked up my Ozi

I check "20" and G,
- it shows no difference if any key is connected or not, a straight line for 3V. Which is OK for me.
- it doesnt care if i press the upper 2 character lines, great.
- If a press keys in the bottom row (z-v;n-?) it shows this behavior:  A sign of the matrix scan I assume?
   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
- Buf if I press "b" it locks like this, which looks not ok:
  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

Any advice how to proceed? Any other measurements you suggest?

stapelberg, 2022-07-07:
Hey 👋

Usually, such issues are soldering point issues. Double check all soldering points, either by carefully inspecting them under bright light, or by just re-soldering all of them just in case.

If nothing else helps, maybe soldering another one is the easiest way to a working board for now.

Closed 2022-07-08.

Thread 57 (2022-07-13):

Teensy 3.6 pin mapping

basketofkittens, 2022-07-13:
I'm doing a custom keyboard and I'd like to use QMK with a Teensy 3.6. This config seems to be real close to what I need, but I'm a little confused on the pin mapping.

`/kinesis/kint36/config.h` has the following lines:
```
#define MATRIX_ROW_PINS { D3, C3, C4, C6, D2, B0, D7, A12, A13, B17, B16, D0, B1, C2, D6 }
#define MATRIX_COL_PINS { B3, D1, C0, D5, C1, B2, D4 }
```

These don't really make any sense to me in the context of a Teensy 3.6 or with the pins that are wired out on the kinT board itself (eg ROW_0 is tied to Teensy pin 0, which for a 3.6 is PTB16).

Sorry if this is more of a QMK-specific question, but I'm new to all this and it's proving to be an absolute jungle.

stapelberg, 2022-07-13:
Have a look at https://github.com/qmk/qmk_firmware/issues/13052 for some context. QMK started out on AVR microcontrollers, that’s where the names come from.

basketofkittens, 2022-07-17:
Thanks for the quick reply! Sorry I couldn't get back to this sooner.

It seems I had made an opening assumption while looking at the schematic that the ROW_0 net on the schematic was tied to the 0th entry of the MATRIX_ROW_PINS list. This is what screwed me up. I thought there was some kind of funky re-mapping going on between the MK6x port/pin naming and the config. Upon a closer inspection it's clear that the config is a simple 1:1 mapping of the MK6x port/pin numbers. This makes it nice and easy.

Thanks again for the help!

Closed 2022-07-17.

Thread 58 (2022-08-08):

Is there any technical advantage between 3.6 and 4.1?

rockybulwinkle, 2022-08-08:
As title says, I'm wondering if there is any technical reason to pick the teensy 3.6 vs 4.1 in terms of performance or functionality?

I want to make my keyboard wireless and battery powered. If there isn't a substantial difference in performance or functionality between the two, I should pick whichever uses less power.

Thanks!

stapelberg, 2022-08-08:
The 4.1 performs better (see its lower input latency, for example), but that won’t really make a measurable difference to the already excellent level of performance of the teensy 3.6.

See https://forum.pjrc.com/threads/60698-Teensy-3-6-vs-4-0-measured-power-draw-at-various-MHz for a power consumption comparison. With default settings, they’re roughly equal in terms of power consumption. The best solution would be to use a Teensy 4.1 and down-clock it, but I haven’t done that yet (and there might not be easy support for it from within QMK).

So, you can probably chose either one. The 4.1 is a little bit cheaper.

rockybulwinkle, 2022-08-09:
Thanks, that's very informative!

Closed 2022-08-09.

Thread 59 (2022-08-29):

Stapleberg could wake computer from sleep, but not new kinT41

aaronjensen, 2022-08-29:
I just got a new KA2 w/ a kinT41 (w/ teensy 4.0). I have macOS and, for some reason, I cannot wake my laptop up from sleep using the kinT41. It worked fine with my old KA2 + stapleberg. This is my firmware: https://github.com/aaronjensen/qmk_firmware/tree/aaron/keyboards/kinesis/keymaps/aaronjensen which, aside from mapping, doesn't really have anything custom afaik.

Is this a common thing, or is there anything else that I should look at for this type of issue? Thanks!

stapelberg, 2022-08-29:
I’m surprised to hear that it worked for you with the old controller (maybe not running QMK?).

When I tested it, I couldn’t get waking up to work at all with QMK, even with the older kint36. See bug report at https://github.com/qmk/qmk_firmware/issues/16934

aaronjensen, 2022-08-29:
Yeah, it was running QMK. It woke fine for a couple years. Thanks for the link to the issue. Feel free to close this one since it’s tracked upstream.

afonsoguerra, 2022-08-29:
Just to say that I also can’t wake the computer with the kint41, the trackpad or any other key works, but not the kint41. That said, it is not a problem with QMK per se, because I have a keyboardio 01 and Atreus, both running QMK and they both work for waking up my machine, so it might be a power state thing with the keyboard itself?
I’m talking about ‘press-any-key’ wakeup and not specifically the keycode mentioned in the upstream issue.

aaronjensen, 2022-08-29:
There must be specific sleep states where it can wake. This morning, it woke for me:

```
2022-08-29 09:05:52 -0400 Assertions            PID 327(powerd) Created UserIsActive "com.apple.powermanagement.kernel.useractive AppleUserHIDEventDriver:sleepDisplayTickle kIOMessageSystemWillS" 00:00:00  id:0x0x900009129 [System: DeclUser BGTask kCPU kDisp]
2022-08-29 09:05:52 -0400 Assertions            PID 385(WindowServer) Created UserIsActive "com.apple.iohideventsystem.queue.tickle serviceID:100001b0c name:AppleUserHIDEventSe product:kinT (kint41) eventType:3" 00:00:00  id:0x0x90000912a [System: DeclUser BGTask kCPU kDisp]
2022-08-29 09:05:52 -0400 Wake                  DarkWake to FullWake from Deep Idle [CDNVA] : due to UserActivity Assertion Using AC (Charge:100%)
2022-08-29 09:05:52 -0400 WakeDetails           DriverReason:NUB.SPMISw3IRQ - DriverDetails:
DriverReason:nub-spmi0.0x02 - DriverDetails:
DriverReason:rtc - DriverDetails:
2022-08-29 09:05:52 -0400 HibernateStats        hibmode=3 standbydelaylow=0 standbydelayhigh=0                                            11402
2022-08-29 09:05:52 -0400 WakeTime              WakeTime: 0.016 sec
```

I don't know much about sleep or how to interpret the above, but that's from `pmset -g log` on my macbook.

stapelberg, 2022-10-24:
> 2022-08-29 09:05:52 -0400 Wake                  DarkWake to FullWake from Deep Idle [CDNVA] : due to UserActivity Assertion Using AC (Charge:100%)

I suspect that when Apple decides to wake up your computer (“dark wake”) during the night, it no longer keeps the USB devices in standby state, but actually enumerates them and then listens to input.

---

I have since found out how to use any-key-to-wakeup on my lab PC (Intel i9-9900K on an ASUS PRIME Z370-A) using Linux:

Ensure `wakeup` is enabled for the USB device that is your keyboard (see `lsusb`):
```
echo enabled | sudo tee /sys/bus/usb/devices/1-10/power/wakeup
```

Then, suspend to RAM (e.g. `echo mem | sudo tee /sys/power/state`).

When pressing any key on the keyboard (not necessarily the `XF86WakeUp` key), the machine wakes up from suspend-to-RAM.

This behavior works on:

* kint2pp
* kint36
* Kinesis Advantage 360 Pro (with ZMK firmware)

But it does not work on the kint41 (and apparently kint40, which you are using).

The next step in debugging this is to compare the debug log of the different USB stacks to see if anything stands out.

stapelberg, 2022-10-25:
The good news is that the following changes to lib/chibios-contrib make waking a PC from suspend-to-ram work on the kint41.

The bad news is that the keyboard is then stuck and won’t work until un-plugged and re-plugged. Perhaps that’s a QMK-specific problem, so the next step in debugging is to reproduce the issue in a ChibiOS demo, or perhaps even an NXP demo.

We should also verify that the USB device descriptor indicates remote wakeup support, which might influence the value of the `power/wakeup` /sys file.

```diff
diff --git c/os/hal/ports/MIMXRT1062/LLD/USBHSv1/hal_usb_lld.c i/os/hal/ports/MIMXRT1062/LLD/USBHSv1/hal_usb_lld.c
index e4752c18..d143a66c 100644
--- c/os/hal/ports/MIMXRT1062/LLD/USBHSv1/hal_usb_lld.c
+++ i/os/hal/ports/MIMXRT1062/LLD/USBHSv1/hal_usb_lld.c
@@ -116,12 +116,16 @@ static usb_status_t usb_device_callback(usb_device_handle handle, uint32_t callb
     break;

   case kUSB_DeviceEventSuspend:
-    printf_debug("  suspend");
+    printf_debug("  suspend--nxp");
+    // Call USB_DeviceSetStatus() to enable the “detect resume” interrupt.
+    usb_device_struct_t *dev_handle = (usb_device_struct_t *)handle;
+    (void)USB_DeviceSetStatus(dev_handle, kUSB_DeviceStatusBusSuspend, NULL);
+    printf_debug("  suspend--chibi");
     _usb_suspend(usbp);
     break;

   case kUSB_DeviceEventResume:
-    printf_debug("  resume");
+    printf_debug("  resume--chibi");
     _usb_wakeup(usbp);
     break;
   }
diff --git c/os/hal/ports/MIMXRT1062/LLD/USBHSv1/hal_usb_lld.h i/os/hal/ports/MIMXRT1062/LLD/USBHSv1/hal_usb_lld.h
index 764fbc60..655f070c 100644
--- c/os/hal/ports/MIMXRT1062/LLD/USBHSv1/hal_usb_lld.h
+++ i/os/hal/ports/MIMXRT1062/LLD/USBHSv1/hal_usb_lld.h
@@ -408,8 +408,10 @@ struct USBDriver {
  * @notapi
  */
 #define usb_lld_wakeup_host(usbp)                                     \
-  do{                                                                 \
-  } while (false)
+  do{ \
+    usb_device_struct_t *dev_handle = (usb_device_struct_t *)handle; \
+    (void)USB_DeviceSetStatus(dev_handle, kUSB_DeviceStatusBusResume, NULL); \
+  } while (0)

 /*===========================================================================*/
diff --git c/os/hal/ports/MIMXRT1062/LLD/USBHSv1/usb_device_config.h i/os/hal/ports/MIMXRT1062/LLD/USBHSv1/usb_device_config.h
index c00e7bff..a3968d9e 100644
--- c/os/hal/ports/MIMXRT1062/LLD/USBHSv1/usb_device_config.h
+++ i/os/hal/ports/MIMXRT1062/LLD/USBHSv1/usb_device_config.h
@@ -154,11 +154,11 @@
 #define USB_DEVICE_CONFIG_BUFFER_PROPERTY_CACHEABLE (0U)
 #endif
 /*! @brief Whether the low power mode is enabled or not. */
-#define USB_DEVICE_CONFIG_LOW_POWER_MODE (0U)
+#define USB_DEVICE_CONFIG_LOW_POWER_MODE (1U)

 #if ((defined(USB_DEVICE_CONFIG_LOW_POWER_MODE)) && (USB_DEVICE_CONFIG_LOW_POWER_MODE > 0U))
 /*! @brief Whether device remote wakeup supported. 1U supported, 0U not supported */
-#define USB_DEVICE_CONFIG_REMOTE_WAKEUP (0U)
+#define USB_DEVICE_CONFIG_REMOTE_WAKEUP (1U)

 /*! @brief Whether LPM is supported. 1U supported, 0U not supported */
 #define USB_DEVICE_CONFIG_LPM_L1 (0U)
```

stapelberg, 2022-10-27:
> The bad news is that the keyboard is then stuck and won’t work until un-plugged and re-plugged. Perhaps that’s a QMK-specific problem, so the next step in debugging is to reproduce the issue in a ChibiOS demo, or perhaps even an NXP demo.

I tested whether older kint controllers work after waking up:

* kint36 does not work after waking up
* kint2pp does work after waking up

So perhaps it’s a problem with ChibiOS and/or the kint36/kint41 USB HAL. The kint2pp uses LUFA, which is a different stack.

stapelberg, 2022-10-27:
I think I got it working!

We need two changes in lib/chibios-contrib.

Fix 1: the NXP USB stack has its own hwTick variable, but we don’t have a SysTick ISR handler from which to feed that hwTick variable, so the NXP USB stack hangs after triggering a remote wakeup. This change works around the hang for now:

```diff
--- i/ext/nxp-middleware-usb/device/usb_device_ehci.c
+++ w/ext/nxp-middleware-usb/device/usb_device_ehci.c
@@ -1696,8 +1696,8 @@ usb_status_t USB_DeviceEhciControl(usb_device_controller_handle ehciHandle, usb_
 #endif
             ehciState->registerBase->PORTSC1 &= ~USBHS_PORTSC1_PHCD_MASK;
             ehciState->registerBase->PORTSC1 |= USBHS_PORTSC1_FPR_MASK;
-            startTick = deviceHandle->hwTick;
-            while ((deviceHandle->hwTick - startTick) < 10U)
+            startTick = DWT->CYCCNT;
+            while ((DWT->CYCCNT - startTick) < 10U)
             {
                 __NOP();
             }
```

Fix 2: we need to skip restarting the USB driver on remote wakeup:
```diff
--- i/os/hal/boards/PJRC_TEENSY_4_1/board.c
+++ w/os/hal/boards/PJRC_TEENSY_4_1/board.c
@@ -45,3 +45,7 @@ void __late_init(void) {
  */
 void boardInit(void) {
 }
+
+void restart_usb_driver(USBDriver *usbp) {
+    // Do nothing. Restarting the USB driver on these boards breaks it.
+}
```

I think that’s all we need, but I have only briefly tested these changes so far.

Will try and clean up these commits into a proper pull request over the next few days.

stapelberg, 2022-10-29:
Okay, I have sent https://github.com/ChibiOS/ChibiOS-Contrib/pull/345 (for the `kint41`) and https://github.com/ChibiOS/ChibiOS-Contrib/pull/346 (for the `kint36`).

With these pull requests applied, all kinT controllers (tested with `kint2pp`, `kint36`, `kint41`) should do USB remote wakeup (if enabled in the OS) and work after wakeup.

I’ll keep this issue open for visibility for a while (it will be a while until the PRs land in ChibiOS-Contrib, and another delay until they make their way to QMK develop, and then QMK master…).

aaronjensen, 2022-10-29:
That’s great, thanks.

aleb, 2022-10-31:
Is this an issue with Macs only? I can wake up my Linux from sleep just fine with a KB133+kintlc.

stapelberg, 2022-10-31:
No, the issue is with specific USB stacks, specifically the NXP stack used on the `kint41` and the ChibiOS driver used on the `kint36`.

danieldk, 2022-12-24:
> Is this an issue with Macs only? I can wake up my Linux from sleep just fine with a KB133+kintlc.

Interesting, on Mac (KB600 + KinT + LC) I cannot wake the machine using `KC_WAKE`. After waking the machine with my trackball, the keyboard is dead and I have to replug it.

stapelberg, 2022-12-24:
My current recommendation is to switch to kint36 if you need to wake your machine with your keyboard. It’s been working reliably for me with the kint36.

danieldk, 2022-12-26:
I disabled restarting of the USB stack like you did for kint36 and the last few suspend-wake cycles have worked.

https://github.com/danieldk/qmk_firmware/commit/56da1c36b849af9598ecac83e6123e6af57875cc

I'll report back after a few days.

danieldk, 2023-01-02:
Since I made this change, resume has worked (with any key) and the keyboard always works without replugging (with a Teensy LC).

Thread 60 (2023-02-14):

Keyboard has started sending inputs on its own

ameyp, 2023-02-14:
I've been using a kint with a teensy 3.6 on an Advantage 500 for a few years now (pretty much starting a few months after you made this available) and haven't had any issues till today. Out of nowhere, the keyboard has started randomly inputting characters. The problem seems isolated to roughly the top half of the keyboard based on the characters I see appear, so it's the function row, numbers row and QWERTY row, both halves.

I opened it up and blew away any dirt/crumbs that had accumulated, but that didn't fix it. My soldering work from back then wasn't perfect, but I don't see any bridged pins. Any ideas what might be causing this? Could the controller just be dying?

stapelberg, 2023-02-15:
Sorry to hear about your trouble with this build.

Typical causes for ghost key presses are indeed faulty soldering joints. It might be worth just going over all (most?) of your solidering joints.

Aside from soldering joints, another known aging issue is that individual key switches start bouncing more and more over time. This will typically manifest itself with one specific key first, not a whole range of keys.

Maybe https://github.com/kinx-project/kint/issues/16 is helpful to track down the issue more (to an individual GPIO line).

ameyp, 2023-02-15:
Thanks, I had a wonderful couple of years with the keyboard thanks to your work here, and would love a couple more!

I did take a look at that issue, but had trouble figuring out which `ROW_` nets mapped to physical rows on the board. I also took a look at the schematic PDF, but couldn't see that mapping there either.

Also, since my keys appear to be failing closed rather than open (aka 20-30 keypress events are being sent without any key being pressed) my intuition says that something is probably shorted. Is this conclusion correct? If so, how would I verify this, would checking for connectivity between the pins I discover using kicad and the `GND` pin be the way to go?

stapelberg, 2023-02-17:
> I did take a look at that issue, but had trouble figuring out which `ROW_` nets mapped to physical rows on the board. I also took a look at the schematic PDF, but couldn't see that mapping there either.

Can you enable QMK’s debug logging as mentioned in the issue? Then, it will print the key matrix on every key press, which should allow you to track down which column(s) and/or row(s) are affected.

> Also, since my keys appear to be failing closed rather than open (aka 20-30 keypress events are being sent without any key being pressed) my intuition says that something is probably shorted. Is this conclusion correct?

If something was shorted, you would probably not get key presses at all, or get key presses permanently. My guess is that some connection is “bouncing”.

> If so, how would I verify this, would checking for connectivity between the pins I discover using kicad and the GND pin be the way to go?

No, I don’t think that would help, as I don’t think anything is shorted to GND. As I said, in that case I would expect no key press to be generated at all.

Instead, you should be looking for connectivity that only works if you place your multimeter “just right”. But, as I said, it might be easier to identify the affected columns/rows and proactively re-solder the affected soldering joints instead of trying to use a multimeter.

ameyp, 2023-02-25:
I enabled debug mode, but only ran into this issue once after, and that was while the keyboard was connected to a PC without qmk on it. I cleaned out both key-wells (there was dog fur in them) and haven't run into the problem since, so I'm closing this issue. If I run into it again and can get console output (I'm leaving debug enabled) I'll re-open this. Thanks again for your help and for creating this awesome pcb!

Closed 2023-02-25.

Thread 61 (2023-02-24):

Tapping Home-E combo sends "3";  tapping PageUp-I combo sends "8"

GongYiLiao, 2023-02-24:
I have a kinT runnig on KB500 with default firmware and it runs flawlessly besides one problem: when I press Home and E  at the same time, I get a "3" showing on screen. On the other hand, if I press PageUp and I at the same time, I get an "8".

I get the same issue for Space + E, but I workaround it with combos "E_SPC" (for QWERTY) and "DOT_SPC" (for Dvorak)  in the following code (unfortunately the rest six combos do not work)

```
enum combos {
  E_SPC,
  I_8,
  PGUP_8,
  DOT_SPC,
  PGUP_C,
  C_8,
  HOME_3,
  DOT_3
};

const uint16_t PROGMEM e_spc_combo[] = { KC_E, KC_SPC, COMBO_END };
const uint16_t PROGMEM i_8_combo[] = { KC_8, KC_I, COMBO_END };
const uint16_t PROGMEM pgup_8_combo[] = { KC_PGUP, KC_8, COMBO_END };
const uint16_t PROGMEM dot_spc_combo[] = { KC_DOT, KC_SPC, COMBO_END };
const uint16_t PROGMEM pgup_c_combo[] = { KC_PGUP, KC_C, COMBO_END };
const uint16_t PROGMEM c_8_combo[] = { KC_C, KC_8, COMBO_END };
const uint16_t PROGMEM home_3_combo[] = { KC_HOME, KC_3, COMBO_END };
const uint16_t PROGMEM dot_3_combo[] = { KC_DOT, KC_3, COMBO_END };

combo_t key_combos[COMBO_COUNT] = {
  [E_SPC] = COMBO(e_spc_combo, KC_NO),
  [I_8] = COMBO(i_8_combo, KC_NO),
  [PGUP_8] = COMBO(pgup_8_combo, KC_NO),
  [DOT_SPC] = COMBO(dot_spc_combo, KC_NO),
  [PGUP_C] = COMBO(pgup_8_combo, KC_NO),
  [C_8] = COMBO(c_8_combo, KC_NO),
  [HOME_3] = COMBO(home_3_combo, KC_NO),
  [DOT_3] = COMBO(dot_3_combo, KC_NO)
};

```

I have tested it besides the QWERTY layout, I tested Dvorak keyboard layout on the same hardware and found that Home + "." gives me "3" and PageUp + C gives me "8". Again, Dvorak layout's "." sit on K31 and C sits on K81. Therefore it's seems not an layout issue.

Due to this unexpected outputs at symmetric positions:  K35 (Home) + K31 (E) => K30(3); K86(PageUp) + K81(I) => K80(8).  I am not sure if this is due to software setup or hardware issue.

Do anymore encounter a similar issue?

Thank you.

stapelberg, 2023-03-11:
Hey @GongYiLiao

Sorry for the late reply.

I just tried this out on my kint41 keyboard, and When I press PageUp+I, I don’t get any extra keys. (Testing with the Home key is inconvenient for me, as I remap it to be the Windows modifier keys.)

My first guess would be that this is a specific soldering joint that’s problematic.

You can find more details about the original kinesis keyboard matrix at https://web.archive.org/web/20180831175016/http://humblehacker.com/blog/20100720/hacking-the-kinesis-contoured-keyboard/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, but note that the wiring that the kinT controller uses is a little different. See the schematic: https://github.com/kinx-project/kint/blob/main/schematic-v2021-06-26.pdf

To get a better feel about the keyboard matrix, it might be easiest to enable debug mode and print the active row/col status when pressing a key: https://michael.stapelberg.ch/posts/2021-05-08-keyboard-input-latency-qmk-kinesis/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

Also see https://github.com/kinx-project/kint#general-technique-highlight-connections-in-kicad if you haven’t seen that yet.

Hope that helps, and good luck in tracking down the issue!

Thread 62 (2023-03-14):

Teensy 4.1: Random crashes | defective?

MrDeerly, 2023-03-14:
Hey!

First of all thanks for your awesome project!

I finished my build recently and ran into the following issue:

**Problem description**
My teensy seems to crash after a while (can be hours, or just minutes) and enters the bootloader mode where the small led at the usb port is permanent on. After this the keyboard is not usable anymore, but still listed with hid_lister. I need to replug the cable to get things working again.  This happens with with the firmware you linked in the readme (_QMK 0.17.9_).

**Things i did**
Initially i thought it might be just an issue with the old firmware, so i went ahead and compiled the default firmware with the latest qmk version (_QMK 0.20.1_). While the compilation itself was successful, i started to have issues flashing the teensy. [QMK mysys](https://msys.qmk.fm/) gave me errors when trying to flash the teensy: `error writing to teensy`. I did some research but couldn't find any helpful information about it which is why i used the standart teensy loader for flashing. Flasing worked flawless, **but now** with the latest qmk version the teensy seem to crash straight away (after seconds). Replugging doesn't help at all in this case.

After the unsuccessful firmware update i went ahead and checked the hardware itself for possible shorts, including measurements.. nothing :/

**Considerations**

I have a few ideas what could be wrong, but no idea how to debug it best:

A) Teensy overheats with the old version after quite some time. With the new version instantly?!
B) The latest qmk version has a bug and is incompatible with teensy4.1 (https://github.com/kinx-project/kint/issues/45). Am i the first person to discover?
C) The teensy is defective.

Did you ever heard of those problems or experienced them? Do you have any hint how to debug the issue better, or a wild guess?

Thanks in advance!

stapelberg, 2023-03-14:
I think it’s most likely that your Teensy is defective, in particular if you’re getting errors during flashing. Have you swapped the USB cable already? That would be good to verify, just in case.

I haven’t heard from anyone else regarding such symptoms.

In case it helps, I’m currently running QMK at commit https://github.com/qmk/qmk_firmware/commit/543a863766192eab626492ec4f48641743ffc797 on my main keyboard, so that version should work for sure.

Good luck debugging this, though I would probably just solder another board to see if it works with a new set of components…

MrDeerly, 2023-03-16:
Thanks for your quick answer... much appreciated!

I did some more testing and found out that actually Windows is causing a lot of issues (what a surprise lol). To be more precise it's probably windows defender. On unix I'm able to flash the teensy without any issues. When using the latest version of qmk I still have those reboots, but not instant as before (which still seems a bit weird). With the version you've linked, it seems to be pretty stable (no crash so far, but maybe I was just lucky).

I will definitely try different versions of qmk till if find the (for me) broken version and identify deprecation. Of course only if it really is a software issue.

One last question if I may: How would you debug this issue? Enable logs and see what happened before a crash?

Thanks!

stapelberg, 2023-03-18:
> One last question if I may: How would you debug this issue? Enable logs and see what happened before a crash?

Yeah, in general, I would recommend to use as many tools as possible when debugging. You can use the HID based console (https://michael.stapelberg.ch/posts/2021-05-08-keyboard-input-latency-qmk-kinesis/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), or you can connect a USB-to-serial adapter and enable the serial console, but that’s a bit more involved on both the software and hardware side.

lread, 2023-07-16:
FWIW, I got a an error when trying a `qmk flash`, the error looked like so:
```
Programming.error writing to Teensy

gmake[1]: *** [platforms/avr/flash.mk:173: flash] Error 1
Make finished with errors
gmake: *** [Makefile:392: kinesis:lread:flash] Error 1
```

I unplugged my keyboard, and plugged in it an retried.
Same issue.
I then flashed the kint41 hex file with the teensy loader as described [here](https://github.com/kinx-project/kint#installing-the-firmware).

After that I seem to be able to flash with qmk again.

I'm using a Teensy 4.1 and qmk 1.1.2.

Thread 63 (2023-03-23):

Error Flashing 4.0

222Phoenix, 2023-03-23:
Just finished soldering the pcb & teensy 4.0 but I'm not able to flash it.

I tried the default one (kinesis_kint41_default.hex)
https://github.com/kinx-project/kint/tree/main/default-firmware
and also my own compiled via QMK MYSYS

I tried both teensy loader and QMK toolbox on different computers and different USB cables.

This is the error when trying to flash the default hex via QMK Toolbox:

*** Halfkay device connected (HidUsb): (Standard system devices) USB Input Device (16C0:0478:0108)
*** Attempting to flash, please don't remove device
>>> teensy_loader_cli.exe -mmcu=atmega32u4 "C:\Users\admin\Desktop\kinesis_kint41_default.hex" -v
    Teensy Loader, Command Line, Version 2.1
    Warning, HEX parse error line 1
    error reading intel hex file "C:\Users\admin\Desktop\kinesis_kint41_default.hex"

stapelberg, 2023-03-23:
In https://github.com/kinx-project/kint/issues/62, someone mentioned that flashing from Windows might have issues.

Can you try flashing from a computer running Linux? You can start your computer from a live linux USB stick.

222Phoenix, 2023-03-23:
Just tried in Ubuntu. I don't see an error, so it seems like it worked, but the keys still do nothing. Wonder if it's a bad Teensy. Flashing the LED blink program via Teensy loader did work though.

qmk flash -kb kinesis/kint41 -km default
Ψ Compiling keymap with gmake --jobs=1 kinesis/kint41:default:flash

QMK Firmware 0.20.1
⚠ kinesis/kint41: IGNORE_MOD_TAP_INTERRUPT in config.h is deprecated and will be removed at a later date
Making kinesis/kint41 with keymap default and target flash

⚠ kinesis/kint41: IGNORE_MOD_TAP_INTERRUPT in config.h is deprecated and will be removed at a later date
arm-none-eabi-gcc (15:10.3-2021.07-4) 10.3.1 20210621 (release)
Copyright (C) 2020 Free Software Foundation, Inc.
This is free software; see the source for copying conditions.  There is NO
warranty; not even for MERCHANTABILITY or FITNESS FOR A PARTICULAR PURPOSE.

Size before:
   text	   data	    bss	    dec	    hex	filename
      0	  40568	      0	  40568	   9e78	kinesis_kint41_default.bin

Compiling: quantum/command.c                                                                        [OK]
Linking: .build/kinesis_kint41_default.elf                                                          [OK]
Creating binary load file for flashing: .build/kinesis_kint41_default.bin                           [OK]
Creating load file for flashing: .build/kinesis_kint41_default.hex                                  [OK]

Size after:
   text	   data	    bss	    dec	    hex	filename
      0	  40568	      0	  40568	   9e78	kinesis_kint41_default.bin

Copying kinesis_kint41_default.bin to qmk_firmware folder                                           [OK]
Flashing for bootloader: halfkay
Teensy Loader, Command Line, Version 2.2
Read ".build/kinesis_kint41_default.hex": 40568 bytes, 2.0% usage
Found HalfKay Bootloader
Programming......................................
Booting

stapelberg, 2023-03-24:
You can try the prebuilt firmware images on https://github.com/kinx-project/kint/ to see if it’s a problem with your build or with your teensy.

stapelberg, 2023-05-01:
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

Sorry for the late reply.

I cannot reproduce this issue.

When I download the default firmware file, I can flash it without issues to a Teensy 4.1:

```
% wget https://raw.githubusercontent.com/kinx-project/kint/main/default-firmware/kinesis_kint41_default.hex
--2023-05-01 19:24:17--  https://raw.githubusercontent.com/kinx-project/kint/main/default-firmware/kinesis_kint41_default.hex
Loaded CA certificate '/etc/ssl/certs/ca-certificates.crt'
Resolving raw.githubusercontent.com (raw.githubusercontent.com)... 2606:50c0:8001::154, 2606:50c0:8002::154, 2606:50c0:8000::154, ...
Connecting to raw.githubusercontent.com (raw.githubusercontent.com)|2606:50c0:8001::154|:443... connected.
HTTP request sent, awaiting response... 200 OK
Length: 105050 (103K) [text/plain]
Saving to: ‘kinesis_kint41_default.hex’

kinesis_kint41_default.hex                      100%[====================================================================================================>] 102,59K  --.-KB/s    in 0,01s

2023-05-01 19:24:17 (7,52 MB/s) - ‘kinesis_kint41_default.hex’ saved [105050/105050]

% teensy-loader-cli -mmcu=imxrt1062 -w -v kinesis_kint41_default.hex                               
Teensy Loader, Command Line, Version 2.2
Read "kinesis_kint41_default.hex": 37322 bytes, 1.8% usage
Waiting for Teensy device...
 (hint: press the reset button)
Found HalfKay Bootloader
Read "kinesis_kint41_default.hex": 37322 bytes, 1.8% usage
Programming...................................
Booting
```

I’m strongly suspecting that the issue you’re running into is caused by how you downloaded the file. I suggest downloading the repository as a zip file from GitHub and then unpacking that.

Closed 2023-05-01.

Thread 64 (2023-03-25):

GMK Configurator Kint41 creates a bin file and not a hex

Chamels, 2023-03-25:
As the title suggests, the GMK configurator creates a bin file and not a hex. Due to this, you can not properly flash the board.
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
When downloaded it saves the bin file.

Chamels, 2023-03-25:
[kinesis_kint41_kinesis.zip](https://github.com/kinx-project/kint/files/11070426/kinesis_kint41_kinesis.zip)
Here's the bin file if anyone wants to see it.

MrDeerly, 2023-03-28:
I also experienced this. I'd suggest to raise issue here: https://github.com/qmk/qmk_configurator

MrDeerly, 2023-05-03:
Got fixed quite a while ago in here: https://github.com/qmk/qmk_firmware/pull/20295

Thread 65 (2023-04-27):

Help: Aisler Errors in Smart Testing

kamronbatman, 2023-04-27:
Hey everyone,

I decided to venture into DIY hardware and this is my first project so I need some guidance.

I ordered boards based on the newest specs and it looks like they came back with errors during testing. Does this mean I should ask them to manufacture them again since they will be defective? Or is this ok?

Thanks!

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

stapelberg, 2023-04-27:
> I ordered boards based on the newest specs and it looks like they came back with errors during testing. Does this mean I should ask them to manufacture them again since they will be defective? Or is this ok?

The component in question is the solder jumper, so I’m leaning towards saying that this is okay and nothing to worry about.

I’m not entirely sure why you’re getting this error and not others (or maybe others are getting the error, too?). Maybe this changed with KiCad 6, or maybe we should be doing something differently in our design files… Maybe someone with more KiCad experience can weigh in.

kamronbatman, 2023-04-28:
Here is the response from support:

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

stapelberg, 2023-04-28:
I wonder if this issue was introduced with commit https://github.com/kinx-project/kint/commit/afac7593b2d746b0df2951f4b0d2ef72b4ce3b4c (cc @cincodenada)

If you want a known-working revision, v2021-04-25 is the latest revision that I have in my keyboards. Sorry for the trouble with this.

stapelberg, 2023-04-29:
To be quite honest, even after re-reading the support reply, I’m not sure if there really is a problem with the boards.

In the reply, JP4, JP5 and JP6 are listed, and those are all the connected-by-default solder jumpers on the board. I’m still suspecting that either their tool gets tripped up by solder jumpers, or that we have somehow incorrectly designed/placed the solder jumpers.

A connection between J5/1 and U1/7 (the “fault” the e-tester found) is expected, so maybe no correction is necessary at all and the board just works.

But, yes, in case you do need to correct something, I think you could just cut traces close to the Teensy pins on the PCB. I would give it a try (no need to order a new revision just yet), but be sure you have more than one Teensy in case something goes wrong :)

kamronbatman, 2023-04-29:
I ordered 3 of everything, but I am thinking about ordering removable pin headers for the teensy, so if I have to cut/desolder, it's only pin headers. 🤔

aleb, 2023-04-29:
The boards are fine. I also noticed this error before. Aisler's software expects these "nets" to be disconnected. The idea is that if they are connected then they should be a single "net".

cincodenada, 2023-04-29:
Oh sorry, I had drafted a reply but never finished it! The others are correct, yes, the boards should function just fine - the net-ties here are indeed intentional, the jumpers are intended to be connected these two nets in the normal case, if you were working with a Teensy 2 you would cut them to disconnect.

I'm not sure if there is a way to notate that in a way that Aisler will be happy with, I thought that the new version of KiCad had improved net-tie support, but I'm not familiar enough with the details of those exports to know - are you uploading the KiCad files directly to Aisler, or generated Gerbers?

cincodenada, 2023-04-29:
If there's an easy way to notate this in a way that will make Aisler's checker happy, that would be optimal, otherwise we might want to add a note to the README about ignoring errors about shorts in JP4/5/6

kamronbatman, 2023-04-29:
yeah, I am not sure how to either, but I can ask their support. I uploaded the [kint.kicad_pcb](https://github.com/kinx-project/kint/blob/main/kicad/kint.kicad_pcb) file directly. Maybe I was supposed to send them other files too, but I didn't see a way to do that, so I am not sure.

stapelberg, 2023-04-30:
> Maybe I was supposed to send them other files too, but I didn't see a way to do that, so I am not sure.

No, the advantage of Aisler and other modern manufacturers is that you only need to upload one kicad file and they do the remaining processing.

stapelberg, 2023-05-02:
Let’s leave this issue open for easier discoverability. And, ideally someone could contribute a fix to make the design just work with Aisler’s checker :)

impaktor, 2023-05-04:
(github allows pinning an issue. Not sure if it only works for open or also possible for closed issues).

Thread 66 (2023-05-08):

kinT (teensy 4.1) with Vial/Via

JasonhjKim, 2023-05-08:
Hey Stephen,
This is not a really an issue, but just description on my failed attempt.
I was wondering if you have tried loading vial/via on to your qmk code before? I'm currently attempting with your kinT41 code base. Only time I got it to successfully create the hex file is by bumping up the `TRANSIENT_EEPROM_SIZE = 500` for `DYNAMIC_KEYMAP_LAYER_COUNT= 2`. However, once I programme it on to my teensy4.1, it errors out with 7 blinks. According to the documentation https://www.pjrc.com/store/ic_mkl02_t4.html
```
7 Blinks = ARM JTAG DAP Communication Error
    A communication error was detected, but after correctly detecting (4 blinks) and initializing the ARM JTAG DAP (9 blinks). Programs which crash or have unusual startup behavior can cause a temporary 7 blink error at startup. With a known-good program or blank flash chip, this error may indicate a severe signal quality problem or any of the signal wires shorted to other lines which are initially high impedance but become output after a program is running. But these types of hardware issues are unusual, because hardware trouble for 7 blinks requires first successfully passing tests which would cause 4 or 9 blinks. 7 blinks can also be shown if the processor reboots, either by software write to SCB_AIRCR or due to fault or other error handling, while communication is in progress. If you see 7 blinks, program the flash memory with a simple known-good code before investigating hardware trouble.
```

JasonhjKim, 2023-05-08:
rules.mk
```
VIA_ENABLE = yes
VIAL_ENABLE=yes
VIAL_INSECURE = yes
LTO_ENABLE = yes
QMK_SETTINGS = no
TAP_DANCE_ENABLE = no
KEY_OVERRIDE_ENABLE = no
COMBO_ENABLE = no
EEPROM_DRIVER = transient
```
config.h
```
#pragma once
#define VIAL_KEYBOARD_UID {0x7A, 0x7F, 0xB3, 0x95, 0x6D, 0x43, 0x3B, 0x0E}
#define DYNAMIC_KEYMAP_LAYER_COUNT 0
#define VIAL_KEY_OVERRIDE_ENTRIES 4
#define VIAL_COMBO_ENTRIES 4
#define VIAL_TAP_DANCE_ENTRIES 4
#define TRANSIENT_EEPROM_SIZE 200
```
keymap.c
```
#include QMK_KEYBOARD_H

#define QWERTY 0 // Base qwerty

/****************************************************************************************************
*
* Keymap: Default Layer in Qwerty
*
* ,-------------------------------------------------------------------------------------------------------------------.
* | Esc    |  F1  |  F2  |  F3  |  F4  |  F5  |  F6  |  F8  |  F9  |  F10 |  F12 | PSCR | SLCK | PAUS |  FN0 |  BOOT  |
* |--------+------+------+------+------+------+---------------------------+------+------+------+------+------+--------|
* | =+     |  1!  |  2@  |  3#  |  4$  |  5%  |                           |  6^  |  7&  |  8*  |  9(  |  0)  | -_     |
* |--------+------+------+------+------+------|                           +------+------+------+------+------+--------|
* | Tab    |   Q  |   W  |   E  |   R  |   T  |                           |   Y  |   U  |   I  |   O  |   P  | \|     |
* |--------+------+------+------+------+------|                           |------+------+------+------+------+--------|
* | Caps   |   A  |   S  |   D  |   F  |   G  |                           |   H  |   J  |   K  |   L  |  ;:  | '"     |
* |--------+------+------+------+------+------|                           |------+------+------+------+------+--------|
* | Shift  |   Z  |   X  |   C  |   V  |   B  |                           |   N  |   M  |  ,.  |  .>  |  /?  | Shift  |
* `--------+------+------+------+------+-------                           `------+------+------+------+------+--------'
*          | `~   | INS  | Left | Right|                                         | Up   | Down |  [{  |  ]}  |
*          `---------------------------'                                         `---------------------------'
*                                        ,-------------.         ,-------------.
*                                        | Ctrl | Alt  |         | Gui  | Ctrl |
*                                 ,------|------|------|         |------+------+------.
*                                 |      |      | Home |         | PgUp |      |      |
*                                 | BkSp | Del  |------|         |------|Return| Space|
*                                 |      |      | End  |         | PgDn |      |      |
*                                 `--------------------'         `--------------------'
*/

const uint16_t PROGMEM keymaps[][MATRIX_ROWS][MATRIX_COLS] = {
[QWERTY] = LAYOUT(
           KC_DEL, KC_F1  ,KC_F2  ,KC_F3  ,KC_F4  ,KC_F5  ,KC_F6  ,KC_F7  ,KC_F8,
           KC_EQL, KC_1   ,KC_2   ,KC_3   ,KC_4   ,KC_5   ,
           KC_TAB, KC_Q   ,KC_W   ,KC_E   ,KC_R   ,KC_T   ,
           KC_CAPS,KC_A   ,KC_S   ,KC_D   ,KC_F   ,KC_G   ,
           KC_LSFT,KC_Z   ,KC_X   ,KC_C   ,KC_V   ,KC_B   ,
                   KC_GRV ,KC_INS ,KC_LEFT,KC_RGHT,
			   KC_LCTL,KC_LALT,
                                    KC_LGUI,
                           KC_BSPC,KC_ESC ,KC_END ,
    KC_F9  ,KC_F10 ,KC_F11 ,KC_F12 ,KC_PSCR ,KC_SLCK  ,KC_PAUS, MO(1), QK_BOOT,
	KC_6   ,KC_7   ,KC_8   ,KC_9   ,KC_0   ,KC_MINS,
	KC_Y   ,KC_U   ,KC_I   ,KC_O   ,KC_P   ,KC_BSLS,
	KC_H   ,KC_J   ,KC_K   ,KC_L   ,KC_SCLN,KC_QUOT,
	KC_N   ,KC_M   ,KC_COMM,KC_DOT ,KC_SLSH,KC_RSFT,
		KC_UP  ,KC_DOWN,KC_LBRC,KC_RBRC,
           KC_RALT,KC_RCTL,
           KC_PGUP,
           KC_PGDN,KC_ENTER ,KC_SPC
    )
};
```

stapelberg, 2023-05-08:
EEPROM support is a mixed bag currently.

Take a look at https://github.com/kinx-project/kint/issues/8 for the Teensy 3.6, where we never succeeded in making EEPROM support work. It worked on some devices, but others wouldn’t boot — had to revert the commit from QMK.

I don’t know what the Teensy 4.x situation is, but I haven’t done any work on EEPROM support, and I’m not sure anyone else has…

JasonhjKim, 2023-05-08:
I can try making similar changes you made [here](https://github.com/stapelberg/qmk_firmware/commit/2fc2c6fc91f0ea663a6791f3ef437e07981bb5cc) for teensy4.1

Thread 67 (2023-06-29):

Recommended PCB version?

lread, 2023-06-29:
Hello! Thanks so much for sharing this very cool project!

I was about to get a kinT keyboard controller PCB printed when I noticed that your link to [Buy PCB|OSHPark] shows v2020-06-30, but if I upload kint.kicad_pcb from this git repo to OSHPark, I see v2022-04-15.

Is the latest the greatest? Or is it better to stick with v2020-06-30?

stapelberg, 2023-06-29:
If you want a known-working revision, v2021-04-25 is the latest revision that I have in my keyboards.

But the latest version should be fine, too (there are no known issues at least).

You can look through https://github.com/kinx-project/kint/commits/main to see what has changed when. I think the only two board changes since then are https://github.com/kinx-project/kint/commit/e50db5470b10f921d979dec410ea861ebf73b23e and https://github.com/kinx-project/kint/commit/afac7593b2d746b0df2951f4b0d2ef72b4ce3b4c. If you don’t want to use a Teensy++, you can ignore them.

lread, 2023-06-29:
Thanks so much for your answer @stapelberg, very helpful!

lread, 2023-07-02:
I'm going to try out the latest and report back my extreme success here.
(to give us one more data point on this newest version).

I guess there is no real reason to keep this issue open, so gonna close it.
(please feel free to re-open if you disagree)

Thanks again!

lread, 2023-07-16:
After some newbie soldering and resoldering, I'm here to report success with an OSH Park built PCB v2022-04-15 with a Teensy 4.1.

Thanks again for a fun and useful project, you have revived my dead Kinesis Advantage2!

stapelberg, 2023-07-17:
> I also had some newbiness with the molex connectors. I wasn't always inserting the ribbon deeply enough into the connector before closing. Do you want me to PR a tip to the README for this under troubleshooting?

sure

dm17, 2024-04-10:
The "full BOM" excludes the kinT and Teensy, correct? So we need only buy the "full BOM" and the correct Teensy - and we can then print the latest KinT PCB?

Closed 2023-07-02.

Thread 68 (2023-07-14):

Wiring matrix for the KB600 series?

teoh, 2023-07-14:
Hi @stapelberg,

I really love the work you and the team did here. I understand that kint uses the kinesis' matrix wiring as-is (i.e. no re-soldering of any keys).

Looking at your [schematic](https://github.com/kinx-project/kint/blob/main/schematic-v2021-06-26.pdf) and [qmk firmware](https://github.com/qmk/qmk_firmware/tree/master/keyboards/kinesis/kint41), it seems like you had to figure out the matrix wiring for all of the keys at some point.

I have two questions:
1. How did you figure out this underlying matrix wiring? For example, in `THUMB_LEFT_BAK_KB600` on your [schematic](https://github.com/kinx-project/kint/blob/main/schematic-v2021-06-26.pdf), how did you know the exact FPC connector pins that controlled the rows/cols in that thumb cluster?
2. Do you have this wiring matrix diagram, and is it available to share?

I figured I could take apart and de-solder my whole keyboard to find look at the wiring myself, but I just know I will break it.

stapelberg, 2023-07-15:
Have a look at https://michael.stapelberg.ch/posts/2013-03-21-kinesis_custom_controller/ for some historical context. The linked posts explain the matrix. They can still be read using the Web Archive:

* https://web.archive.org/web/20160418212428/http://humblehacker.com/blog/20100720/hacking-the-kinesis-contoured-keyboard/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
* https://web.archive.org/web/20161028223204/http://humblehacker.com/blog/20100814/hacking-the-kinesis-contoured-keyboard-part-ii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

Thread 72 (2023-08-15):

Teensy 4.1 without ethernet compatible?

isaacgale, 2023-08-15:
I'm assuming the version without ethernet would be compatible with QMK but I can't find a definitive answer. Can anyone please confirm? It would also save me a few bucks in components too.

aleb, 2023-08-15:
If cost is a concern, it also works with Teensy LC.

isaacgale, 2023-08-15:
Thanks for the reply @aleb I'm set on a 4.1 (want leds too)  also the not ethernet models are more available at present where I am at least

aleb, 2023-08-15:
You can have three leds controllable with Teensy LC. Teensy 4.1 would allow to control all four. What else can you do with it and not with LC?

If "4.1 without ethernet" is the same as "4.1", then there should be no reason for it to not work. No ethernet functionality is used. Can you check if there are any incompatibilities between the two versions?

stapelberg, 2023-08-20:
This is the first time I hear about the “no ethernet” variant :)

Yes, that variant should work perfectly fine (though I haven’t tried it), as we don’t use any ethernet related functionality.

Please update this issue once you have it working.

isaacgale, 2023-11-29:
@stapelberg I can confirm that the non-ethernet 4.1 works.

Thread 73 (2023-08-24):

Ghosting with KB500 & Teensy 4.0

mil, 2023-08-24:
Hi @stapelberg  - thanks for your excellent work on the kinT replacement controller project.

I'm facing an issue where with the stock firmware (hex) I get ghosting on certain keys. The pattern is mainly the 2nd row column keys produce the key above:
- `w` produces 2 sometimes
- `e` produces 3 sometimes
- `r` produces 4 sometimes
- `p` produces 0 sometimes
- `o` produces 9 sometimes

I'm trying to figure out what could possibly be wrong. It seems really strange as sometimes the keyboard works normally, and then sometimes ghosting will occur with the keys above (and I can't seem to isolate the issue). I lost the original stock controller so I can't be 100% sure its a KinT issue; however playing with some QMK variables like `DEBOUNCE` etc does produce different results (though nothing 'correct')... so I'm not sure really the best variable to be playing with.

Also I thought maybe it had something to do with `delay_inline`, but that didn't help much either:
https://github.com/qmk/qmk_firmware/blob/master/keyboards/kinesis/kint41/kint41.c#L55

Any help on where or how I could debug would be helpful, again the stock firmware .hex on github does produce the issue too, so maybe it's something specific to the matrix wiring on my KB500.

stapelberg, 2023-08-25:
My guess would be that this is wear & tear on either the key switches themselves (unlikely, increasing debounce time should help for individual key switches), the kinesis keywell PCBs, or the wiring between the PCBs and the micro controller.

Looking at the keyboard matrix, it seems like maybe COL_0 and/or COL_1 don’t have proper contact. Or maybe it’s the rows, not the columns? Easy to get confused, best to check both. You could try using the continuity test on your multimeter. Maybe that already shows something. Or inspect the PCB(s) for scratches. Or just try to re-solder the affected soldering joints proactively.

I hope any of this helps in your quest to find the problem!

mil, 2023-09-06:
Thanks for the feedback.

Turned out being an issue with soldering contact between the teensy and the PCB. Fixed it after all

Thread 74 (2023-09-14):

Request for JSON key config and Key Code Information

hellmind, 2023-09-14:
Hello,

I'm interested in obtaining information regarding the the JSON file containing the key mappings. My primary goal is to identify the key code used in the QMK firmware to trigger programming mode. Currently, when I use the key combination to enter programming mode ("qk_boot"), the device restarts, and this process takes a considerable amount of time. I would like to know if there is a more efficient way to enter programming mode and if there is a way to make the device exit this mode or restart automatically without having to reconnect the USB cable.

Additionally, I would appreciate guidance on the correct procedure for adding a new key to the device. If it is not defined in the matrix or if it is necessary to use keys that are on the keyboard's diagram, I would like to know how to proceed. If it's not possible to add a new key directly, I'm also considering the option of connecting it in parallel to another key, such as "keypd," but this may require soldering a diode to the Teensy 4.1 contacts, since im gonna use a pedal (simple switch, piano/keyboard sustain).

I am currently using three Teensy 4.1 devices. Any information or guidance you can provide would be greatly appreciated.

Thank you in advance for your assistance!

stapelberg, 2023-09-17:
This sounds like a general QMK question, so it would be better to ask the question in the QMK support channels.

I’m afraid I don’t know the answers to your questions, but maybe someone else can chime in.

hellmind, 2023-09-18:
Mr. Stapelberg, I wanted to express my sincere gratitude for all the hard work you've put into this project. It's truly an honor to receive your response and guidance.

I've made significant progress with the project of installing a pedal, but I've encountered some issues related to radio frequency interference (RFI). It appears that extending the keyboard matrix without any filtering or protection might not have been the best approach. When I transmit and the pedal is engaged, the keyboard goes haywire and sends multiple keypress signals.

I'm now exploring ways to effectively filter out this interference to ensure the smooth operation of the system. Your expertise and insights have been invaluable in this endeavor, and I appreciate your continued support.

As a radio enthusiast, my primary intention for implementing the pedal is to enhance my radio communication setup, specifically for push-to-talk functionality. This pedal will play a crucial role in facilitating seamless communication during my radio operations.

Thank you once again for your dedication and assistance.

aleb, 2023-09-19:
The issue you describe might be caused by "contact bouncing". Not sure what would be best in your case, a hardware debouncer or a software debouncing algorithm. See https://github.com/qmk/qmk_firmware/blob/master/docs/feature_debounce_type.md for what you can do with QMK.

hellmind, 2023-09-19:
I heard on some forums that the issue could potentially be resolved by
adding a 100-ohm resistor in series.
I'll try that first since it works perfectly when I'm not transmitting.

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

Thread 75 (2023-09-25):

red light blinking and cant flash. Keyboard doesnt type.

ussher, 2023-09-25:
Video of the Teensy 4.1 board showing the red light flashing:
https://www.youtube.com/shorts/t0Yrm5OCTzw

I've been using the current QMK firmware on the keyboard for about a week, its been working fine.  After dinner I went to use it and no key press had any output.  I tried unplugging and re-plugging, tried different usb ports and even tried switching the cable but its all the same, no keypress has any output.

I wanted to try re-flashing QMK .hex file but where pressing the button on the Teensy 4.1 used to cause an orange led to flash then the flashing would finish, now pressing that same button does not result in the orange led flashing.

The issue seams to be with the red flashing LED but im not sure what that means or steps to take to get the keyboad working again.

I bought the unit pre-assembled from a seller on ebay with teensy 4.1 installed.

This isn't really a problem with this code, but I've run out of other ideas on how to get it working.  Hopefully someone can point me in the right direction. thanks.

ussher, 2023-09-25:
It looks to me like the "2 Blinks = NXP JTAG Not Responding" code from here:
https://www.pjrc.com/store/ic_mkl02_t4.html

"....2 Blinks = NXP JTAG Not Responding
    No communication is working! The 2 likely causes for this problem are improper power startup sequence, or a problem with any of these connections between the MKL02 and IMXRT chip:......."

Not sure what to do about that though.

stapelberg, 2023-09-25:
Sounds like either a bad Teensy or a bad soldering contact.

You could try re-soldering any soldering joints that don’t look 100%, or even just all joints.

If re-soldering doesn’t help, you probably need to put in a new Teensy. It looks like your build does not use a socket, so effectively you’ll need to buy a new board.

ussher, 2023-09-25:
argh, thanks.  I bought that one through ebay fully assembled.  I can get teeny from amazon here (japan) and do have a soldering iron but very little faith in my skills.   Since it did work for a while then stopped working my suspicion is your first idea 'a bad teensy' is the most likely.

I'll procrastinate a while on it.

Thanks for the help.

stapelberg, 2023-09-25:
> I can get teeny from amazon here (japan) and do have a soldering iron but very little faith in my skills.

Just to be clear: de-soldering a broken teensy and soldering in a new teensy is virtually impossible.

For my first tip of going over the soldering joints, you don’t need any new parts — just a soldering iron and the same kind of solder (lead vs. lead-free) that was used with the board. If you don’t trust your soldering skills, maybe there is a repair cafe, hackerspace or makerspace in your city or area with people who could help out.

But yeah, just buying a new fully-assembled board will be the easiest solution for sure.

Closed 2023-09-25.

Thread 76 (2023-10-14):

JSON/keymap changes in latest QMK for kint41 et al

afonsoguerra, 2023-10-14:
Hi all,

Maybe I'm missing something obvious, but I just tried importing my old, tried and tested keymap JSON files to the qmk config website and it's now all over the place. I then changed the old keymap.c file I had by hand and reflashed the keyboard (also with the latest qmk) and ... it didn't go well. After a bit of github digging, it seems that the keymap layout for these keyboards changed recently (https://github.com/qmk/qmk_configurator/pull/1312).

Does anyone have knowledge or a suggestion on how to port a JSON or c keymap (I know both are interchangeable) to the new layout arrangement? I would rather not have to reconfigure my 5 layers by hand if I can avoid it.

Thanks for any help!

stapelberg, 2023-10-15:
I’m not sure — I haven’t really followed QMK development closely over the last few months.

In general, you will have the best chances for a good reply if you post this question at the QMK support channels.

afonsoguerra, 2023-11-25:
This turned into a case of scratching my own itch... but in the hope that it will help someone else in the same situation, where one has a complex, multi-layer keymap that they want to port to the latest version of QMK, I'm attaching the correspondence between the old and new layout. The file has three columns, position in old layout, position in new layout, key code from default keymap.

[keymap_conversion.txt](https://github.com/kinx-project/kint/files/13464067/keymap_conversion.txt)

I'm happy to develop this further, submit a PR with a little script or whatever else is useful, if there is interest.

Thanks again for all your work on this project, it's been a lifesaver for my hands in more ways than one.

mgsloan, 2024-01-06:
Thanks so much for the script @afonsoguerra !  Nice time saver even for my single layer layout.

conceptual-perception, 2024-02-25:
@afonsoguerra, I'm interested. The above issue on the QMK_Configurator project is mine.

I tried to get this working with my JSON.
[ariadne-4-jan-2023-v2.json](https://github.com/kinx-project/kint/files/14398191/ariadne-4-jan-2023-v2.1.json)

I get this error.

```
ariadne@tesseract:~/kinesis-kint$ python3 keymap_json_converter.py -i ariadne-4-jan-2023-v2 -o ariadne-4-jan-2023-v3

{0: 0, 1: 1, 2: 2, 3: 3, 4: 4, 5: 5, 6: 6, 7: 7, 8: 8, 9: 18, 10: 19, 11: 20, 12: 21, 13: 22, 14: 23, 15: 30, 16: 31, 17: 32, 18: 33, 19: 34, 20: 35, 21: 42, 22: 43, 23: 44, 24: 45, 25: 46, 26: 47, 27: 54, 28: 55, 29: 56, 30: 57, 31: 58, 32: 59, 33: 66, 34: 67, 35: 68, 36: 69, 37: 74, 38: 75, 39: 78, 40: 80, 41: 81, 42: 82, 43: 9, 44: 10, 45: 11, 46: 12, 47: 13, 48: 14, 49: 15, 50: 16, 51: 17, 52: 24, 53: 25, 54: 26, 55: 27, 56: 28, 57: 29, 58: 36, 59: 37, 60: 38, 61: 39, 62: 40, 63: 41, 64: 48, 65: 49, 66: 50, 67: 51, 68: 52, 69: 53, 70: 60, 71: 61, 72: 62, 73: 63, 74: 64, 75: 65, 76: 70, 77: 71, 78: 72, 79: 73, 80: 76, 81: 77, 82: 79, 83: 83, 84: 84, 85: 85}

The number of keys in the layer is different from the number of keys in the conversion dictionary, please double check the input files.
```

All the defined layers have 86 entries, the undefined layers just are `[],`

My JSON hasn't been modified.

### QMK Kinesis Layer Theory
| Layer | Kind          | Purpose                                               |
|-------|------------|----------------------------------------------------------|
| 0     | Always Active                    | Dvorak                             |
| 3     | Toggles to Active & Default      | QWERTY                             |
| 12    | Momentary                        | Number Pad                         |
| 13    | Momentary                        | Arrows                             |
| 15    | Momentary                        | Layer Toggles, Keyboard Management |

afonsoguerra, 2024-02-26:
Hey @conceptual-perception, I’ll be very happy to help you out, but I’m all over the place for a few days. Maybe next week (early March?). In the meantime, can you figure out why you have 86 keys and I seem to have 85? I’m sure you can just add another entry to the dictionary in the script, to make it 86, and it will run but I am not sure the effect will be a good one because I don’t know where the extra key is coming from.

afonsoguerra, 2024-02-26:
P.S. - The quick fix would just paste 86 “KC_TRANS”, in the empty layers in your original JSON :)

Thread 78 (2024-01-02):

Teensy 4.1 with headers

edmonds, 2024-01-02:
Hi,

I saw the answer to https://github.com/kinx-project/kint/issues/43 and watched the soldering video, but I wanted to confirm. If I don't need any LEDs, can I avoid soldering those components (the SMD LEDs, resistors, and the vertical pin header), and use the [Teensy 4.1 DEV-20360](https://www.sparkfun.com/products/20360) variant that includes pre-attached headers? Or are those components required for some reason?

Thanks!

stapelberg, 2024-01-03:
The LEDs, their resistors and the vertical pin header can be left off; this is even listed as an advantage of the kinT design:

> The kinT makes possible lower-cost builds: if you don’t need the scroll lock, num lock and keypad LEDs, you can use a Teensy LC for merely 11 USD.

Do note that if you buy a Teensy with headers, you might need to clip off the headers below the board in case they stick out too much (not entirely sure if that’s a problem).

edmonds, 2024-02-03:
Just to close the loop on this, I built a kinT without LEDs using the Teensy 4.1 with pre-attached headers and it worked just fine. I trimmed the headers down to a proper length for soldering, not sure if it would have fit into the case without trimming but they do stick out a fair bit if not trimmed.

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

Closed 2024-01-03.

Thread 79 (2024-02-26):

Kint Controller mapped to RP2040 - Possible not-too-tedious solution

oneleaftea, 2024-02-26:
Sorry if this Issues section is not the best place to talk about this. No issue with the Kint controller, but I have been looking into STM32 or RP2040 solutions that can be dropped into the Kint controller with some modification. I have a bunch of PCB's so would prefer to use them rather than make a new board based on a new controller (I know the Black Pill version is out there as well, but I've had more experience with the RP2040 and love how easy it is to load the firmware).

I believe I have finally found a solution. Some background:

- I have built with the Waveshare RP2040-Zero and the classic super-cheap RP2040 Pico. The latter would be the best option, with 29 GPIO pins. However, the biggest problem is that the across-board pin-to-pin width of the board is 2.54mm wider than the Teensy (17.78mm for the RP vs 15.24mm for the Teensy).
- Most of the Pro-Micro form factor RP2040 have too few pins.
- But I finally found the Keebio Elite-Pi, which has the same form factor as the Pro-Micro (so same across-board pin-to-pin width as the Teensy) but has the extra pins at the bottom edge. It has 25 GPIO pins (GP10 and GP11 are connected to ground unless two traces are cut, which their documentation covers). This allows us to connect 3 LED's. The below picture would leave off the Keypad LED, but you could pick any LED to leave off.

In the below picture, the black rectangles show the header pins you would use, where you can connect directly to the Kint controller PCB. So basically 12 headers on one side and 8 headers on the other. Plenty stable IMO. The rest would have the board hanging and wires going from the original Teensy-based holes to the corresponding Elite-Pi pins. As you can see, it would take 7 wires.

Based on my picture, I think this is a fairly easy procedure. I've done much worse. Any thoughts or see any possible issues? Appreciate any thoughts!

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

stapelberg, 2024-02-26:
Thanks for opening this issue!

I don’t have time to look at the wiring details right now (sorry!), but I just wanted to say that this is a good place to talk about a RP2040 version of the board :)

oneleaftea, 2024-02-26:
Great! And just a quick note to anyone following. I found another cheaper board (it's a Pro Micro footprint RP2040 on Aliexpress with 27 GPIO pins. So it would cover all the LED's we need with a pin to spare. But until I get it in my hands, I'm not as confident in it as I am with the Elite-Pi. It would also need 10 wires, so a bit more tedious than the Elite-C. I did make a wiring diagram, but will doublecheck it a bit before I post it.

oneleaftea, 2024-03-08:
For those that want more detailed instructions and a proper wiring diagram, you can see this repo I just setup: https://github.com/oneleaftea/KinT_RP2040_Mod

Thread 80 (2024-03-01):

Teensy Loader on 4.1 reboots into HalfKay (requires unplugging and replugging keyboard)

oneleaftea, 2024-03-01:
Has anyone had this issue with Teensy 4.1? When using the Teensy Loader, I am able to program and reboot, but it goes right back into HalfKay. The verbose output shows that it is still online and ready to be flashed. And so the keyboard doesn't work unless I unplug and replug in the keyboard. The firmware is properly loaded and no error in the verbose output (it does say something about the .elf file and it being an unknown board though?).

Is the only way to get out of programming mode to unplug and replug in the keyboard?

I have also noticed that the Teensy Loader seems to take a minute after pressing the reset button before it is ready to flash.

Curious what other people's experiences are with flashing the unit? Otherwise, it is working great and all the features I need are working. Thanks again for such a great project!

oneleaftea, 2024-03-01:
Oh, I just found out that the Issue #77 actually could be related to this. I just implemented the fix that @isaacgale proposed to my rules.mk, and the bootloader went perfectly smooth this time! Rebooted directly into a working keyboard without having to unplug and replug.

Feel free to close or we can leave this open for visibility. Thanks!

stapelberg, 2024-03-04:
Would you mind sending that fix upstream to QMK? Thank you

oneleaftea, 2024-03-04:
> Would you mind sending that fix upstream to QMK? Thank you

Hello, I does seem like someone attempted a pull request on this and it was rejected. [Pull Request # 23054](https://github.com/qmk/qmk_firmware/pull/23054).

I read over the pull request and felt like the submitter made as good a case as any for them to accept the pull request, but they concluded that it is a fix that needs to be taken up with ChibiOS.

Thread 81 (2024-03-27):

Jumper locations and other teensy++ clarifications?

256k, 2024-03-27:
Hello, I've have the boards printed for a long time and i've finally come around to installing it into my kinesis.

I just had a few notes and questions to clarify to be sure i dont make a mistake:

1. the teensy++ you say i need to cut traces:
"Using a small knife such as a hobby knife, cut the traces between the pads of jumpers JP4, JP5, and JP6. This will disconnect pin 7, pin 15 and pin 16."
I'm not sure exactly where those jumpers are? on the kinT board i only see J1/J2/J3 next to it the text: "Compat w/ teensy++"
has the board design changed but not the documentation?

2. I'm modifiying a very very old kinesis (The essential: KB132PC) with the hard PCB molex connector points so i will be handwiring the connectors into the board. anything about this super old board that i would need to know? from my limited research it seems like the wiring should be the same?

3. looking at the schematics pdf i see there's 2 references to wiring:
https://github.com/kinx-project/kint/blob/44e6c8be96a0e1e13ada5eafdeba8c51a2d6c9e8/schematic-v2020-06-23.pdf
"original matrix wiring" and "HumbleHacker matrix wiring"
I'm not sure i understand the difference? is this something i need to take into consideration?

Thank you for this great work and giving new life to older kinesis boards that might be a bit too long in the tooth.

stapelberg, 2024-03-27:
Can you share which revision of the kinT you have? That will allow me to give a more helpful answer.

256k, 2024-03-27:
yes of course sorry for not clarifying. looking at the board seems i have `v2020-06-30`

stapelberg, 2024-03-28:
You can browse the changes since v2020-06-30 here: https://github.com/kinx-project/kint/compare/v2020-06-30...main

In particular, this is the README as of the version you have: https://github.com/kinx-project/kint/tree/ae11c62d8600c0019aa810abf71808ad528f5c99?tab=readme-ov-file — here you’ll find the soldering instructions that match your version of the board.

See https://github.com/kinx-project/kint/issues/42 for more details on older versions like the Kinesis Essential.

You don’t need to care about the matrix wiring, I think. The kinT controller uses the HumbleHacker matrix wiring, which was an older hobbyist replacement controller from 10+ years ago. This is only documented so that the full schematic is available in case you need to tinker more or adapt the board to other keyboards, or similar.

Hope this helps

256k, 2024-03-28:
fantastic thank you so much.

one last question, would you be able to tell me the part number/specs of the ribbon cable that would connect 2 of those molex connectors together? since i have the older kinesis it's a pain in the a** to wire it manually and i was hopingto use a flexible ribbon like on the newer kinesis instead. just dont know exactly what is the part number i need to get

stapelberg, 2024-04-09:
Unfortunately I don’t have that part number handy, as I never bought a spare FFC ribbon cable.

What I can say:

Look for a molex 13-pin FPC/FFC cable with 1.25mm spacing.
It should be compatible with https://octopart.com/39-53-2135-molex-7670149?r=sp in case that helps.

Please share the part number you ended up with in the end :)

Thread 82 (2024-04-10):

Question regarding BOM

stapelberg, 2024-04-10:
The "full BOM" excludes the kinT and Teensy, correct? So we need only buy the "full BOM" and the correct Teensy - and we can then print the latest KinT PCB?

_Originally posted by @dm17 in https://github.com/kinx-project/kint/issues/67#issuecomment-2046538172_

stapelberg, 2024-04-10:
> The "full BOM" excludes the kinT and Teensy, correct?

Yes. The BOM only contains the components to solder onto the board.

The board itself is not included because there is no octopart entry for it — it needs to be manufactured and can’t be bought from the usual electronics distributors.

The teensy is not included because it’s up to your needs and preferences to select one.

> So we need only buy the "full BOM" and the correct Teensy - and we can then print the latest KinT PCB?

Yes.

It sounds like you’re not experienced with these kinds of DIY electronics projects. I recommend finding a local makerspace, hackerspace, fablab, or similar to help out if in doubt.

Closed 2024-04-10.

Thread 83 (2024-07-05):

Left keywell row intermittent issues

ttttcrngyblflpp, 2024-07-05:
The left half of my keyboard has intermittent issues where sometimes a row of keys, e.g. the home row, will not work, or pressing a key in a row causes all other keys in the row to be actuated as well. When this happens I usually open up the keyboard and put it back together and then it goes away again...

I've tried following the troubleshooting resources available, which makes me think that this isn't an issue with the PCB, but possibly with the soldering on the keywell itself, probably the ribbon cable port? Any help would be appreciated.

stapelberg, 2024-07-06:
> I've tried following the troubleshooting resources available,

Can you list what specifically you have tried? Maybe something else comes to mind then.

> which makes me think that this isn't an issue with the PCB, but possibly with the soldering on the keywell itself, probably the ribbon cable port? Any help would be appreciated.

Could be anything. Most common are bad solder points. You could just re-solder all connections relevant to the affected keywell.

Less common, but also possible are bad traces on the PCB (caused by wear and tear). In that case, you would need to solder in a cable to bridge the sometimes-broken trace. These are hard to find, though — maybe apply a voltmeter in continuity testing mode and flex the PCB a bit to see if the contact stays or is flaky.

Hope this helps and good luck with finding the issue!

afonsoguerra, 2024-07-06:
Just to add my experience. With use and if you take the molex ribbons in and out a few times, they might get bent corners and as such they can go in slightly sideways. This causes some tracks to not connect properly. I suggest you remove the molex ribbons from both sides, clean it a bit, inspect it and re-seat it properly and see if the problem goes away. You can also swap ribbons within the keyboard and see if the problem shifts to a different area of the keyboard. Thankfully, the ribbons themselves are not too hard to source and replace if that is your problem.

stapelberg, 2024-07-07:
@afonsoguerra Could you share where you sourced a working ribbon cable? Do you have a link / model name perhaps? Thank you

afonsoguerra, 2024-07-07:
I got mine from RS: https://uk.rs-online.com/web/c/?searchTerm=molex+ribbon&sra=oss&r=t

I'll make a note to check for the part-number and I'll edit this when I find the order.

stapelberg, 2024-07-08:
Thanks @afonsoguerra, I added this info to the README :)

ttttcrngyblflpp, 2025-01-13:
I ended up ordering new PCBs and soldering a whole new set of parts together from leftover parts and it seems like it's working. As a software engineer who is a novice to soldering I did not have any respect for the possibility of soldering issues, so let this be a warning to anyone reading this that make sure you don't have any cold joints or not-enough-solder joints.

Closed 2025-01-13.

Thread 84 (2024-07-16):

Teensy 4.1: do we need to connect the vertical header?

stapelberg, 2024-07-16:
Hi
for Teensy 4.1 do we need to connect the vertical header?

_Originally posted by @justrajdeep in https://github.com/kinx-project/kint/issues/13#issuecomment-2229604489_

stapelberg, 2024-07-16:
Hey @justrajdeep

As the README describes: the vertical header is required if you want to use the LEDs.

If you plan to not use LEDs, you don’t need to connect the vertical header.

Closed 2024-07-16.

Thread 85 (2024-09-23):

Top row pcb slot in replacement

epichub, 2024-09-23:
Hi - I have two modded advantages now (KB500 and KB600) - and I owe you a great thanks - as you were the protagonist in this kinesis modding community :)

Anyway - my latest project is to get my favourite switches in the function key row.
I see the kin80 project has a solution, but its not slot in replacement that works with kint (different pinout on the new pcb).
I have tried asking - but I guess the developer has moved on ( https://github.com/DmNosachev/kin80/issues/1 )

I am however sure that it could not be _that_ hard to look at DmNosachev top pcb design - and the actual kb600 pcb and figure out how to make a MX compatible top-pcb that is also slot in compatible with kint and kint-derivates?
Do you have any ideas on how one should start mapping out the feasibility of such a project?

stapelberg, 2024-09-23:
Hey @epichub, I’m glad the project was helpful for you.

I was surprised to see this mod is possible until I realized that kin80 only has 6 function keys, whereas the Kinesis Advantage 2 has 9 function keys. I assume you’re okay with the missing keys, but figured I’d point out this difference just in case…

I recommend consulting the following blog post regarding the keyboard matrix:
https://web.archive.org/web/20110830010827/http://humblehacker.com/blog/20100720/hacking-the-kinesis-contoured-keyboard/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

Aside from arranging the electrical connections in the right order, you also need to interface with the ribbon cable (or modify the kinT board).

With enough patience and motivation this seems doable, but it will certainly be helpful if you have any friends who are more versed in electronics to guide you in the process. Maybe there’s a local makerspace / hackerspace where you live?

Thread 88 (2025-09-09):

Boot key does not set Teensy 4.1 to bootloader mode in custom firmware

sockbot, 2025-09-09:
When I use the default firmware on a Teensy 4.1, the mapped boot key sets the Teensy into bootloader mode.

When I compile a custom firmware with the configurator at https://config.qmk.fm/#/kinesis/kint41/LAYOUT pressing the boot key makes the Teensy and the keyboard unresponsive until power cycled.

To reproduce, compile this keyboard layout and press the boot key:

[kinesis_kint41_layout_2025-09-08.json](https://github.com/user-attachments/files/22224271/kinesis_kint41_layout_2025-09-08.json)

sockbot, 2025-09-09:
Symptoms may be related to this issue https://github.com/kinx-project/kint/issues/77

stapelberg, 2025-09-09:
Is this a duplicate of issue #80?

sockbot, 2025-09-13:
I'm not sure how to duplicate #80. I'm using teensy_loader_cli -- how do I see the state of the Teensy? I'm just going to try the fix in #77 to use an older version of qmk as a workaround.
