kinx-project/kint/schematic-v2021-06-26.pdf

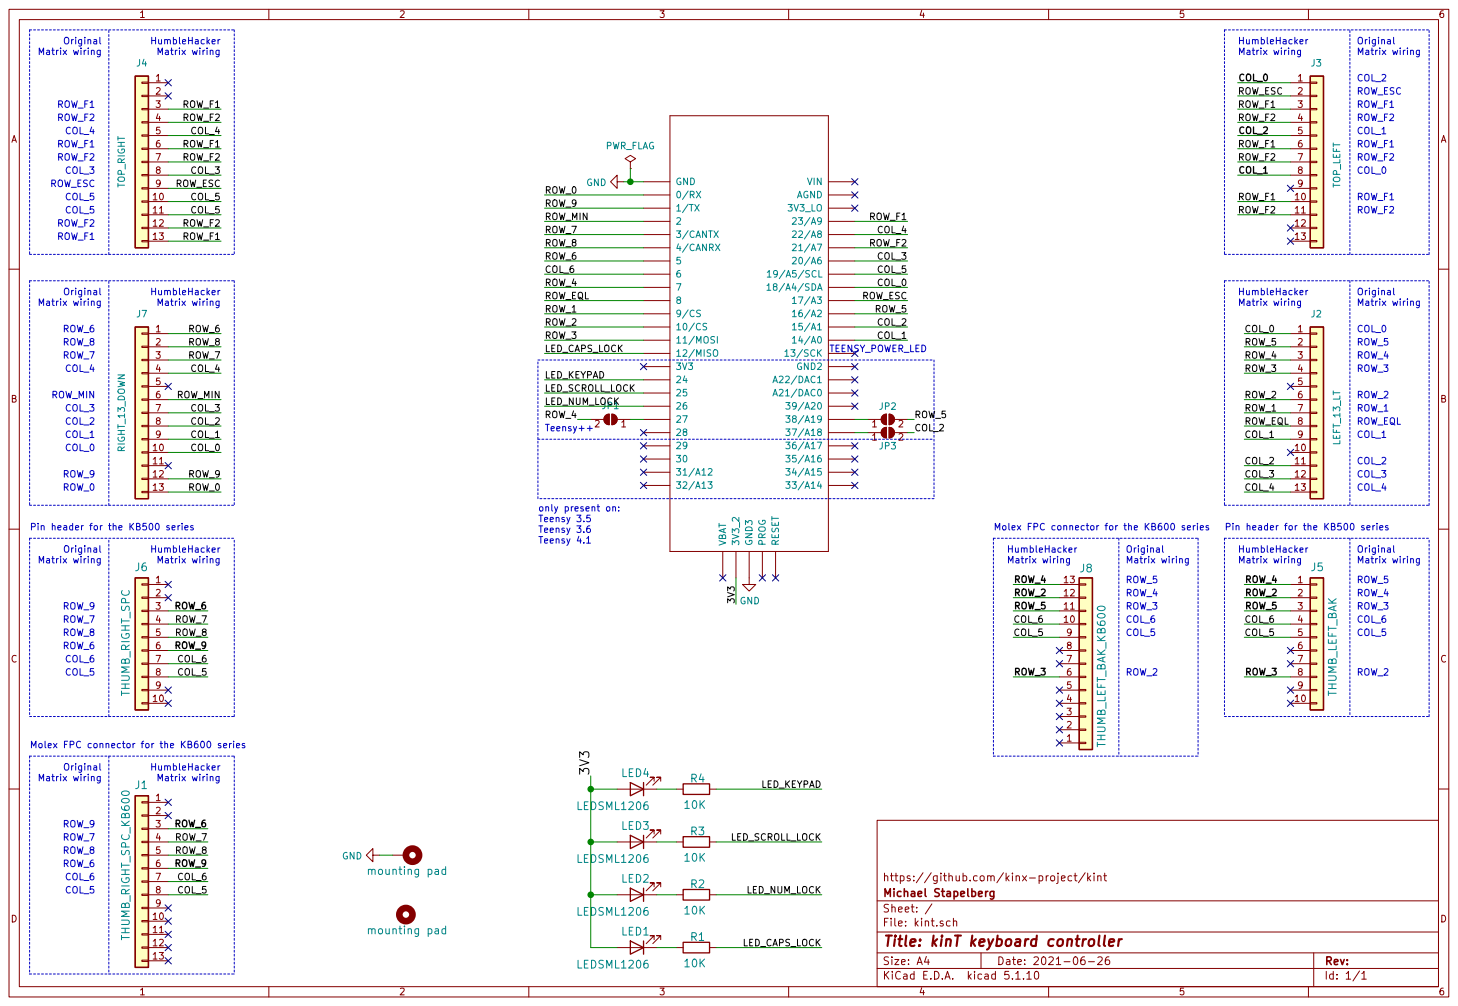
[picture p6: page 1]

LED_KEYPAD LED_SCROLL_LOCK LED_NUM_LOCK | 3V3 3V3_2 24 25 26 39/A20 27 38/A19 28 37/A18

Id: 1/1 Title: kinT keyboard controller File: kint.sch Sheet: / Michael Stapelberg
