kinx-project/kint/(commit log)

2013-01-30 add teensy++ eagle library
2013-01-30 remove onboard-connectors
2013-01-30 first autorouted version
    [untitled.brd, untitled.sch]
2013-01-30 board grid set to 1.25mm
    [untitled.brd]
2013-01-30 moved screen printing into free area
    [untitled.brd]
2013-01-30 fixed wiring
    [untitled.brd, untitled.sch]
2013-01-30 renamed nets to pinout
    [untitled.brd, untitled.sch]
2013-01-30 board finished
    [untitled.brd, untitled.sch]
2013-01-30 removed another via…
    [untitled.brd]
2013-01-31 version fuer drahtbruecken
    [untitled-bruecke.brd, untitled-bruecke.sch]
2013-01-31 less diagonal-routing below molex
    [untitled.brd]
2013-01-31 finally, one via left…
    [untitled.brd]
2013-01-31 some more connector cleanup
    [untitled.brd]
2013-01-31 circuit path alignment
    [untitled.brd]
2013-01-31 layout OK
    [untitled-bruecke.brd, untitled.brd]
2013-02-28 Board für die Fräse vorbereitet
    [untitled-bruecke.brd]
2013-02-28 Layout fertiggestellt fürs PCB
    [untitled-bruecke.brd, untitled.sch]
2013-03-21 2013-03-18: Löcher auf richtige Größe gebracht
    [untitled-bruecke.brd, untitled-bruecke.sch]
2017-12-09 Turn board and schematic into new revision: “kinX”
    The new controller revision uses a Teensy 3.6, which requires some rewiring.
    I used the chance to perform a bunch of cleanups:
    • Use SMD LEDs instead of THT (resistors were already SMD)
    • Move LED silkscreen labels to the correct side
    • Correct the names of all connectors to match the kinesis PCBs
    • Change the matrix to be easier to wire up
    [untitled-bruecke.brd, untitled-bruecke.sch]
2017-12-09 remove obsolete files
    [untitled.brd, untitled.sch]
2017-12-09 remove to kinx.{brd,sch}
    [kinx.brd, kinx.sch]
2018-02-11 schematic: fix ROW_6/ROW_9 (they were swapped)
    [kinx.brd, kinx.sch]
2020-06-07 switch from eagle to kicad
    [kinx.brd, kinx.kicad_pcb, kinx.sch]
2020-06-07 file → board setup → two layers with parts on front and back
    [kinx.kicad_pcb]
2020-06-07 silk screen: place connector labels inside for better visibility
    Also move part numbers to silk screen
    (on the outside, only need to be readable during assembly)
    [kinx.kicad_pcb]
2020-06-07 cleanups (wip)
    [kinx.kicad_pcb, kinx.sch]
2020-06-09 play around with molex library
    [kinx.kicad_pcb]
2020-06-09 schematic: add generic connector symbols for molex 13 pin FPC
    The names match
    http://humblehacker.com/blog/20100720/hacking-the-kinesis-contoured-keyboard/,
    which has a description of the matrix, with images.
    We should probably add one here, too, at some point.
    [kinx.kicad_pcb, kinx.sch]
2020-06-09 wire up left_13
    [kinx.sch]
2020-06-09 wire up right connector
    [kinx.sch]
2020-06-09 wire top right
    [kinx.sch]
2020-06-09 connect all the ports
    [kinx.sch]
2020-06-09 finishing touches
    [kinx.sch]
2020-06-09 thumb blocks
    [kinx.sch]
2020-06-09 re-create all labels
    [kinx.sch]
2020-06-09 nume thumb pads
    [kinx.sch]
2020-06-09 more space
    [kinx.sch]
2020-06-09 annotate with humblehacker matrix wiring
    [kinx.sch]
2020-06-09 move stuff around
    [kinx.sch]
2020-06-09 replace LED parts with kicad parts
    [kinx.sch]
2020-06-09 update board from schematic
    [kinx.kicad_pcb]
2020-06-09 remap for easier wiring
    [kinx.kicad_pcb, kinx.sch]
2020-06-09 fix pinout
    [kinx.sch]
2020-06-09 WIP routing
    [kinx.kicad_pcb, kinx.sch]
2020-06-14 route top part of the board
    [kinx.kicad_pcb, kinx.sch]
2020-06-14 route bottom part
    [kinx.kicad_pcb]
2020-06-14 molex footprint: remove background drawing, center around part
    [kinx.kicad_pcb, kinx.sch]
2020-06-14 add pinout to teensy front/bottom silk screen
    [kinx.kicad_pcb]
2020-06-14 teensy++ compatible pin connections
    [kinx.kicad_pcb, kinx.sch]
2020-06-14 silk screen improvements
    [kinx.kicad_pcb, kinx.sch]
2020-06-14 rename kinx->kint
    [kint.kicad_pcb, kint.sch]
2020-06-14 more silkscreen improvements
    [kint.kicad_pcb, kint.sch]
2020-06-14 move files into kicad/ directory
    [kint.kicad_pcb, kint.sch]
2020-06-14 gitignore: all kicad files
2020-06-14 add molex FPC part number to silk screen
    [kint.kicad_pcb]
2020-06-15 fix KB600 pinout
    [kint.kicad_pcb, kint.sch]
2020-06-15 square cutouts
    [kint.kicad_pcb]
2020-06-15 make some space at the edges of the PCB
    [kint.kicad_pcb]
2020-06-15 update schematic revision
    [kint.sch]
2020-06-15 update PCB revision
    [kint.kicad_pcb]
2020-06-20 README: describe possible teensy combinations
2020-06-23 move right_13_down and left_13_lt a few millimeters up
    For less strain on the FPC cables, on both KB500 and KB600.
    [kint.kicad_pcb]
2020-06-23 fix top mounting hole: was 5mm, should be 6mm
    [kint.kicad_pcb, kint.sch]
2020-06-23 teensy: add teensy++ 2.0 RST/GND/5V pins in correct spot
    They differ by one pin between the 3.x series and the teensy++.
    [kint.kicad_pcb]
2020-06-23 switch from 0R resistors to solder jumpers (thanks mxf)
    [kint.kicad_pcb, kint.sch]
2020-06-23 silkscreen: mark LED cathodes very explicitly
    [kint.kicad_pcb]
2020-06-23 silkscreen: add rectangle for adding own marker descriptions
    [kint.kicad_pcb]
2020-06-23 silkscreen: mark teensy++ do not connect pins with x
    [kint.kicad_pcb]
2020-06-23 bump revision to v2020-06-23
    [kint.kicad_pcb]
2020-06-23 give track some more space to the cutout
    [kint.kicad_pcb]
2020-06-23 update artifacts
    [kint.kicad_pcb, kint.sch]
2020-06-30 teensy: add vertical pins in teensy LC/3.2/4.0 position
2020-06-30 teensy: update silk screen to indicate sizes and compat
2020-06-30 adjust silkscreen, route traces to enable GND plane filling
    [kint.kicad_pcb]
2020-06-30 update artifacts for v2020-06-30
    [kint.kicad_pcb, kint.sch]
2020-08-08 README: link adapter board
2020-08-23 README: which teensy: add consideration regarding advanced QMK feats
2020-09-02 README: clarify solder instruction regarding vertical pin header
    related to https://github.com/kinx-project/kint/issues/13
2020-09-02 soldering instructions: link LED data sheet
    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
2021-01-02 added gerber file for jlcpcb (#20)
2021-01-07 Revert "added gerber file for jlcpcb (#20)" (#21)
    This reverts commit 2b1d9c87fc2a7dc78e976b8463c90cef5bcb5e96.
2021-02-02 Create pcb_confirmed_working_on_JLCPCB.zip (#23)
2021-02-23 README: update Teensy++ 2.0 situation
    as per https://www.pjrc.com/store/teensypp.html
2021-03-27 Update README (#26)
    6 10-pin headers are required for the Teensy's 53 pins
2021-03-28 README: update the other mention of the Teensy++ discontinuation
2021-03-31 kint36 support was merged into QMK 🎉
2021-04-25 Widen slots for compatibility with Aisler (#31)
    Aisler is a board service that introduced a budget service for "Simple"
    boards. KinT almost met the requirements, but these slots were too
    narrow. These zigzags make it so that the slots are always 2.4mm wide,
    but should still contact the posts and stabilize the board.
    fixes #27
    [kint.kicad_pcb]
2021-04-25 update artifacts for v2021-04-25
    [kint.kicad_pcb, kint.sch]
2021-04-26 set digikeypn, mouserpn and mpn fields where unambiguous
    This might make starting with your own BOM a little easier.
    The choice of the Teensy and mounting method (socket, pin headers, something
    else entirely?) is left to the user.
    [kint.sch]
2021-04-29 README: add aisler link (board verified to work)
2021-04-29 README: add pricing to board offers
2021-06-26 connect GND3 (Teensy vertical pin header) to GND
    This removes the unexpected opens from the design.
    fixes https://github.com/kinx-project/kint/issues/38
    [kint.kicad_pcb, kint.sch]
2021-06-26 update artifacts for v2021-06-26
    [kint.kicad_pcb, kint.sch]
2021-06-26 README: clarify LED debugging step only works without Teensy
2021-06-30 README: kint41 (Teensy 4.0 and 4.1) now supported by QMK! 🎉
2021-09-22 README: Teensy++ 2.0 is now discontinued
2021-09-22 README: no longer recommend the Teensy++ 2.0
2021-09-22 README: recommend Teensy 4.1, then Teensy 3.6
2021-09-22 README: made for Teensy 3.x and 4.x
2021-11-09 Update README.md (#44)
    https://forum.kicad.info/t/warning-avoid-all-links-to-kicad-pcb-org-use-kicad-org/31521
2022-01-29 Update to the new project file format (#47)
    I opened and saved the project and its schematic, PCB, etc. Some got
    saved with a different file name extension.
    `kinx-cache.lib` had to been renamed to `kint-cache.lib` otherwise the
    Schematic editor would complain that the file is missing. Then I
    removed it as I was told in the IRC channel that after saving the
    schematic in the new format, the symbols will be embedded and it's no
    longer needed.
    When opening the PCB there was a warning:
    > If the zones on this board are refilled the Copper Edge Clearance
    > setting will be used (see Board Setup > Design Rules > Constraints).
    > This may result in different fills from previous KiCad vers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
    [kint.kicad_pcb, kint.kicad_sch, kint.sch]
2022-04-15 Add more jumpers for Teensy++ 2.0 compat
    This avoids requiring folks to pull pins out of headers for Teensy++ 2.0
    compatibility, instead just requiring them to cut the traces, which I
    think is better and more importantly is reversible, so that if someone
    builds with a Teensy++ 2.0 and then wants to replace it with a 3.6, they
    can just re-close the new jumpers, desolder the old ones, and be good to
    go.
    [kint.kicad_pcb, kint.kicad_sch]
2022-05-13 Fix links to parts for socket headers and pins (#54)
    Slightly incorrect markdown syntax was preventing these links from rendering
    correctly.
2022-09-17 README: add note regarding net highlight in KiCad 6
2023-02-02 README: QMK Configuration was fixed for kint41 🎉
2023-07-18 Small elaborations to README (#69)
    USB cable options: enumerate, add links, add dashboard extension option
    from issue #9.
    Molex connectors: add tip about ensuring connection is deep and good.
2023-07-20 Minor README update (#70)
    Add my use case for installing a kinT keyboard controller.
    My Kinesis keyboard controller was failing.
2024-07-08 README: add ribbon cable replacement hint (Thanks afonsoguerra)
2025-06-06 README: link to QMK pull request for teensy 3.2 (#2) (#87)
