kinx-project/kint/(notices)

Notices in the files:
kicad/kint.kicad_pcb:
Open Hardware: CC-BY-SA
README.md:
License: CC BY-SA 4.0
